95jasmith/EMI-sensor/Building sensor/Code/Matlab/Flippo Farm/15_63030Hz.jpg

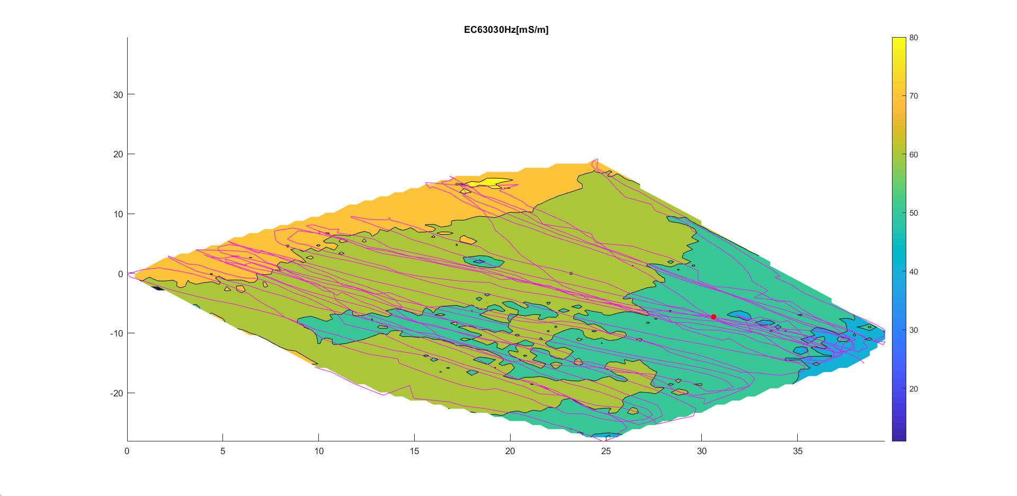
Building sensor/Code/Matlab/Flippo Farm/15_63030Hz.jpg
