95jasmith/EMI-sensor/Building sensor/Code/Matlab/Flippo Farm 2/TotalEC2.jpg

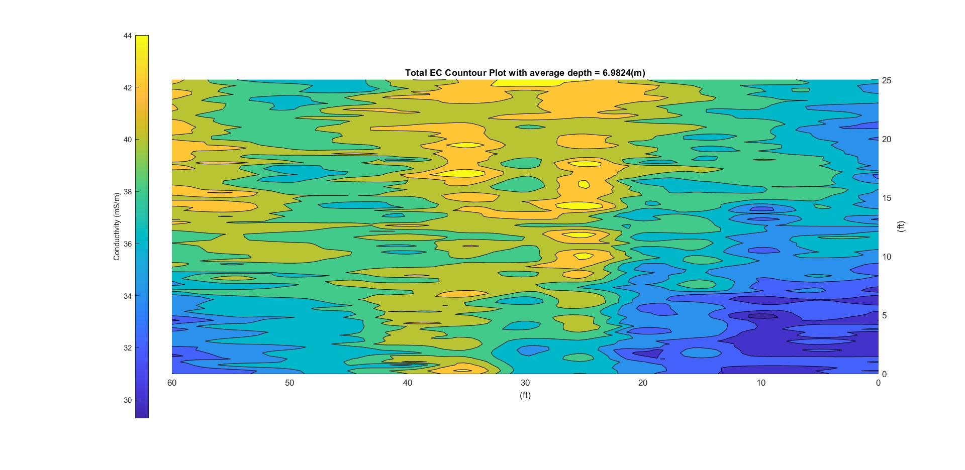
Building sensor/Code/Matlab/Flippo Farm 2/TotalEC2.jpg
