95jasmith/EMI-sensor/README.md

# EMI-sensor

This folder is for EMI conductivity meter being developed by Jonah Smith at Kansas State University for Dr. Stacey Kulesza in the Civil 
Engineering department.
All files are for the prototype and have only had limited testing.
