95jasmith/EMI-sensor/Building sensor/Code/FPGA/EMI_Sensor_FPGA/EMI_Sensor_FPGA_Implmnt/synlog/report/EMI_Sensor_FPGA_fpga_mapper_notes.txt

@N: MF248 |Running in 64-bit mode.
@N: MF666 |Clock conversion enabled. (Command "set_option -fix_gated_and_generated_clocks 1" in the project file.)
@N: MT206 |Auto Constrain mode is enabled
@N: BW103 |The default time unit for the Synopsys Constraint File (SDC or FDC) is 1ns.
@N: BW107 |Synopsys Constraint File capacitance units using default value of 1pF 
@N: FX1056 |Writing EDF file: C:\Users\97jsm\Documents\GitHub\EMI-sensor\Building sensor\Code\FPGA\EMI_Sensor_FPGA\EMI_Sensor_FPGA_Implmnt\EMI_Sensor_FPGA.edf
@N: MT320 |This timing report is an estimate of place and route data. For final timing results, use the FPGA vendor place and route report.
@N: MT322 |Clock constraints include only register-to-register paths associated with each individual clock.
