95jasmith/EMI-sensor/Building sensor/Code/FPGA/EMI_Sensor_FPGA/EMI_Sensor_FPGA_Implmnt/synlog/report/EMI_Sensor_FPGA_premap_notes.txt

@N: MF248 |Running in 64-bit mode.
@N: MF666 |Clock conversion enabled. (Command "set_option -fix_gated_and_generated_clocks 1" in the project file.)
@N: BN225 |Writing default property annotation file C:\Users\97jsm\Documents\GitHub\EMI-sensor\Building sensor\Code\FPGA\EMI_Sensor_FPGA\EMI_Sensor_FPGA_Implmnt\EMI_Sensor_FPGA.sap.
