95jasmith/EMI-sensor/Building sensor/Paper Summaries/McNeill 1980.docx

Title: | Electromagnetic Terrain Conductivity Measurement at Low Induction Numbers
Author(s): | JD McNeill
Date: | October, 1980
Publication: | Technical Report TN-6
Publisher: | Geonics: Mississauga, ON, Canada
Pages: | 1-15
Key Words:

Summary of the Paper

This is a core paper and is citied by most other papers. Introduces the idea of Apparent Electrical Conductivity (ECa). Also includes the assumptions for Low Induction Numbers (LIN) and the then derived linear approximation for finding ECa from the measured H-field. Also includes some case studies and methods for using there designed sensor to measure ECa
