95jasmith/EMI-sensor/Building sensor/Papers/GEM-2 uniform half-space response and skin depth (2).xls

Hz-S/m | I ppm | Q ppm
0.01 | 2e-05 | 0.03
0.1 | 0.0006 | 0.35
1 | 0.02 | 3.5
10 | 0.7 | 40
100 | 20 | 350
1000 | 500 | 3000
10000 | 9500 | 21000
100000 | 80000 | 70000
1000000 | 200000 | 40000
10000000 | 200000 | 5000
100000000 | 200000 | 250
from Won et al, 1996
GEM-2…
 |  |  |  |  |  |  |  |  |  |  | SKIN DEPTH = SQRT(2/(omega*sigma*mu))
 |  |  |  |  |  |  |  |  |  |  |  | frequency | conductivity | rel permeability
 |  |  |  |  |  |  |  |  |  |  |  | f(Hz) | sigma (mS/m) | non-dim
 |  | example: clay with conductivity of 12 mS/m |  |  |  |  |  |  |  | ENTER VALUES |  | 63030 | 13 | 1
 |  |  | sigma (mS/m) = |  | 13 |  |  |  |  | skin depth (m) = |  | 15.915X10^3 * SQRT(1/f*sigma*mur)
 |  |  | sigma (mS/m) |  | frequency (Hz) |  | I ppm | Q ppm
 |  |  |  |  |  |  |  |  |  | skin depth (m) = |  | 17.58
 |  |  | 13 |  | 450 | 5.85 | 0.4 | 23.2
 | computed values from |  | 13 |  | 870 | 11.31 | 1.0 | 44.5
 | interpolation of nomogram |  | 13 |  | 1710 | 22.23 | 3.3 | 82.1
 | above |  | 13 |  | 3330 | 43.29 | 7.8 | 154.7 | effective depth of penetration = SQRT(SKIN DEPTH) = |  |  |  |  | 4.2 | m
 |  |  | 13 |  | 6450 | 83.85 | 16.5 | 294.4
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
