95jasmith/EMI-sensor/GPS Stuff/gem2_GPS.JPG

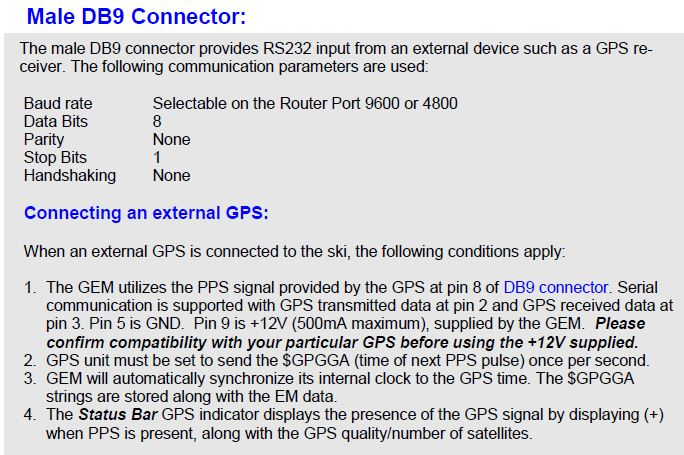
GPS Stuff/gem2_GPS.JPG
