95jasmith/EMI-sensor/Poster/Math 799 Poster1.jpg

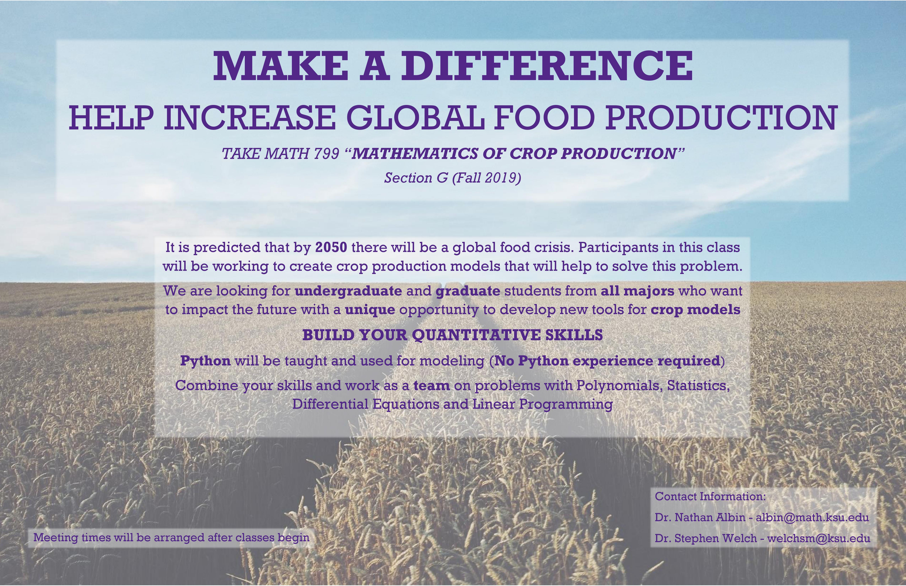
Poster/Math 799 Poster1.jpg
