95jasmith/EMI-sensor/Poster/wheat-691935_1920.jpg

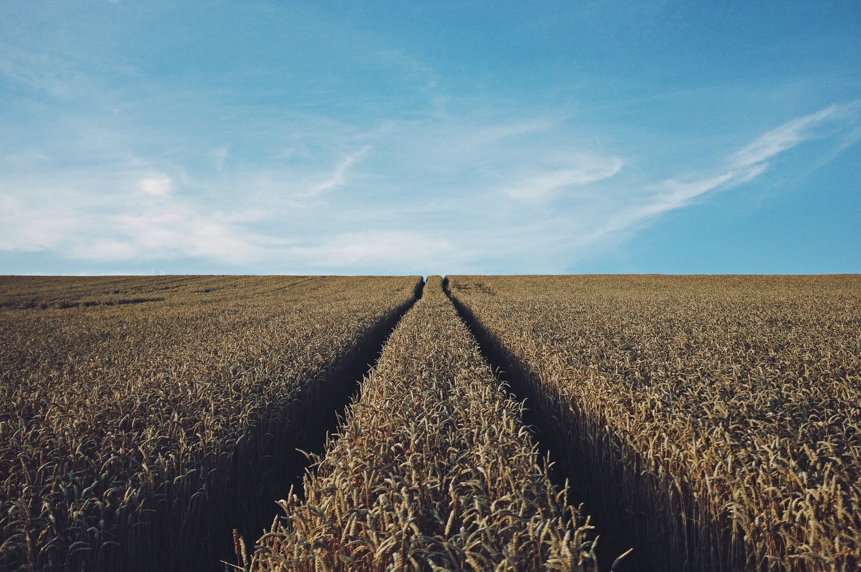
Poster/wheat-691935_1920.jpg
