95jasmith/EMI-sensor/Building sensor/Designs/KiCAD/2020-02-25_19-55-28/STEP/DDW44_8P26X4P31.step

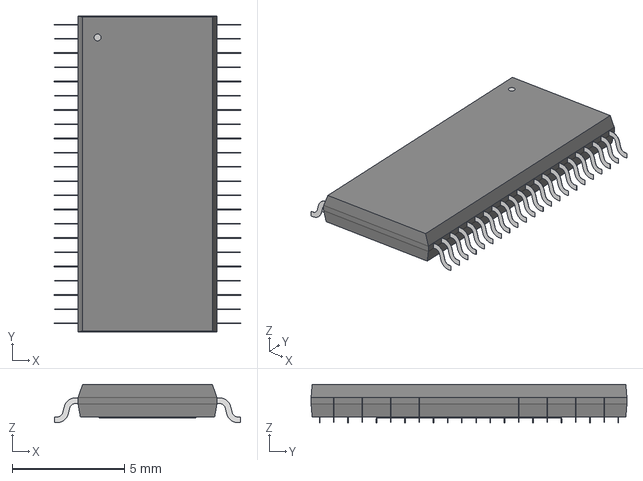
[picture p12: CAD file, 2020-02-27]
Building sensor/Designs/KiCAD/2020-02-25_19-55-28/STEP/DDW44_8P26X4P31.step
8.30 x 14.1 x 1.70 mm
