95jasmith/EMI-sensor/Building sensor/Designs/KiCAD/ul_BD65491FVE2/2020-02-20_15-11-28/STEP/SSOP-B16-L.step

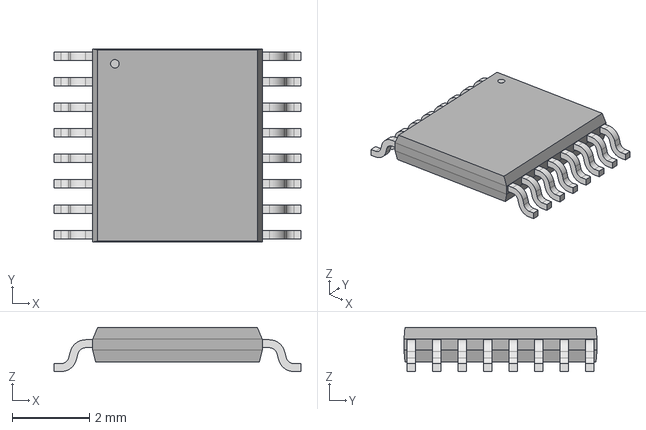
[picture p13: CAD file, 2020-02-27]
Building sensor/Designs/KiCAD/ul_BD65491FVE2/2020-02-20_15-11-28/STEP/SSOP-B16-L.step
6.40 x 5.00 x 1.15 mm
