95jasmith/EMI-sensor/(list of files, cad)

Other CAD files:
Building sensor/Designs/KiCAD/2020-02-25_19-55-50/STL/DDW44_8P26X4P31.stp
Building sensor/Designs/KiCAD/2020-02-25_19-55-28/STEP/DDW44_8P26X4P31-M.step
Building sensor/Designs/KiCAD/2020-02-25_19-55-50/STL/DDW44_8P26X4P31-M.stp
Building sensor/Designs/KiCAD/ul_BD65491FVE2/2020-02-20_15-11-28/STEP/SSOP-B16.step
Building sensor/Designs/KiCAD/ul_BD65491FVE2/2020-02-20_15-11-34/STL/SSOP-B16-M.stp
Building sensor/Designs/KiCAD/2020-02-25_19-55-28/STEP/DDW44_8P26X4P31-L.step
Building sensor/Designs/KiCAD/2020-02-25_19-55-50/STL/DDW44_8P26X4P31-L.stp
Building sensor/Designs/KiCAD/ul_BD65491FVE2/2020-02-20_15-11-28/STEP/SSOP-B16-M.step
Building sensor/Designs/KiCAD/ul_BD65491FVE2/2020-02-20_15-11-34/STL/SSOP-B16-L.stp
Building sensor/Designs/KiCAD/2020-02-25_19-55-50/STL/DDW44_8P26X4P31-L.stl
Building sensor/Designs/KiCAD/2020-02-25_19-55-50/STL/DDW44_8P26X4P31-M.stl
Building sensor/Designs/KiCAD/2020-02-25_19-55-50/STL/DDW44_8P26X4P31.stl
Building sensor/Designs/KiCAD/ul_BD65491FVE2/2020-02-20_15-11-34/STL/SSOP-B16-L.stl
Building sensor/Designs/KiCAD/ul_BD65491FVE2/2020-02-20_15-11-34/STL/SSOP-B16-M.stl
Building sensor/Designs/KiCAD/ul_BD65491FVE2/2020-02-20_15-11-34/STL/SSOP-B16.stl
