95jasmith/EMI-sensor/Building sensor/Code/FPGA/EMI_Sensor_FPGA/EMI_Sensor_FPGA_Implmnt/syntmp/EMI_Sensor_FPGA_srr.htm

#Build: Synplify Pro L-2016.09L+ice40, Build 077R, Dec  2 2016
#install: C:\lscc\iCEcube2.2017.08\synpbase
#OS: Windows 8 6.2
#Hostname: DESKTOP-E7PTEOJ

# Tue Oct 15 14:39:21 2019

#Implementation: EMI_Sensor_FPGA_Implmnt

Synopsys HDL Compiler, version comp2016q3p1, Build 141R, built Dec  5 2016
@N: :  | Running in 64-bit mode 
Copyright (C) 1994-2016 Synopsys, Inc. All rights reserved. This Synopsys software and all associated documentation are proprietary to Synopsys, Inc. and may only be used pursuant to the terms and conditions of a written license agreement with Synopsys, Inc. All other use, reproduction, modification, or distribution of the Synopsys software or the associated documentation is strictly prohibited.

Synopsys Verilog Compiler, version comp2016q3p1, Build 141R, built Dec  5 2016
@N: :  | Running in 64-bit mode 
Copyright (C) 1994-2016 Synopsys, Inc. All rights reserved. This Synopsys software and all associated documentation are proprietary to Synopsys, Inc. and may only be used pursuant to the terms and conditions of a written license agreement with Synopsys, Inc. All other use, reproduction, modification, or distribution of the Synopsys software or the associated documentation is strictly prohibited.

@I::"C:\lscc\iCEcube2.2017.08\synpbase\lib\generic\sb_ice40.v" (library work)
@I::"C:\lscc\iCEcube2.2017.08\synpbase\lib\vlog\hypermods.v" (library __hyper__lib__)
@I::"C:\lscc\iCEcube2.2017.08\synpbase\lib\vlog\umr_capim.v" (library snps_haps)
@I::"C:\lscc\iCEcube2.2017.08\synpbase\lib\vlog\scemi_objects.v" (library snps_haps)
@I::"C:\lscc\iCEcube2.2017.08\synpbase\lib\vlog\scemi_pipes.svh" (library snps_haps)
@I::"C:\Users\97jsm\Documents\GitHub\EMI-sensor\Building sensor\Code\FPGA\Toggle_Pin_Test.v" (library work)
Verilog syntax check successful!
File C:\Users\97jsm\Documents\GitHub\EMI-sensor\Building sensor\Code\FPGA\Toggle_Pin_Test.v changed - recompiling
Selecting top level module Toggle_Pin_Test
@N:CG364 : Toggle_Pin_Test.v(1) | Synthesizing module Toggle_Pin_Test in library work.

At c_ver Exit (Real Time elapsed 0h:00m:01s; CPU Time elapsed 0h:00m:00s; Memory used current: 70MB peak: 71MB)

Process took 0h:00m:01s realtime, 0h:00m:01s cputime

Process completed successfully.
# Tue Oct 15 14:39:23 2019

###########################################################]
Synopsys Netlist Linker, version comp2016q3p1, Build 141R, built Dec  5 2016
@N: :  | Running in 64-bit mode 
@N:NF107 : Toggle_Pin_Test.v(1) | Selected library: work cell: Toggle_Pin_Test view verilog as top level
@N:NF107 : Toggle_Pin_Test.v(1) | Selected library: work cell: Toggle_Pin_Test view verilog as top level

At syn_nfilter Exit (Real Time elapsed 0h:00m:00s; CPU Time elapsed 0h:00m:00s; Memory used current: 67MB peak: 68MB)

Process took 0h:00m:01s realtime, 0h:00m:01s cputime

Process completed successfully.
# Tue Oct 15 14:39:24 2019

###########################################################]
@END

At c_hdl Exit (Real Time elapsed 0h:00m:03s; CPU Time elapsed 0h:00m:01s; Memory used current: 3MB peak: 4MB)

Process took 0h:00m:03s realtime, 0h:00m:01s cputime

Process completed successfully.
# Tue Oct 15 14:39:24 2019

###########################################################]
Synopsys Netlist Linker, version comp2016q3p1, Build 141R, built Dec  5 2016
@N: :  | Running in 64-bit mode 
File C:\Users\97jsm\Documents\GitHub\EMI-sensor\Building sensor\Code\FPGA\EMI_Sensor_FPGA\EMI_Sensor_FPGA_Implmnt\synwork\EMI_Sensor_FPGA_comp.srs changed - recompiling
@N:NF107 : Toggle_Pin_Test.v(1) | Selected library: work cell: Toggle_Pin_Test view verilog as top level
@N:NF107 : Toggle_Pin_Test.v(1) | Selected library: work cell: Toggle_Pin_Test view verilog as top level

At syn_nfilter Exit (Real Time elapsed 0h:00m:00s; CPU Time elapsed 0h:00m:00s; Memory used current: 67MB peak: 68MB)

Process took 0h:00m:01s realtime, 0h:00m:01s cputime

Process completed successfully.
# Tue Oct 15 14:39:26 2019

###########################################################]
Pre-mapping Report

# Tue Oct 15 14:39:27 2019

Synopsys Lattice Technology Pre-mapping, Version maplat, Build 1612R, Built Dec  5 2016 10:31:39
Copyright (C) 1994-2016 Synopsys, Inc. All rights reserved. This Synopsys software and all associated documentation are proprietary to Synopsys, Inc. and may only be used pursuant to the terms and conditions of a written license agreement with Synopsys, Inc. All other use, reproduction, modification, or distribution of the Synopsys software or the associated documentation is strictly prohibited.
Product Version L-2016.09L+ice40

Mapper Startup Complete (Real Time elapsed 0h:00m:00s; CPU Time elapsed 0h:00m:00s; Memory used current: 99MB peak: 100MB)

@A:MF827 :  | No constraint file specified. 
@L: C:\Users\97jsm\Documents\GitHub\EMI-sensor\Building sensor\Code\FPGA\EMI_Sensor_FPGA\EMI_Sensor_FPGA_Implmnt\EMI_Sensor_FPGA_scck.rpt 
Printing clock  summary report in "C:\Users\97jsm\Documents\GitHub\EMI-sensor\Building sensor\Code\FPGA\EMI_Sensor_FPGA\EMI_Sensor_FPGA_Implmnt\EMI_Sensor_FPGA_scck.rpt" file 
@N:MF248 :  | Running in 64-bit mode. 
@N:MF666 :  | Clock conversion enabled. (Command "set_option -fix_gated_and_generated_clocks 1" in the project file.) 

Design Input Complete (Real Time elapsed 0h:00m:00s; CPU Time elapsed 0h:00m:00s; Memory used current: 100MB peak: 102MB)

Mapper Initialization Complete (Real Time elapsed 0h:00m:00s; CPU Time elapsed 0h:00m:00s; Memory used current: 100MB peak: 102MB)

Start loading timing files (Real Time elapsed 0h:00m:00s; CPU Time elapsed 0h:00m:00s; Memory used current: 101MB peak: 102MB)

Finished loading timing files (Real Time elapsed 0h:00m:00s; CPU Time elapsed 0h:00m:00s; Memory used current: 101MB peak: 103MB)

ICG Latch Removal Summary:
Number of ICG latches removed:	0
Number of ICG latches not removed:	0
syn_allowed_resources : blockrams=30  set on top level netlist Toggle_Pin_Test

Finished netlist restructuring (Real Time elapsed 0h:00m:02s; CPU Time elapsed 0h:00m:01s; Memory used current: 132MB peak: 134MB)

Clock Summary
*****************

Start     Requested     Requested     Clock     Clock     Clock
Clock     Frequency     Period        Type      Group     Load 
---------------------------------------------------------------
===============================================================

Finished Pre Mapping Phase.
@N:BN225 :  | Writing default property annotation file C:\Users\97jsm\Documents\GitHub\EMI-sensor\Building sensor\Code\FPGA\EMI_Sensor_FPGA\EMI_Sensor_FPGA_Implmnt\EMI_Sensor_FPGA.sap. 

Starting constraint checker (Real Time elapsed 0h:00m:02s; CPU Time elapsed 0h:00m:02s; Memory used current: 132MB peak: 134MB)

None
None

Finished constraint checker (Real Time elapsed 0h:00m:02s; CPU Time elapsed 0h:00m:02s; Memory used current: 132MB peak: 134MB)

Pre-mapping successful!

At Mapper Exit (Real Time elapsed 0h:00m:03s; CPU Time elapsed 0h:00m:02s; Memory used current: 47MB peak: 134MB)

Process took 0h:00m:03s realtime, 0h:00m:02s cputime
# Tue Oct 15 14:39:31 2019

###########################################################]
Map & Optimize Report

# Tue Oct 15 14:39:32 2019

Synopsys Lattice Technology Mapper, Version maplat, Build 1612R, Built Dec  5 2016 10:31:39
Copyright (C) 1994-2016 Synopsys, Inc. All rights reserved. This Synopsys software and all associated documentation are proprietary to Synopsys, Inc. and may only be used pursuant to the terms and conditions of a written license agreement with Synopsys, Inc. All other use, reproduction, modification, or distribution of the Synopsys software or the associated documentation is strictly prohibited.
Product Version L-2016.09L+ice40

Mapper Startup Complete (Real Time elapsed 0h:00m:00s; CPU Time elapsed 0h:00m:00s; Memory used current: 99MB peak: 100MB)

@N:MF248 :  | Running in 64-bit mode. 
@N:MF666 :  | Clock conversion enabled. (Command "set_option -fix_gated_and_generated_clocks 1" in the project file.) 

Design Input Complete (Real Time elapsed 0h:00m:00s; CPU Time elapsed 0h:00m:00s; Memory used current: 100MB peak: 101MB)

Mapper Initialization Complete (Real Time elapsed 0h:00m:00s; CPU Time elapsed 0h:00m:00s; Memory used current: 100MB peak: 101MB)

Start loading timing files (Real Time elapsed 0h:00m:00s; CPU Time elapsed 0h:00m:00s; Memory used current: 101MB peak: 102MB)

Finished loading timing files (Real Time elapsed 0h:00m:00s; CPU Time elapsed 0h:00m:00s; Memory used current: 101MB peak: 104MB)

Starting Optimization and Mapping (Real Time elapsed 0h:00m:01s; CPU Time elapsed 0h:00m:01s; Memory used current: 132MB peak: 134MB)

Available hyper_sources - for debug and ip models
	None Found

@N:MT206 :  | Auto Constrain mode is enabled 

Finished RTL optimizations (Real Time elapsed 0h:00m:01s; CPU Time elapsed 0h:00m:01s; Memory used current: 132MB peak: 134MB)

Starting factoring (Real Time elapsed 0h:00m:01s; CPU Time elapsed 0h:00m:01s; Memory used current: 132MB peak: 134MB)

Finished factoring (Real Time elapsed 0h:00m:01s; CPU Time elapsed 0h:00m:01s; Memory used current: 132MB peak: 134MB)

Finished gated-clock and generated-clock conversion (Real Time elapsed 0h:00m:01s; CPU Time elapsed 0h:00m:01s; Memory used current: 132MB peak: 134MB)

Finished generic timing optimizations - Pass 1 (Real Time elapsed 0h:00m:01s; CPU Time elapsed 0h:00m:01s; Memory used current: 132MB peak: 134MB)

Starting Early Timing Optimization (Real Time elapsed 0h:00m:01s; CPU Time elapsed 0h:00m:01s; Memory used current: 132MB peak: 134MB)

Finished Early Timing Optimization (Real Time elapsed 0h:00m:01s; CPU Time elapsed 0h:00m:01s; Memory used current: 132MB peak: 134MB)

Finished generic timing optimizations - Pass 2 (Real Time elapsed 0h:00m:01s; CPU Time elapsed 0h:00m:01s; Memory used current: 132MB peak: 134MB)

Finished preparing to map (Real Time elapsed 0h:00m:01s; CPU Time elapsed 0h:00m:01s; Memory used current: 132MB peak: 134MB)

Finished technology mapping (Real Time elapsed 0h:00m:01s; CPU Time elapsed 0h:00m:01s; Memory used current: 132MB peak: 134MB)

Pass		 CPU time		Worst Slack		Luts / Registers
------------------------------------------------------------

Finished technology timing optimizations and critical path resynthesis (Real Time elapsed 0h:00m:01s; CPU Time elapsed 0h:00m:01s; Memory used current: 132MB peak: 134MB)

Finished restoring hierarchy (Real Time elapsed 0h:00m:01s; CPU Time elapsed 0h:00m:01s; Memory used current: 132MB peak: 134MB)

@S |Clock Optimization Summary

#### START OF CLOCK OPTIMIZATION REPORT #####[

0 non-gated/non-generated clock tree(s) driving 0 clock pin(s) of sequential element(s)
0 gated/generated clock tree(s) driving 0 clock pin(s) of sequential element(s)
0 instances converted, 0 sequential instances remain driven by gated/generated clocks

##### END OF CLOCK OPTIMIZATION REPORT ######]

Start Writing Netlists (Real Time elapsed 0h:00m:02s; CPU Time elapsed 0h:00m:01s; Memory used current: 107MB peak: 134MB)

Writing Analyst data base C:\Users\97jsm\Documents\GitHub\EMI-sensor\Building sensor\Code\FPGA\EMI_Sensor_FPGA\EMI_Sensor_FPGA_Implmnt\synwork\EMI_Sensor_FPGA_m.srm

Finished Writing Netlist Databases (Real Time elapsed 0h:00m:02s; CPU Time elapsed 0h:00m:02s; Memory used current: 131MB peak: 134MB)

Writing EDIF Netlist and constraint files
@N:BW103 :  | The default time unit for the Synopsys Constraint File (SDC or FDC) is 1ns. 
@N:BW107 :  | Synopsys Constraint File capacitance units using default value of 1pF  
@N:FX1056 :  | Writing EDF file: C:\Users\97jsm\Documents\GitHub\EMI-sensor\Building sensor\Code\FPGA\EMI_Sensor_FPGA\EMI_Sensor_FPGA_Implmnt\EMI_Sensor_FPGA.edf 
L-2016.09L+ice40

Finished Writing EDIF Netlist and constraint files (Real Time elapsed 0h:00m:03s; CPU Time elapsed 0h:00m:03s; Memory used current: 132MB peak: 134MB)

Start final timing analysis (Real Time elapsed 0h:00m:04s; CPU Time elapsed 0h:00m:03s; Memory used current: 132MB peak: 134MB)

##### START OF TIMING REPORT #####[
# Timing Report written on Tue Oct 15 14:39:36 2019
#

Top view:               Toggle_Pin_Test
Requested Frequency:    1.0 MHz
Wire load mode:         top
Paths requested:        5
Constraint File(s):    
@N:MT320 :  | This timing report is an estimate of place and route data. For final timing results, use the FPGA vendor place and route report. 

@N:MT322 :  | Clock constraints include only register-to-register paths associated with each individual clock. 

Performance Summary
*******************

Worst slack in design: NA

Clock Relationships
*******************

Clocks            |    rise  to  rise   |    fall  to  fall   |    rise  to  fall   |    fall  to  rise 
--------------------------------------------------------------------------------------------------------
Starting  Ending  |  constraint  slack  |  constraint  slack  |  constraint  slack  |  constraint  slack
--------------------------------------------------------------------------------------------------------
========================================================================================================
 Note: 'No paths' indicates there are no paths in the design for that pair of clock edges.
       'Diff grp' indicates that paths exist but the starting clock and ending clock are in different clock groups.

Interface Information 
*********************

No IO constraint found

##### END OF TIMING REPORT #####]

Timing exceptions that could not be applied
None

Finished final timing analysis (Real Time elapsed 0h:00m:04s; CPU Time elapsed 0h:00m:03s; Memory used current: 133MB peak: 134MB)

Finished timing report (Real Time elapsed 0h:00m:04s; CPU Time elapsed 0h:00m:03s; Memory used current: 133MB peak: 134MB)

---------------------------------------
Resource Usage Report for Toggle_Pin_Test 

Mapping to part: ice40up5ksg48
Cell usage:
SB_LUT4         0 uses

I/O ports: 2
I/O primitives: 2
SB_IO          2 uses

I/O Register bits:                  0
Register bits not including I/Os:   0 (0%)
Total load per clock:

@S |Mapping Summary:
Total  LUTs: 0 (0%)

Mapper successful!

At Mapper Exit (Real Time elapsed 0h:00m:04s; CPU Time elapsed 0h:00m:04s; Memory used current: 27MB peak: 134MB)

Process took 0h:00m:05s realtime, 0h:00m:04s cputime
# Tue Oct 15 14:39:37 2019

###########################################################]
