95jasmith/EMI-sensor/Building sensor/Code/Matlab/Flippo Farm 2/EC5310Hz2.jpg

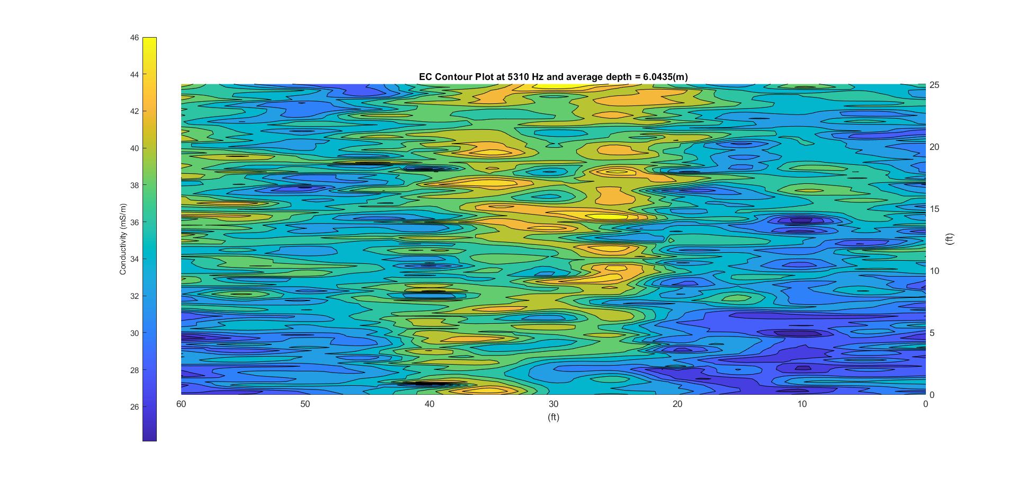
Building sensor/Code/Matlab/Flippo Farm 2/EC5310Hz2.jpg
