95jasmith/EMI-sensor/Building sensor/Code/Matlab/Flippo Farm 2/EC18330Hz.jpg

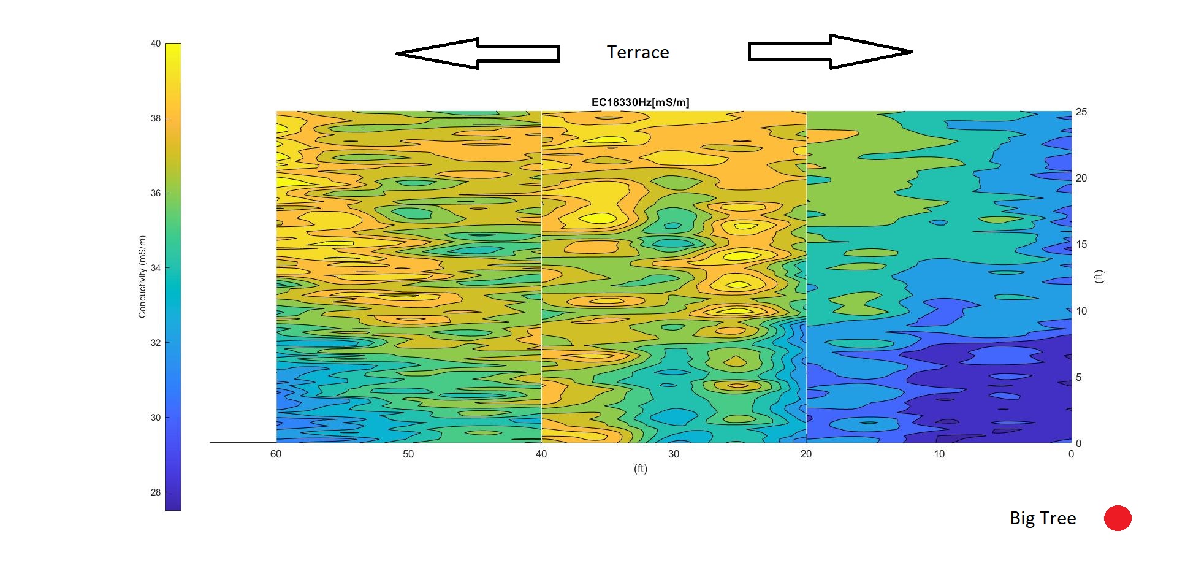
Building sensor/Code/Matlab/Flippo Farm 2/EC18330Hz.jpg
