95jasmith/EMI-sensor/Building sensor/Code/Matlab/Flippo Farm 2/EC63030Hz2.jpg

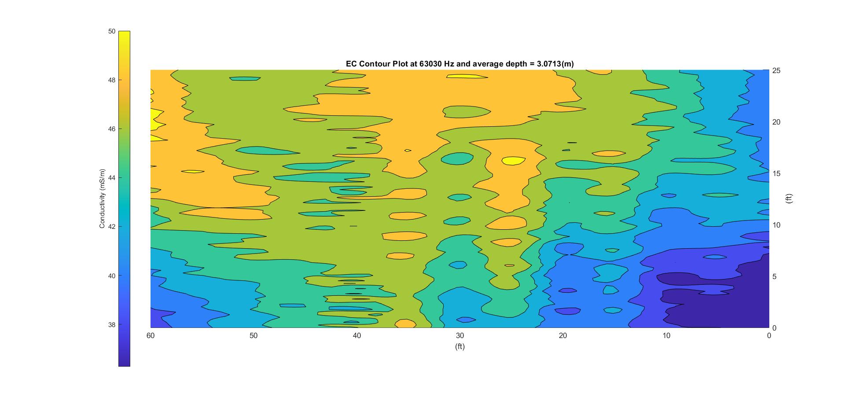
Building sensor/Code/Matlab/Flippo Farm 2/EC63030Hz2.jpg
