95jasmith/EMI-sensor/Building sensor/Code/Matlab/Flippo Farm/15_450Hz - Copy.jpg

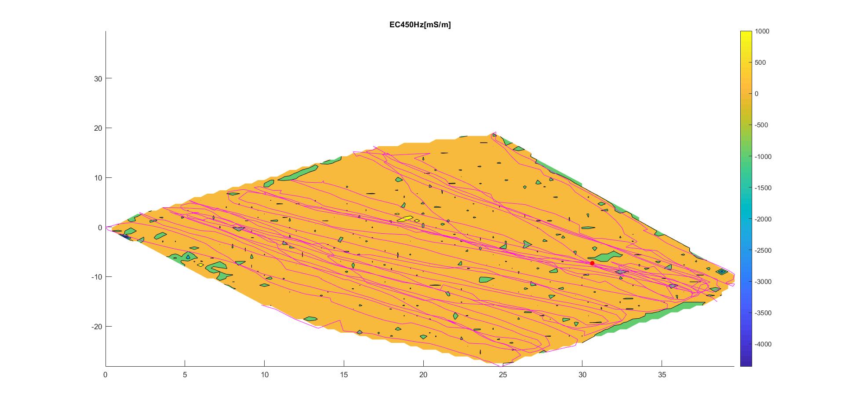
Building sensor/Code/Matlab/Flippo Farm/15_450Hz - Copy.jpg
