95jasmith/EMI-sensor/Building sensor/Code/Matlab/Flippo Farm/16_Total.jpg

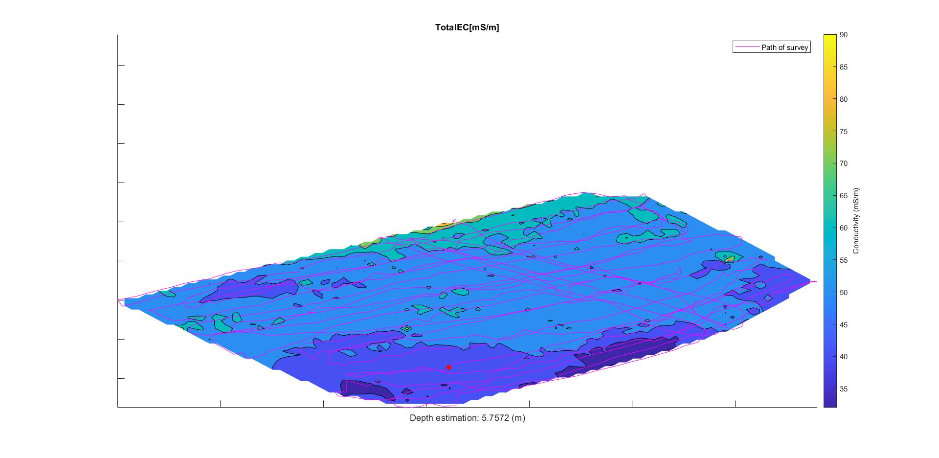
Building sensor/Code/Matlab/Flippo Farm/16_Total.jpg
