95jasmith/EMI-sensor/Building sensor/Code/Matlab/Flippo Farm/18_210Hz.jpg

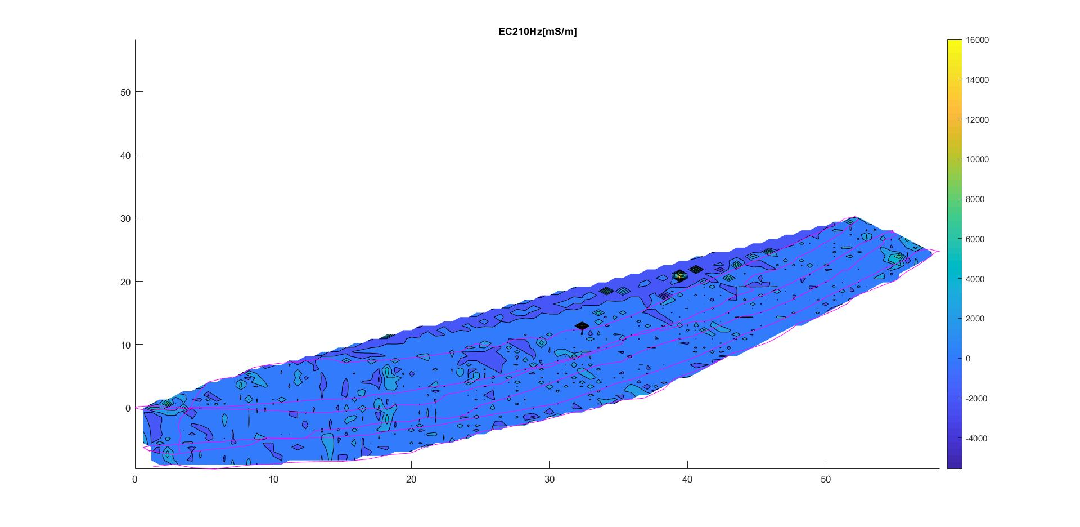
Building sensor/Code/Matlab/Flippo Farm/18_210Hz.jpg
