95jasmith/EMI-sensor/Building sensor/Code/Matlab/Flippo Farm/18_TotalEdit - Copy.jpg

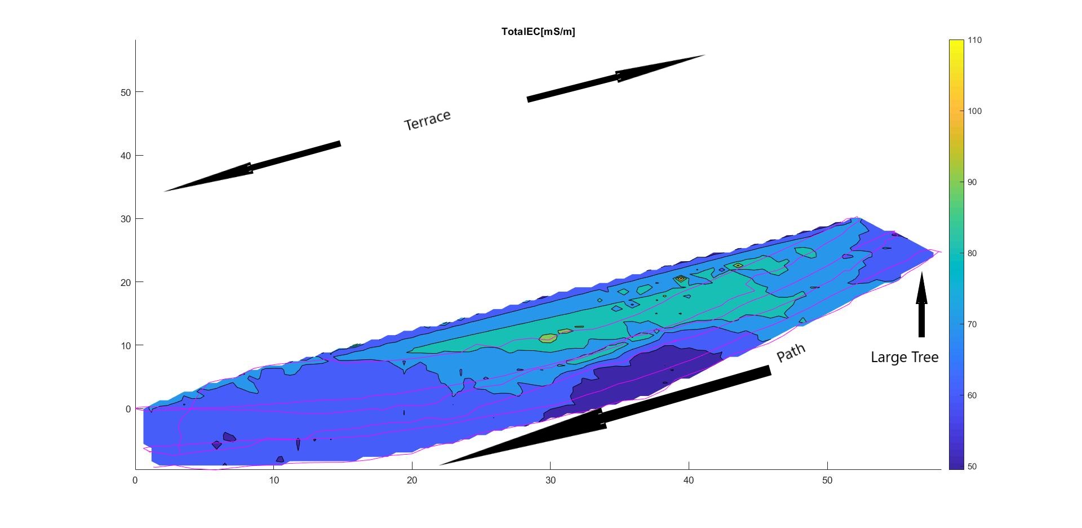
Building sensor/Code/Matlab/Flippo Farm/18_TotalEdit - Copy.jpg
