95jasmith/EMI-sensor/Building sensor/Code/Matlab/Flippo Farm/19_Total.jpg

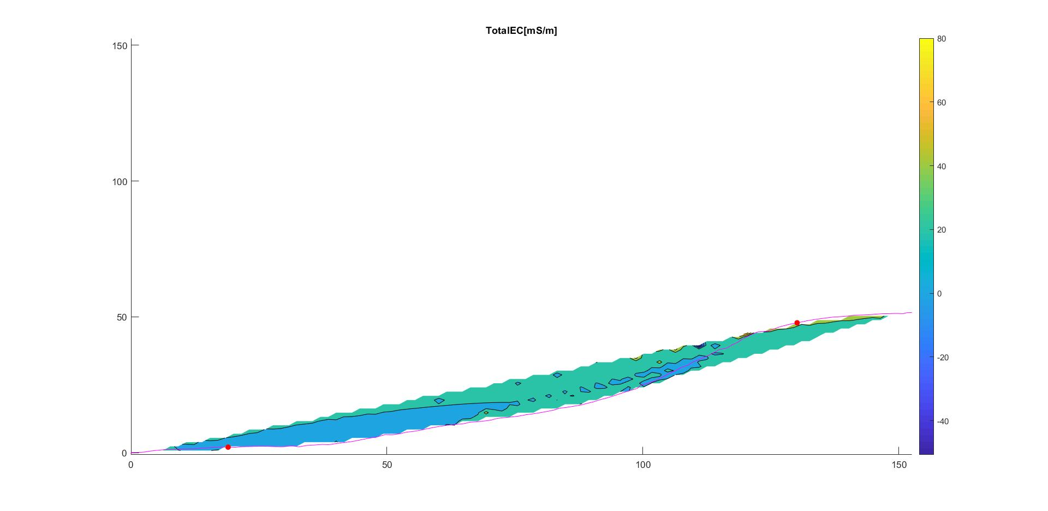
Building sensor/Code/Matlab/Flippo Farm/19_Total.jpg
