95jasmith/EMI-sensor/Building sensor/Code/Matlab/Set2_69510.jpg

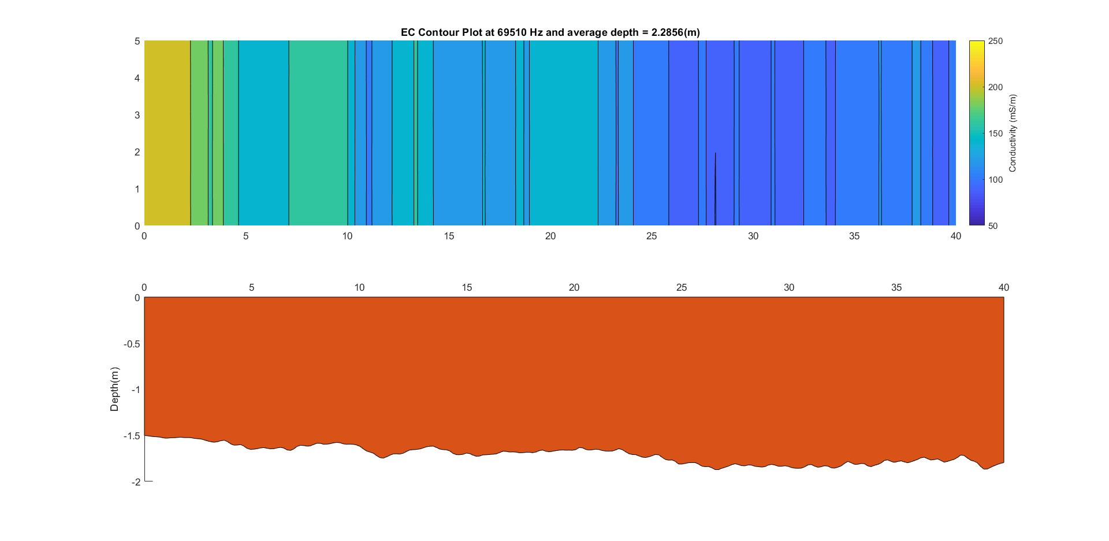
Building sensor/Code/Matlab/Set2_69510.jpg
