95jasmith/EMI-sensor/Building sensor/nc1.png

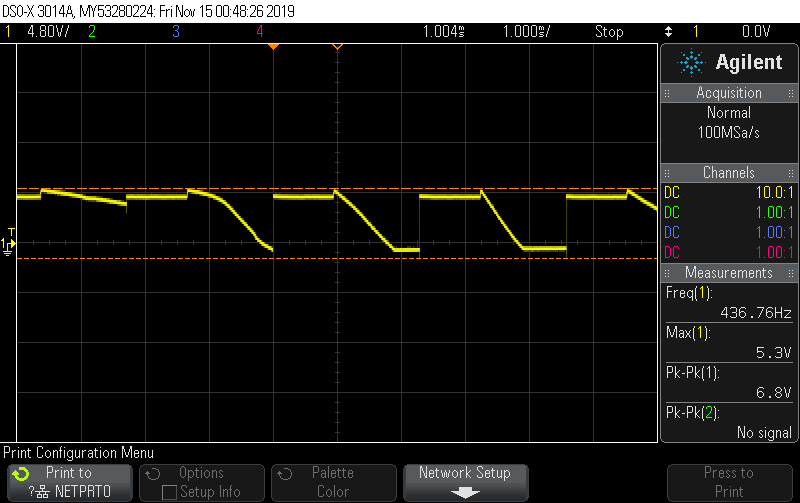
Building sensor/nc1.png
