95jasmith/EMI-sensor/Building sensor/wc1.png

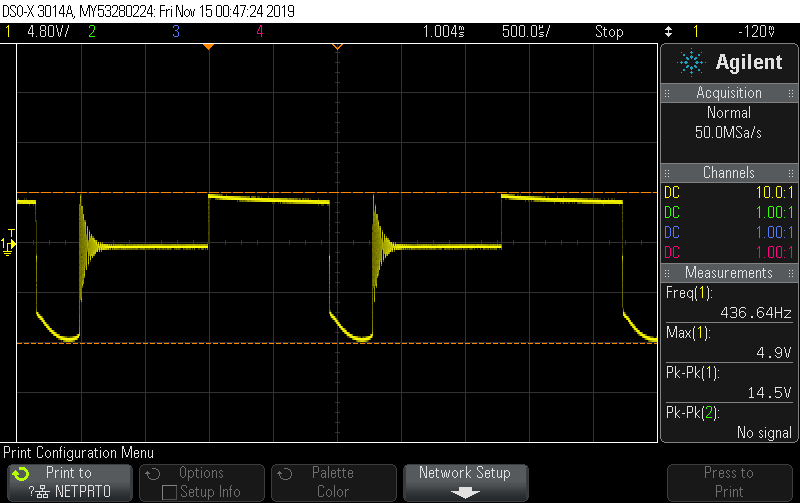
Building sensor/wc1.png
