95jasmith/EMI-sensor/GEM2_LIB_v1.4/GEM2_LIB/Test/UpgradeLog.htm

# Migration Report - TestGEM

## Overview

| Project | Path | Errors | Warnings | Messages
| TestGEM | TestGEM.vcproj | 0 | 4 | 3

## Solution and projects

### TestGEM

| Message
| TestGEM.vcproj: This application has been updated to include settings related to the User Account Control (UAC) feature of Windows Vista. By default, when run on Windows Vista with UAC enabled, this application is marked to run with the same privileges as the process that launched it. This marking also disables the application from running with virtualization. You can change UAC related settings from the Property Pages of the project.
| TestGEM.vcproj: VCWebServiceProxyGeneratorTool is no longer supported. The tool has been removed from your project settings.
| TestGEM.vcproj: Attribute 'Detect64BitPortabilityProblems' of 'VCCLCompilerTool' is not supported in this version and has been removed during conversion.
| TestGEM.vcproj: Attribute 'Detect64BitPortabilityProblems' of 'VCCLCompilerTool' is not supported in this version and has been removed during conversion.
| Show 3 additional messages
| TestGEM.vcproj: Converting project file 'C:\ALLFF\PROJECTS\GEMV1.DLL.1.4\GEM_DLL\Test\TestGEM.vcproj'.
| TestGEM.vcproj: Web deployment to the local IIS server is no longer supported. The Web Deployment build tool has been removed from your project settings.
| TestGEM.vcproj: Done converting to new project file 'C:\ALLFF\PROJECTS\GEMV1.DLL.1.4\GEM_DLL\Test\TestGEM.vcxproj'.
| Hide 3 additional messages
