95jasmith/EMI-sensor/Building sensor/Code/Matlab/First set/testdoc.csv

X | Y | name3 | name4 | name5 | name6 | name7
1 | 2 | 3 | 4 | 5 | 6 | 7
3 | 4 | 5 | 6 | 7 | 8 | 9
