95jasmith/EMI-sensor/Gem data/First Test/07-xr-18jy-0f7_gem.inv.csv

Line | Sample | X | Y | Mark | Status | Time[ms] | Time[hhmmss.sss] | PowerLn | ResLayer_1 | ResLayer_2 | ResLayer_3 | ThiLayer_1 | ThiLayer_2 | FitError(%)
0 | 0 | 0.00 | 0.00 | 0 | 0 | 48013653.100 | 132013.6531 | 8.6 | 17.333 | 7.047 | 31.582 | 2.151 | 1.822 | 29.57
0 | 1 | 0.10 | 0.00 | 0 | 0 | 48013753.100 | 132013.7531 | 7.2 | 22.255 | 5.488 | 110.232 | 1.675 | 1.419 | 24.24
0 | 2 | 0.20 | 0.00 | 0 | 0 | 48013853.100 | 132013.8531 | 4.0 | 47.635 | 3.790 | 384.747 | 0.885 | 0.616 | 13.61
0 | 3 | 0.30 | 0.00 | 0 | 0 | 48013953.100 | 132013.9531 | 6.0 | 162.697 | 1.414 | 1342.898 | 1.023 | 0.267 | 13.44
0 | 4 | 0.40 | 0.00 | 0 | 0 | 48014053.100 | 132014.0531 | 7.7 | 225.305 | 1.052 | 1945.964 | 1.045 | 0.200 | 12.64
0 | 5 | 0.50 | 0.00 | 0 | 0 | 48014153.100 | 132014.1531 | 7.0 | 227.023 | 1.123 | 2000.000 | 0.995 | 0.200 | 10.94
0 | 6 | 0.59 | 0.00 | 0 | 0 | 48014253.100 | 132014.2531 | 5.6 | 241.825 | 1.028 | 2000.000 | 1.093 | 0.200 | 10.41
0 | 7 | 0.69 | 0.00 | 0 | 0 | 48014353.100 | 132014.3531 | 6.8 | 241.952 | 1.025 | 2000.000 | 1.070 | 0.200 | 11.89
0 | 8 | 0.79 | 0.00 | 0 | 0 | 48014453.100 | 132014.4531 | 4.5 | 238.918 | 1.210 | 2000.000 | 0.827 | 0.200 | 16.19
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
