95jasmith/EMI-sensor/Gem data/First Test/08-xr-18jy-1c7_gem.inv.csv

Line | Sample | X | Y | Mark | Status | Time[ms] | Time[hhmmss.sss] | PowerLn | ResLayer_1 | ResLayer_2 | ThiLayer_1 | FitError(%)
0 | 0 | 0.00 | 0.00 | 0 | 0 | 48935899.800 | 133535.8998 | 5.6 | 18.221 | 20.138 | 2.443 | 6.55
0 | 1 | 0.11 | 0.00 | 0 | 0 | 48935999.800 | 133535.9998 | 5.0 | 19.155 | 21.170 | 2.838 | 8.64
0 | 2 | 0.21 | 0.00 | 0 | 0 | 48936099.800 | 133536.0998 | 7.4 | 18.221 | 20.138 | 2.838 | 4.69
0 | 3 | 0.32 | 0.00 | 0 | 0 | 48936199.800 | 133536.1998 | 4.6 | 18.973 | 19.155 | 2.324 | 7.04
0 | 4 | 0.42 | 0.00 | 0 | 0 | 48936299.800 | 133536.2998 | 5.7 | 18.294 | 19.155 | 2.324 | 6.21
0 | 5 | 0.53 | 0.00 | 0 | 0 | 48936399.800 | 133536.3998 | 6.4 | 18.221 | 20.138 | 2.210 | 7.63
0 | 6 | 0.63 | 0.00 | 0 | 0 | 48936499.800 | 133536.4998 | 4.6 | 18.923 | 19.155 | 2.103 | 7.86
0 | 7 | 0.74 | 0.00 | 0 | 0 | 48936599.800 | 133536.5998 | 3.0 | 18.029 | 18.221 | 2.210 | 4.88
0 | 8 | 0.84 | 0.00 | 0 | 0 | 48936699.800 | 133536.6998 | 2.9 | 18.014 | 27.221 | 3.719 | 8.62
0 | 9 | 0.95 | 0.00 | 0 | 0 | 48936799.800 | 133536.7998 | 8.7 | 19.155 | 32.863 | 4.465 | 12.66
0 | 10 | 1.05 | 0.00 | 0 | 0 | 48936899.800 | 133536.8998 | 5.3 | 21.170 | 34.903 | 6.316 | 17.42
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
