95jasmith/EMI-sensor/Gem data/First Test/09-xr-18jy-208_gem.EC.csv

Line | Sample | X | Y | Mark | Status | Time[ms] | Time[hhmmss.sss] | PowerLn | I_450Hz | Q_450Hz | I_1530Hz | Q_1530Hz | I_5310Hz | Q_5310Hz | I_18330Hz | Q_18330Hz | I_63030Hz | Q_63030Hz | EC450Hz[mS/m] | EC1530Hz[mS/m] | EC5310Hz[mS/m] | EC18330Hz[mS/m] | EC63030Hz[mS/m] | TotalEC[mS/m] | MSusc450Hz[1/1000] | MSusc1530Hz[1/1000] | MSusc5310Hz[1/1000] | MSusc18330Hz[1/1000] | MSusc63030Hz[1/1000]
0 | 0 | 0.00 | 0.00 | 0 | 0 | 49257627.300 | 134057.6273 | 5.1 | 3.00780e+002 | 1.89774e+002 | 3.18135e+002 | 3.40702e+002 | 3.55224e+002 | 1.29099e+003 | 7.68574e+002 | 4.50169e+003 | 3.55229e+003 | 1.40067e+004 | 1.26890e+002 | 6.64160e+001 | 7.35815e+001 | 8.04980e+001 | 8.67293e+001 | 7.97130e+001 | 7.01052e-001 | 7.41518e-001 | 8.28002e-001 | 1.79235e+000 | 8.31110e+000
0 | 1 | 0.09 | 0.00 | 0 | 0 | 49257727.300 | 134057.7273 | 6.1 | 3.08504e+002 | 1.34069e+002 | 3.78348e+002 | 4.09424e+002 | 3.22633e+002 | 1.35673e+003 | 7.69006e+002 | 4.50503e+003 | 3.58745e+003 | 1.40473e+004 | 9.09041e+001 | 8.07219e+001 | 7.71334e+001 | 8.05690e+001 | 8.71517e+001 | 8.12005e+001 | 7.19062e-001 | 8.81926e-001 | 7.52006e-001 | 1.79336e+000 | 8.39371e+000
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
