95jasmith/EMI-sensor/Gem data/First Test/09-xr-18jy-208_gem.inv.csv

Line | Sample | X | Y | Mark | Status | Time[ms] | Time[hhmmss.sss] | PowerLn | ResLayer_1 | ResLayer_2 | ThiLayer_1 | FitError(%)
0 | 0 | 0.00 | 0.00 | 0 | 0 | 49257627.300 | 134057.6273 | 5.1 | 8.229 | 5.366 | 1.887 | 139.47
0 | 1 | 0.09 | 0.00 | 0 | 0 | 49257727.300 | 134057.7273 | 6.1 | 6.571 | 2.422 | 2.662 | 201.94
0 | 2 | 0.17 | 0.00 | 0 | 0 | 49257827.300 | 134057.8273 | 6.0 | 10.780 | 1.637 | 3.873 | 101.13
0 | 3 | 0.26 | 0.00 | 0 | 0 | 49257927.300 | 134057.9273 | 5.7 | 16.162 | 1.029 | 5.635 | 35.04
0 | 4 | 0.35 | 0.00 | 0 | 0 | 49258027.300 | 134058.0273 | 5.4 | 19.350 | 0.541 | 8.077 | 12.67
0 | 5 | 0.44 | 0.00 | 0 | 0 | 49258127.300 | 134058.1273 | 5.0 | 19.049 | 0.200 | 11.537 | 7.77
0 | 6 | 0.52 | 0.00 | 0 | 0 | 49258227.300 | 134058.2273 | 5.0 | 19.049 | 0.200 | 11.537 | 7.62
0 | 7 | 0.61 | 0.00 | 0 | 0 | 49258327.300 | 134058.3273 | 5.5 | 18.937 | 0.200 | 11.789 | 6.19
0 | 8 | 0.70 | 0.00 | 0 | 0 | 49258427.300 | 134058.4273 | 5.6 | 18.937 | 0.200 | 11.789 | 6.13
0 | 9 | 0.79 | 0.00 | 0 | 0 | 49258527.300 | 134058.5273 | 5.0 | 19.174 | 0.200 | 11.797 | 7.42
0 | 10 | 0.87 | 0.00 | 0 | 0 | 49258627.300 | 134058.6273 | 4.9 | 19.409 | 0.200 | 11.849 | 7.84
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
