95jasmith/EMI-sensor/Gem data/First Test/450Map.jpg

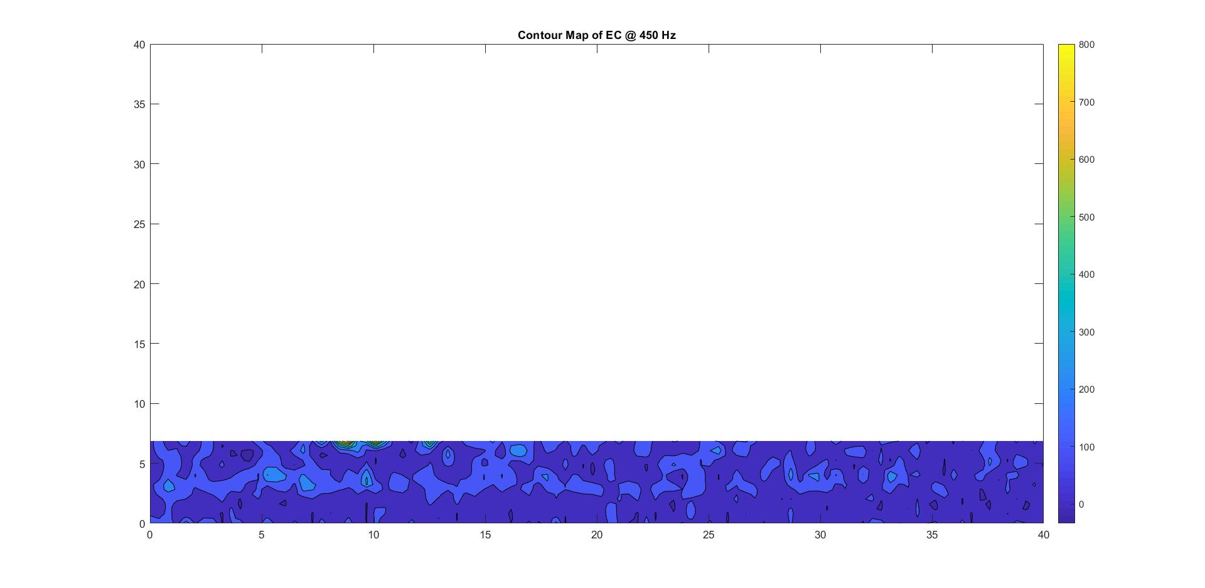
Gem data/First Test/450Map.jpg
