95jasmith/EMI-sensor/Gem data/First Test/5310Map.jpg

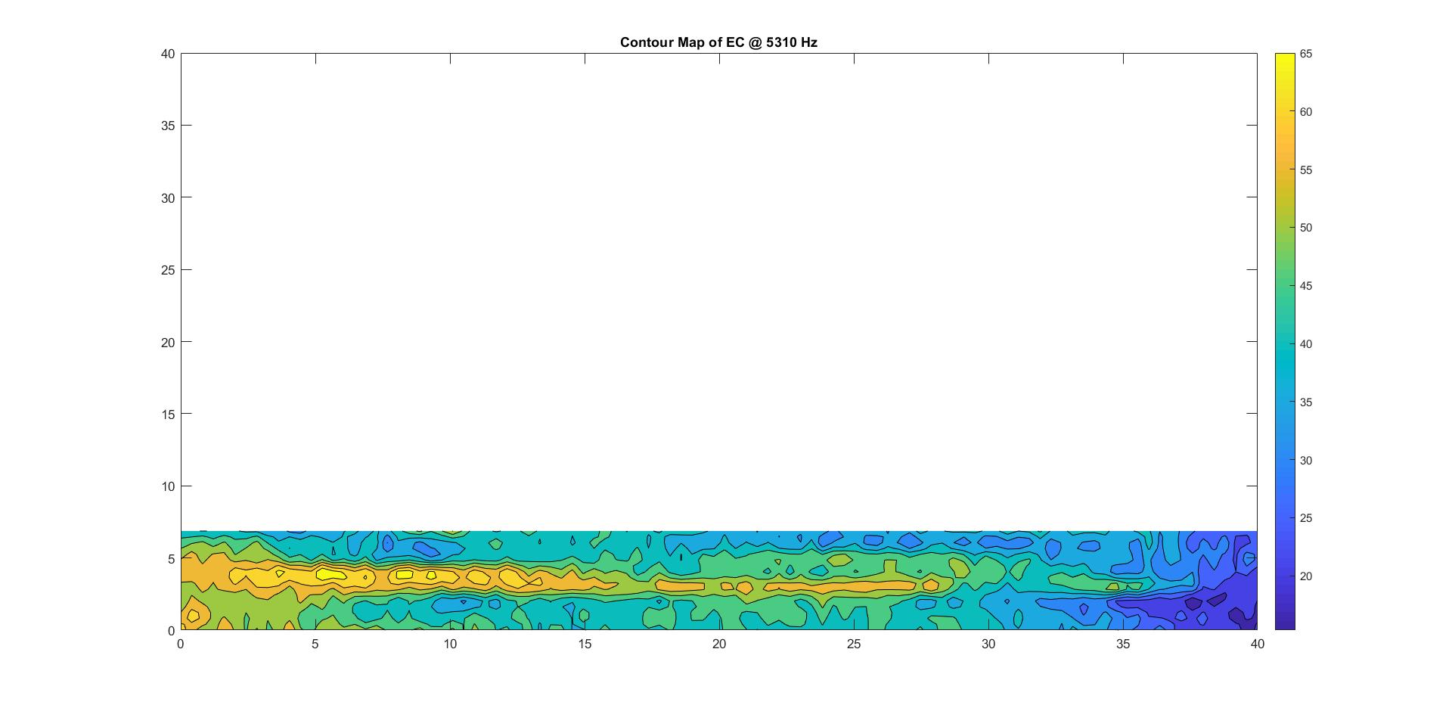
Gem data/First Test/5310Map.jpg
