95jasmith/EMI-sensor/Gem data/First Test/18330Map.jpg

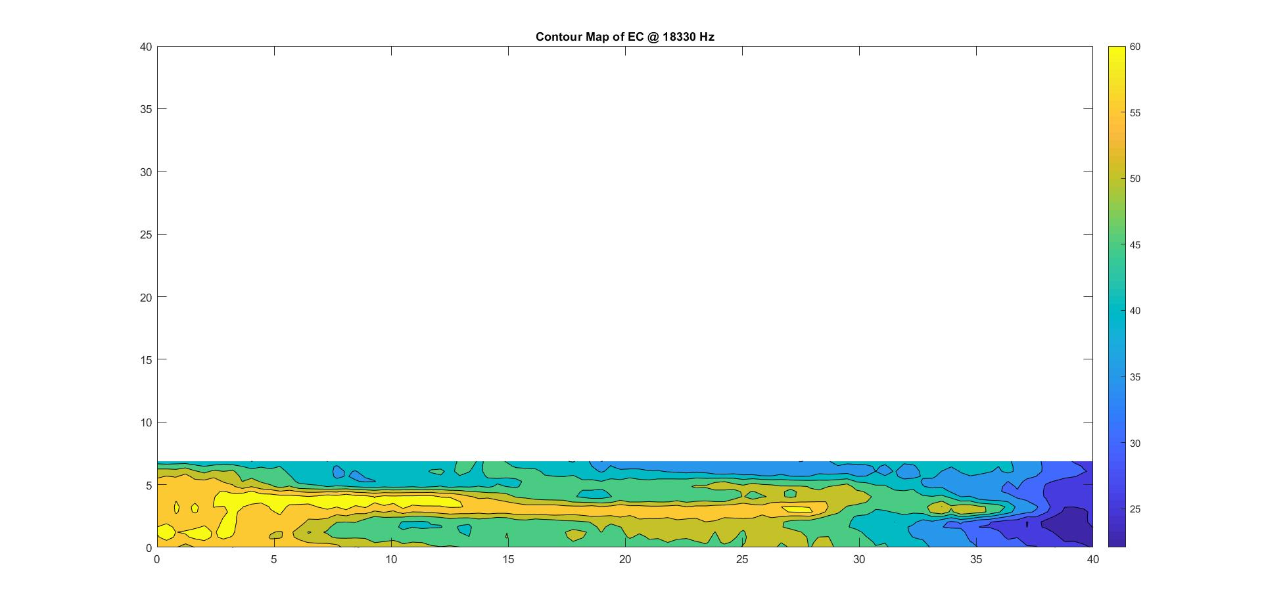
Gem data/First Test/18330Map.jpg
