95jasmith/EMI-sensor/Building sensor/Code/Gem_Interface/_COMP/Win32/Debug/gemdata.survey.GEM.csv

;recorded by GEM.dll
Line | Sample | Mark | Status | GPSStat | Time[ms] | PowerLn1 | I1_450Hz | Q1_450Hz | I1_1530Hz | Q1_1530Hz | I1_5310Hz | Q1_5310Hz | I1_18330Hz | Q1_18330Hz | I1_63030Hz | Q1_63030Hz | Q1_SumC
1 | 0 | 0 | 0 | 0 | 549280051 | 62.7 | 33602.742 | 22160.182 | 52862.820 | 23288.359 | 72493.328 | 19784.629 | 86395.484 | 13061.875 | 99644.656 | 6330.350 | 84625.398
1 | 1 | 0 | 0 | 0 | 549281051 | 62.1 | 33649.383 | 21894.602 | 53100.387 | 23166.316 | 71964.172 | 19773.732 | 86397.305 | 13032.497 | 99198.141 | 6583.478 | 84450.625
1 | 2 | 0 | 0 | 0 | 549282051 | 63.1 | 33717.453 | 22033.756 | 53011.070 | 23274.248 | 72277.969 | 19738.484 | 86199.875 | 12887.759 | 98698.875 | 6206.895 | 84141.141
1 | 3 | 0 | 0 | 0 | 549283051 | 62.5 | 33582.773 | 21938.541 | 52978.652 | 23391.463 | 72106.570 | 19830.064 | 86182.680 | 12880.938 | 98834.156 | 6327.500 | 84368.508
1 | 4 | 0 | 0 | 0 | 549284051 | 62.2 | 33256.539 | 21968.447 | 52818.926 | 23413.605 | 72286.266 | 19573.613 | 85856.188 | 13079.114 | 98525.703 | 7074.731 | 85109.516
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
