95jasmith/EMI-sensor/Building sensor/Code/Gem_Interface/_COMP/Win32/Debug/gemdata.survey.GPS.csv

;recorded by GEM.dll
GEMms | GPSms | GGA | hhmmss | ddmm.m | lathem | ddmm.m | lonsect | flg | sats | PDOP | alt | M | Un | GH | M | Age | id | cs
54928435 | 54928000 | $GPGGA | 151528.0 | 3545.74110 | N | 07839.37080 | W | 1 | 08 | 1.0 | 85.7 | M |  | -34.8 | M | 0.0 | 0 | *
54929442 | 54929000 | $GPGGA | 151529.0 | 3545.74120 | N | 07839.37100 | W | 1 | 08 | 1.0 | 85.7 | M |  | -34.8 | M | 0.0 | 0 | *
54930448 | 54930000 | $GPGGA | 151530.0 | 3545.74110 | N | 07839.37110 | W | 1 | 08 | 1.0 | 85.7 | M |  | -34.8 | M | 0.0 | 0 | *
54931418 | 54931000 | $GPGGA | 151531.0 | 3545.74100 | N | 07839.37110 | W | 1 | 08 | 1.0 | 85.7 | M |  | -34.8 | M | 0.0 | 0 | *
54932450 | 54932000 | $GPGGA | 151532.0 | 3545.74120 | N | 07839.37110 | W | 1 | 08 | 1.0 | 85.7 | M |  | -34.8 | M | 0.0 | 0 | *
54933449 | 54933000 | $GPGGA | 151533.0 | 3545.74130 | N | 07839.37110 | W | 1 | 08 | 1.0 | 85.7 | M |  | -34.8 | M | 0.0 | 0 | *
54938435 | 54938000 | $GPGGA | 151538.0 | 3545.74170 | N | 07839.37140 | W | 1 | 08 | 1.0 | 85.5 | M |  | -34.8 | M | 0.0 | 0 | *
54939449 | 54939000 | $GPGGA | 151539.0 | 3545.74180 | N | 07839.37140 | W | 1 | 08 | 1.0 | 85.4 | M |  | -34.8 | M | 0.0 | 0 | *
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
