95jasmith/EMI-sensor/Building sensor/Code/Bandpass_design-PSpiceFiles/SCHEMATIC1/Sim2/Sim2.cir

** Profile: "SCHEMATIC1-Sim2"  [ C:\Users\97jsm\Documents\GitHub\EMI-sensor\Building sensor\Code\Bandpass_design-PSpiceFiles\SCHEMATIC1\Sim2.sim ] 

** Creating circuit file "Sim2.cir" 
** WARNING: THIS AUTOMATICALLY GENERATED FILE MAY BE OVERWRITTEN BY SUBSEQUENT SIMULATIONS

*Libraries: 
* Profile Libraries :
* Local Libraries :
* From [PSPICE NETLIST] section of C:\SPB_Data\cdssetup\OrCAD_PSpice\17.2.0\PSpice.ini file:
.lib "nomd.lib" 

*Analysis directives: 
.AC DEC 10 1 1000K
.OPTIONS ADVCONV
.PROBE64 V(alias(*)) I(alias(*)) W(alias(*)) D(alias(*)) NOISE(alias(*)) 
.INC "..\SCHEMATIC1.net" 


.END
