95jasmith/EMI-sensor/Building sensor/Code/Bandpass_design-PSpiceFiles/SCHEMATIC1/Sim1/Sim1.cir

** Profile: "SCHEMATIC1-Sim1"  [ Q:\research\EMI Sensor\Building sensor\Code\Bandpass_design-PSpiceFiles\SCHEMATIC1\Sim1.sim ] 

** Creating circuit file "Sim1.cir" 
** WARNING: THIS AUTOMATICALLY GENERATED FILE MAY BE OVERWRITTEN BY SUBSEQUENT SIMULATIONS

*Libraries: 
* Profile Libraries :
* Local Libraries :
* From [PSPICE NETLIST] section of C:\Users\jsmith95\cdssetup\OrCAD_PSpice/16.6.0/PSpice.ini file:
.lib "nom.lib" 

*Analysis directives: 
.AC DEC 10 1 1000k
.OPTIONS ADVCONV
.PROBE64 V(alias(*)) I(alias(*)) W(alias(*)) D(alias(*)) NOISE(alias(*)) 
.INC "..\SCHEMATIC1.net" 


.END
