95jasmith/EMI-sensor/(list of files, drawings)

Other design files:
Building sensor/Code/BANDPASS_DESIGN.DSN
Building sensor/Code/Bandpass_design.opj
