95jasmith/EMI-sensor/Building sensor/Designs/EMI_sensor_control_Rev2.0/EMI_sensor_control_Rev2.0.kicad_pcb

## KiCad design Building sensor/Designs/EMI_sensor_control_Rev2.0/EMI_sensor_control_Rev2.0.kicad_pcb (2020-05-07)

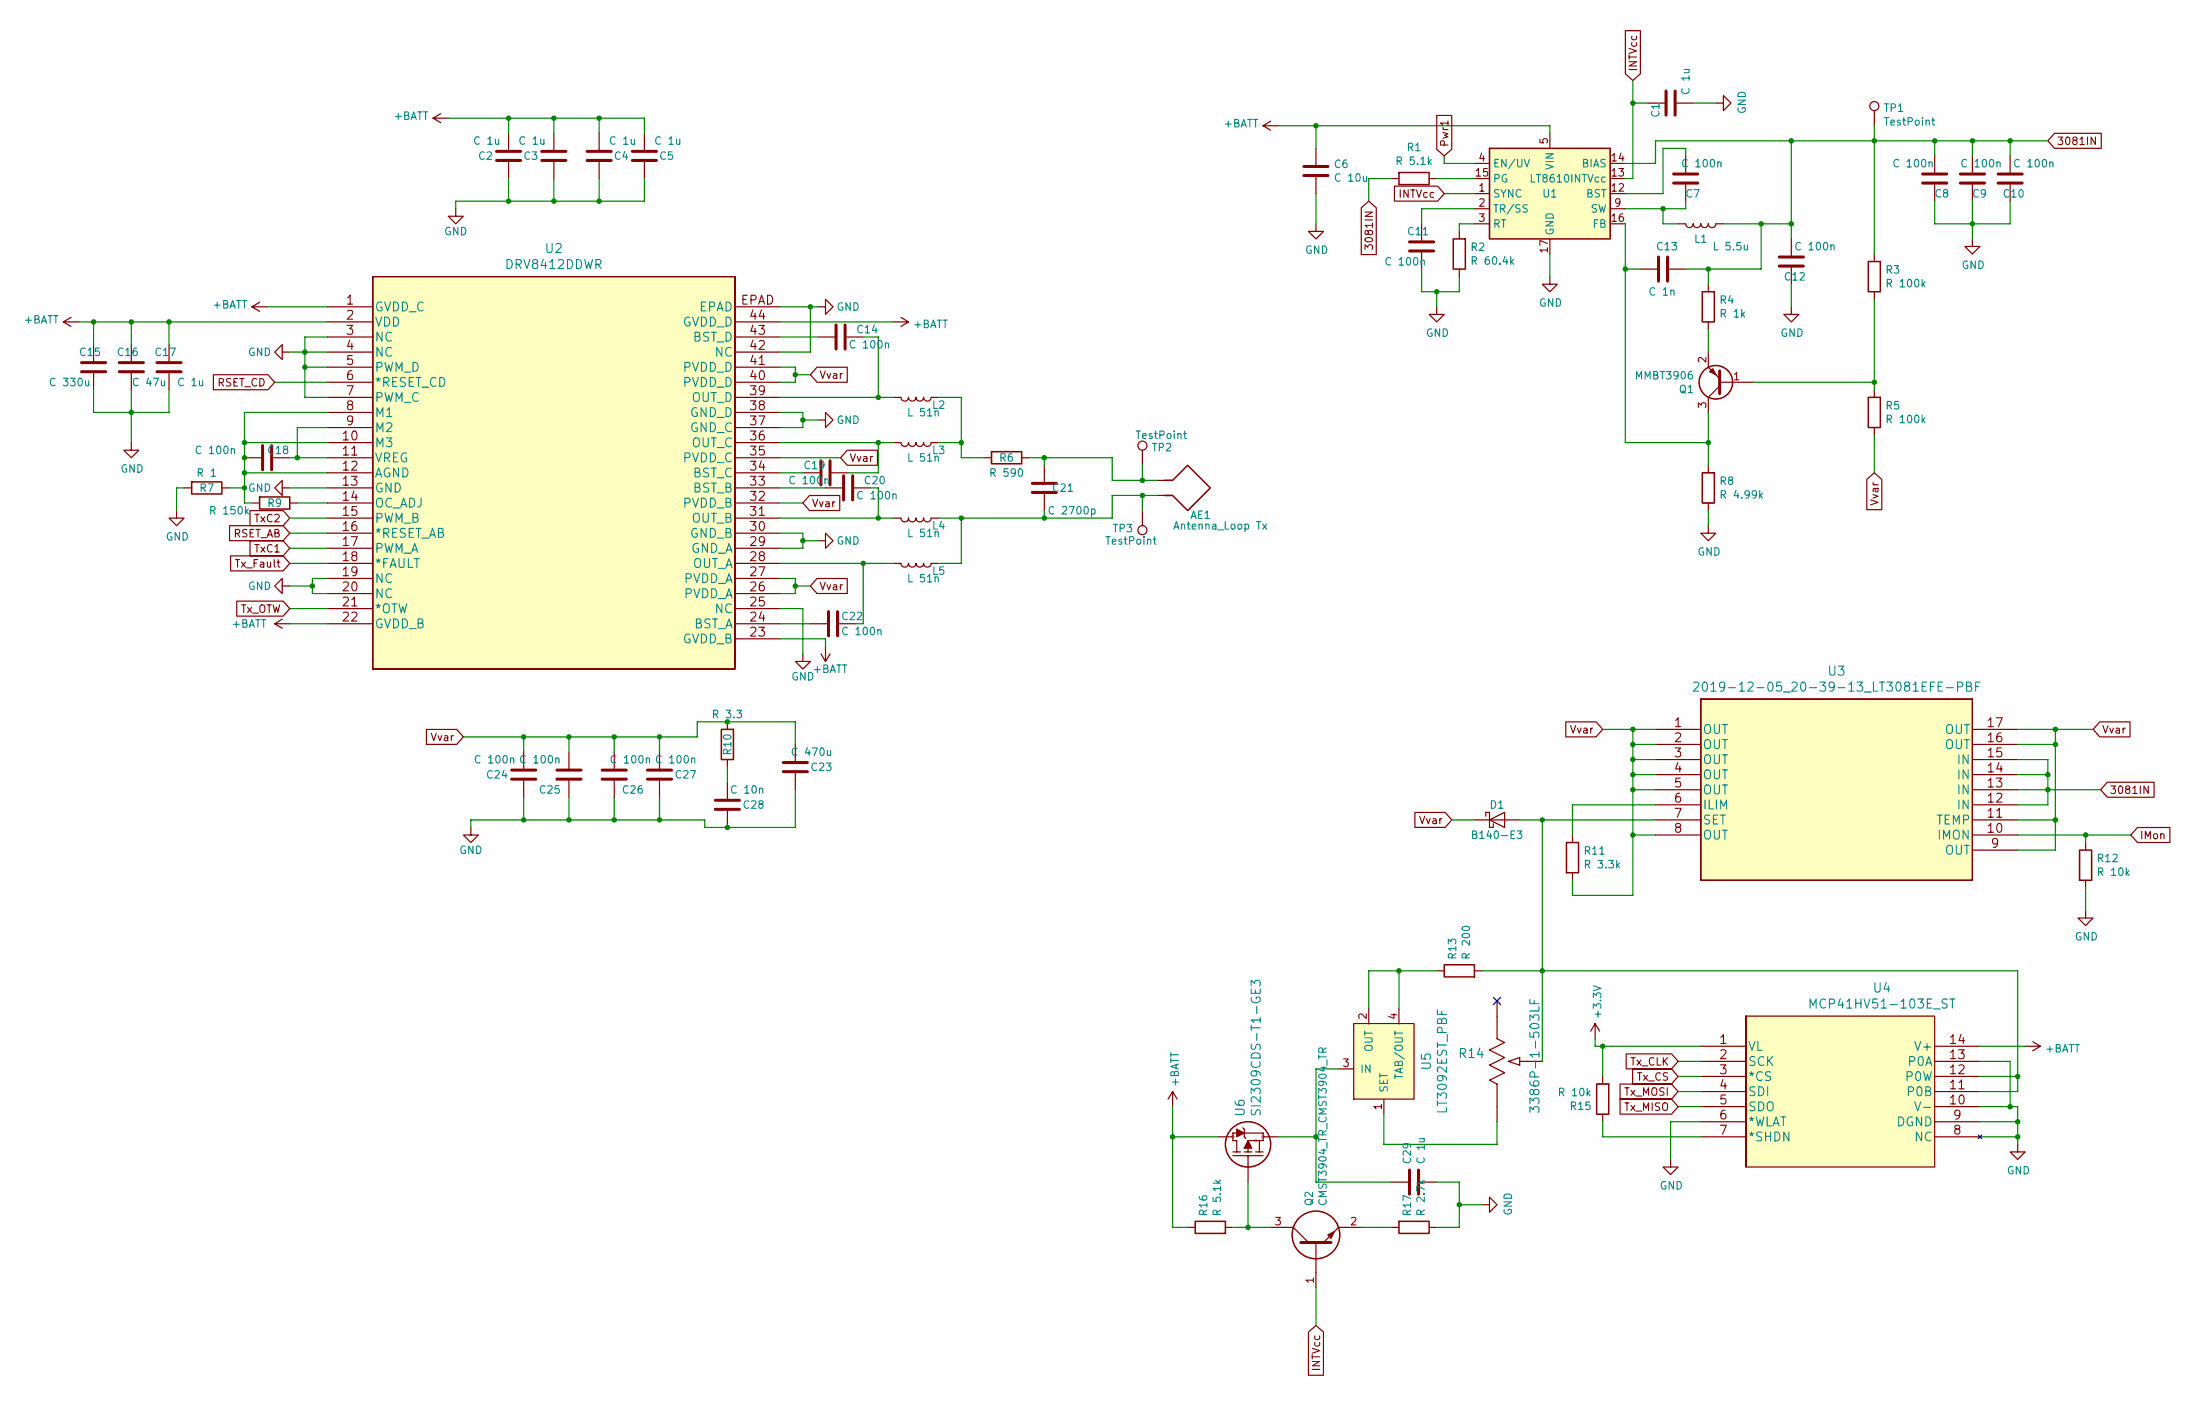
[picture p35: schematic file5D278C8E.sch, Pancreas EMI Conductivity Meter]

Parts:
AE1: Antenna_Loop Tx; SMA_Molex_73251-2200_Horizontal
C1, C2, C3, C4, C5, C17, C29: C 1u; C_0805_2012Metric_Pad1.15x1.40mm_HandSolder
C6: C 10u; C_1210_3225Metric_Pad1.42x2.65mm_HandSolder
C7, C8, C9, C10, C11, C12, C14, C18, C19, C20, C22, C24, C25, C26, C27: C 100n; C_0603_1608Metric_Pad1.05x0.95mm_HandSolder
C13: C 1n; C_0603_1608Metric_Pad1.05x0.95mm_HandSolder
C15: C 330u; CP_Elec_10x10
C16: C 47u; C_1206_3216Metric_Pad1.42x1.75mm_HandSolder
C21: C 2700p; C_0603_1608Metric_Pad1.05x0.95mm_HandSolder
C23: C 470u; CP_Elec_10x10
C28: C 10n; C_0805_2012Metric_Pad1.15x1.40mm_HandSolder
D1: B140-E3; D_SMA
L1: L 5.5u; L_Wuerth_HCI-1050
L2, L3, L4, L5: L 51n; L_0805_2012Metric_Pad1.15x1.40mm_HandSolder
Q1: MMBT3906; SOT-23
Q2: CMST3904_TR_CMST3904_TR; SOT-323_SC-70_Handsoldering; Manufacturer_Part_Number CMST3904 TR; Mouser Part Number 610-CMST3904
R1, R16: R 5.1k; R_0805_2012Metric_Pad1.15x1.40mm_HandSolder
R2: R 60.4k; R_0805_2012Metric_Pad1.15x1.40mm_HandSolder
R3, R5: R 100k; R_0805_2012Metric_Pad1.15x1.40mm_HandSolder
R4: R 1k; R_0805_2012Metric_Pad1.15x1.40mm_HandSolder
R6: R 590; R_1206_3216Metric_Pad1.42x1.75mm_HandSolder
R7: R 1; R_0805_2012Metric_Pad1.15x1.40mm_HandSolder
R8: R 4.99k; R_0805_2012Metric_Pad1.15x1.40mm_HandSolder
R9: R 150k; R_0805_2012Metric_Pad1.15x1.40mm_HandSolder
R10: R 3.3; R_0805_2012Metric_Pad1.15x1.40mm_HandSolder
R11: R 3.3k; R_0805_2012Metric_Pad1.15x1.40mm_HandSolder
R12, R15: R 10k; R_0805_2012Metric_Pad1.15x1.40mm_HandSolder
R13: R 200; R_0805_2012Metric_Pad1.15x1.40mm_HandSolder
R14: 3386P-1-503LF; Potentiometer_Bourns_3386P_Vertical
R17: R 2.7k; R_0805_2012Metric_Pad1.15x1.40mm_HandSolder
TP1, TP2, TP3: TestPoint; TestPoint_Pad_D3.0mm
U1: LT8610; MSOP-16-1EP_3x4mm_P0.5mm_EP1.65x2.85mm_ThermalVias
U2: DRV8412DDWR; SOIC-44
U3: 2019-12-05_20-39-13_LT3081EFE-PBF; TSSOP-16-1EP_4.4x5mm_P0.65mm
U4: MCP41HV51-103E_ST; TSSOP-14_4.4x5mm_P0.65mm
U5: LT3092EST_PBF; TO-261-4; MPN LT3092EST#PBF; Digi-Key_PN LT3092EST#PBF-ND
U6: SI2309CDS-T1-GE3; SOT-23

Connections:
3081IN: C8.2, C9.2, C10.2, C12.2, C13.1, L1.1, R1.2, R3.2, R4.2, TP1.1, U1.14 (BIAS), U3.12 (IN), U3.13 (IN), U3.14 (IN), U3.15 (IN)
+3V3: R15.2, U4.1 (VL); also elsewhere on the board
+BATT: C2.2, C3.2, C4.2, C5.2, C6.1, C15.1, C16.1, C17.1, R16.1, U1.5 (VIN), U1.6 (VIN), U2.1 (GVDD_C), U2.2 (VDD), U2.22 (GVDD_B), U2.23 (GVDD_B), U2.44 (GVDD_D), U4.14 (V+), U6.3 (D); also elsewhere on the board
GND: C1.2, C2.1, C3.1, C4.1, C5.1, C6.2, C8.1, C9.1, C10.1, C11.2, C12.1, C15.2, C16.2, C17.2, C23.1, C24.1, C25.1, C26.1, C27.1, C28.1, C29.2, R2.1, R7.2, R8.1, R12.2, R17.1, U1.7 (GND), U1.8 (GND), U1.17 (GND), U2.3 (NC), U2.4 (NC), U2.5 (PWM_D), U2.7 (PWM_C), U2.13 (GND), U2.19 (NC), U2.20 (NC), U2.25 (NC), U2.29 (GND_A), U2.30 (GND_B), U2.37 (GND_C), U2.38 (GND_D), U2.42 (NC), U2.EPAD, U4.6 (*WLAT), U4.8 (NC), U4.9 (DGND), U4.10 (V-), U4.13 (P0A); also elsewhere on the board
IMon: R12.1, U3.10 (IMON); also elsewhere on the board
INTVcc: C1.1, Q2.1, U1.1 (SYNC), U1.13 (INTVcc)
unnamed: AE1.1, C21.2, R6.1, TP2.1
unnamed: AE1.2, C21.1, L4.1, L5.1, TP3.1
unnamed: C7.1, L1.2, U1.9 (SW), U1.10 (SW), U1.11 (SW)
unnamed: C7.2, U1.12 (BST)
unnamed: C11.1, U1.2 (TR/SS)
unnamed: C13.2, Q1.3 (C), R8.2, U1.16 (FB)
unnamed: C14.1, L2.2, U2.39 (OUT_D)
unnamed: C14.2, U2.43 (BST_D)
unnamed: C18.1, R7.1, R9.2, U2.8 (M1), U2.10 (M3), U2.12 (AGND)
unnamed: C18.2, U2.9 (M2), U2.11 (VREG)
unnamed: C19.1, L3.2, U2.36 (OUT_C)
unnamed: C19.2, U2.34 (BST_C)
unnamed: C20.1, L4.2, U2.31 (OUT_B)
unnamed: C20.2, U2.33 (BST_B)
unnamed: C22.1, L5.2, U2.28 (OUT_A)
unnamed: C22.2, U2.24 (BST_A)
unnamed: C28.2, R10.1
unnamed: C29.1, U5.3 (IN), U6.2 (S)
unnamed: D1.2 (A), R13.2, R14.2, U3.7 (SET), U4.11 (P0B), U4.12 (P0W)
unnamed: L2.1, L3.1, R6.2
unnamed: Q1.1 (B), R3.1, R5.2
unnamed: Q1.2 (E), R4.1
unnamed: Q2.2, R17.2
unnamed: Q2.3, R16.2, U6.1 (G)
unnamed: R1.1, U1.15 (PG)
unnamed: R2.2, U1.3 (RT)
unnamed: R9.1, U2.14 (OC_ADJ)
unnamed: R11.1, U3.6 (ILIM)
unnamed: R13.1, U5.2 (OUT), U5.4 (TAB/OUT)
unnamed: R14.3, U5.1 (SET)
unnamed: R15.1, U4.7 (*SHDN)
Pwr1: U1.4 (EN/UV); also elsewhere on the board
RSET_AB: U2.16 (*RESET_AB); also elsewhere on the board
RSET_CD: U2.6 (*RESET_CD); also elsewhere on the board
TxC1: U2.17 (PWM_A); also elsewhere on the board
TxC2: U2.15 (PWM_B); also elsewhere on the board
Tx_CLK: U4.2 (SCK); also elsewhere on the board
Tx_CS: U4.3 (*CS); also elsewhere on the board
Tx_Fault: U2.18 (*FAULT); also elsewhere on the board
Tx_MISO: U4.5 (SDO); also elsewhere on the board
Tx_MOSI: U4.4 (SDI); also elsewhere on the board
Tx_OTW: U2.21 (*OTW); also elsewhere on the board
Vvar: C23.2, C24.2, C25.2, C26.2, C27.2, D1.1 (K), R5.1, R10.2, R11.2, U2.26 (PVDD_A), U2.27 (PVDD_A), U2.32 (PVDD_B), U2.35 (PVDD_C), U2.40 (PVDD_D), U2.41 (PVDD_D), U3.1 (OUT), U3.2 (OUT), U3.3 (OUT), U3.4 (OUT), U3.5 (OUT), U3.8 (OUT), U3.9 (OUT), U3.11 (TEMP), U3.16 (OUT), U3.17 (OUT)

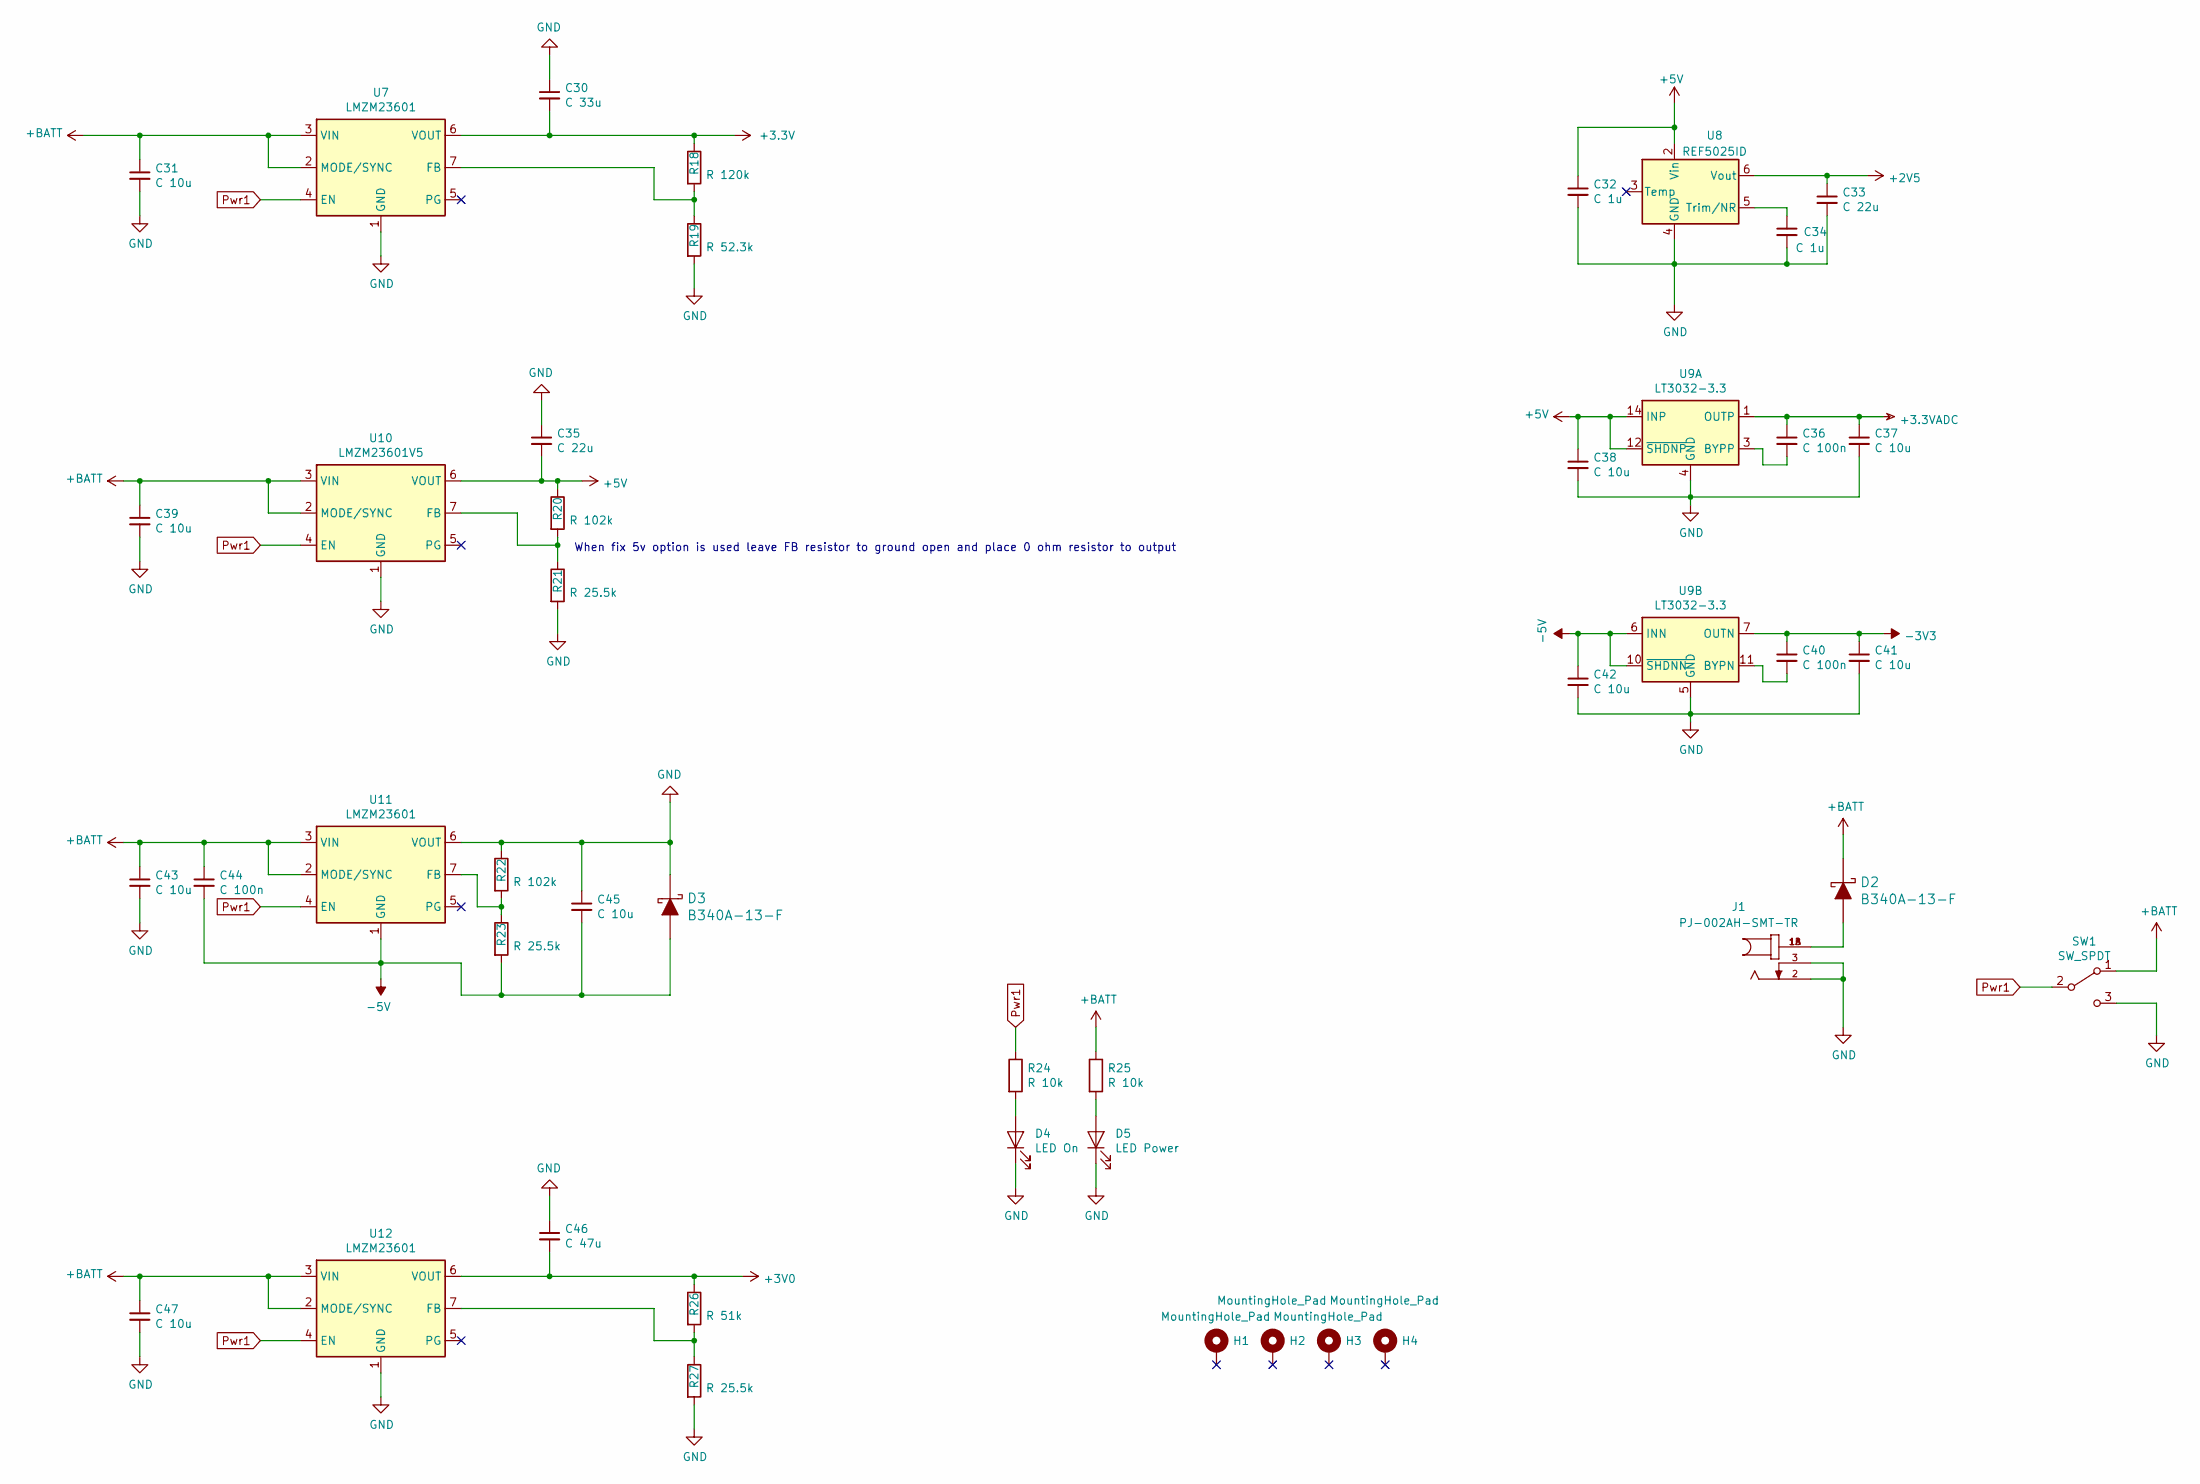
[picture p36: schematic file5D27CADE.sch, Pancreas EMI Conductivity Meter]

Parts:
C30: C 33u; C_1206_3216Metric_Pad1.42x1.75mm_HandSolder
C31, C37, C38, C39, C41, C42, C43, C45, C47: C 10u; C_1210_3225Metric_Pad1.42x2.65mm_HandSolder
C32: C 1u; C_1206_3216Metric_Pad1.42x1.75mm_HandSolder
C33, C35: C 22u; C_1206_3216Metric_Pad1.42x1.75mm_HandSolder
C34: C 1u; C_0805_2012Metric_Pad1.15x1.40mm_HandSolder
C36, C40, C44: C 100n; C_0603_1608Metric_Pad1.05x0.95mm_HandSolder
C46: C 47u; C_1206_3216Metric_Pad1.42x1.75mm_HandSolder
D2, D3: B340A-13-F; DO-214AC; MPN B340A-13-F; Digi-Key_PN B340A-FDICT-ND
D4: LED On; LED_1206_3216Metric_Pad1.42x1.75mm_HandSolder
D5: LED Power; LED_1206_3216Metric_Pad1.42x1.75mm_HandSolder
H1, H2, H3, H4: MountingHole_Pad; MountingHole_2.7mm_M2.5_Pad_Via
J1: PJ-002AH-SMT-TR; CUI_PJ-002AH-SMT-TR
R18: R 120k; R_0805_2012Metric_Pad1.15x1.40mm_HandSolder
R19: R 52.3k; R_0805_2012Metric_Pad1.15x1.40mm_HandSolder
R20, R22: R 102k; R_0805_2012Metric_Pad1.15x1.40mm_HandSolder
R21, R23, R27: R 25.5k; R_0805_2012Metric_Pad1.15x1.40mm_HandSolder
R24, R25: R 10k; R_0805_2012Metric_Pad1.15x1.40mm_HandSolder
R26: R 51k; R_0805_2012Metric_Pad1.15x1.40mm_HandSolder
SW1: SW_SPDT; EG1215AA
U7, U11, U12: LMZM23601; Texas_SIL0010A_MicroSiP-10-1EP_3.8x3mm_P0.6mm_EP0.7x2.9mm_T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
U8: REF5025ID; SOIC-8_3.9x4.9mm_P1.27mm
U9: LT3032-3.3; Linear_DE14MA
U10: LMZM23601V5; Texas_SIL0010A_MicroSiP-10-1EP_3.8x3mm_P0.6mm_EP0.7x2.9mm_T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

Connections:
+2V5: C33.1, U8.6 (Vout); also elsewhere on the board
+3.3VADC: C36.1, C37.1, U9.1 (OUTP); also elsewhere on the board
+3V0: C46.2, R26.1, U12.6 (VOUT); also elsewhere on the board
+3V3: C30.2, R18.1, U7.6 (VOUT); also elsewhere on the board
+5V: C32.1, C35.2, C38.1, R20.1, U8.2 (Vin), U9.12 (~SHDNP), U9.14 (INP), U10.6 (VOUT); also elsewhere on the board
+BATT: C31.1, C39.1, C43.1, C44.1, C47.1, D2.K, R25.1, SW1.1 (A), U7.2 (MODE/SYNC), U7.3 (VIN), U10.2 (MODE/SYNC), U10.3 (VIN), U11.2 (MODE/SYNC), U11.3 (VIN), U12.2 (MODE/SYNC), U12.3 (VIN); also elsewhere on the board
-3V3: C40.1, C41.1, U9.7 (OUTN); also elsewhere on the board
-5V: C42.1, C44.2, C45.2, D3.A, R23.2, U9.6 (INN), U9.9 (INN), U9.10 (~SHDNN), U11.1 (GND), U11.11 (GND); also elsewhere on the board
GND: C30.1, C31.2, C32.2, C33.2, C34.2, C35.1, C37.2, C38.2, C39.2, C41.2, C42.2, C43.2, C45.1, C46.1, C47.2, D3.K, D4.1 (K), D5.1 (K), J1.2, J1.3, R19.2, R21.2, R22.1, R27.2, SW1.3 (C), U7.1 (GND), U7.11 (GND), U8.4 (GND), U9.4 (GND), U9.5 (GND), U10.1 (GND), U10.11 (GND), U11.6 (VOUT), U12.1 (GND), U12.11 (GND); also elsewhere on the board
unnamed: C34.1, U8.5 (Trim/NR)
unnamed: C36.2, U9.3 (BYPP)
unnamed: C40.2, U9.11 (BYPN)
unnamed: D2.A, J1.1A (1), J1.1B (1)
unnamed 108: D4.2 (A), R24.2; also elsewhere on the board
unnamed 109: D5.2 (A), R25.2; also elsewhere on the board
unnamed: R18.2, R19.1, U7.7 (FB)
unnamed: R20.2, R21.1, U10.7 (FB)
unnamed: R22.2, R23.1, U11.7 (FB)
unnamed: R26.2, R27.1, U12.7 (FB)
Pwr1: R24.1, SW1.2 (B), U7.4 (EN), U10.4 (EN), U11.4 (EN), U12.4 (EN); also elsewhere on the board

Notes on the sheet:
When fix 5v option is used leave FB resistor to ground open and place 0 ohm resistor to output

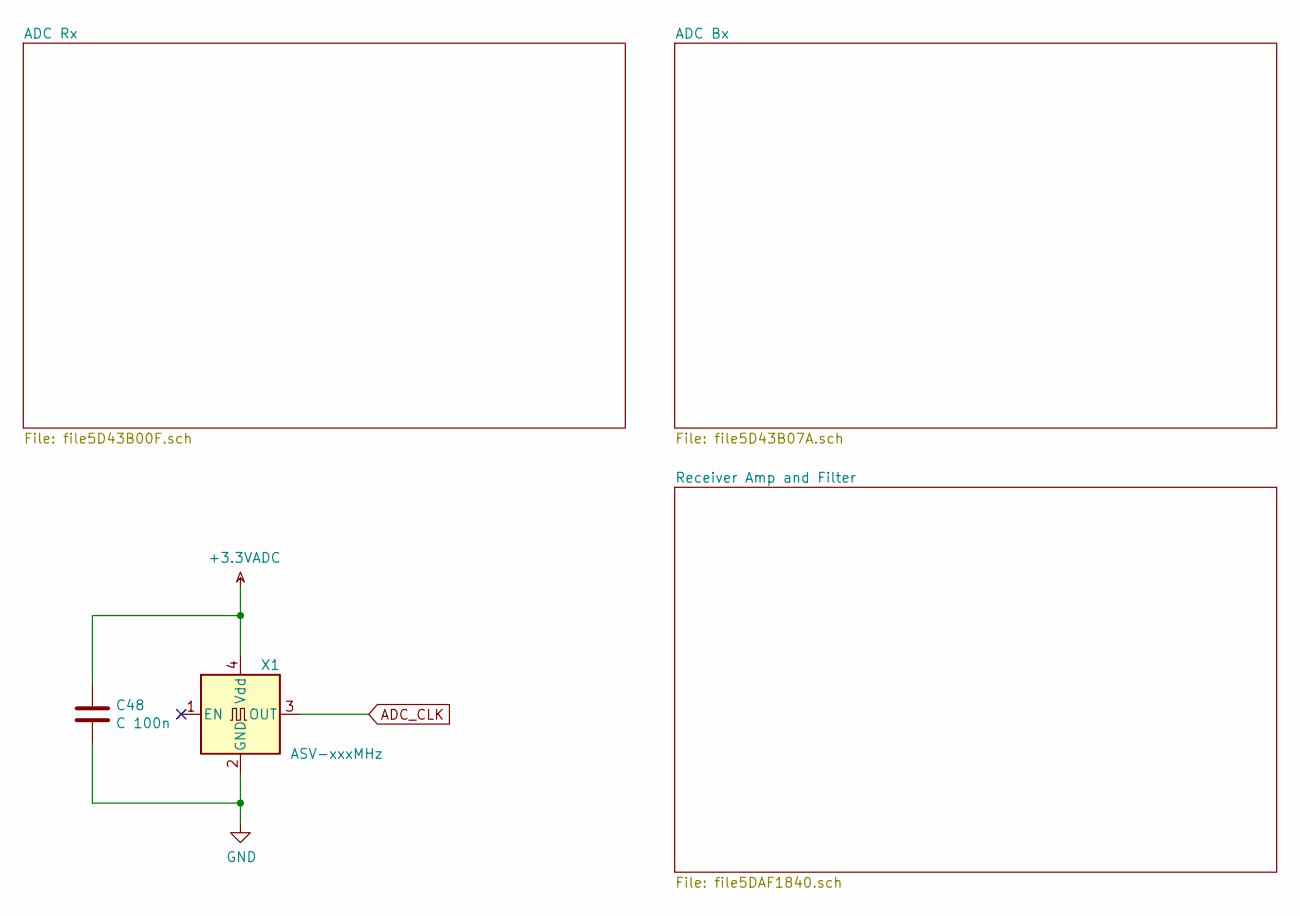
[picture p37: schematic file5D3E2E6E.sch, Pancreas EMI Conductivity Meter]

Parts:
C48: C 100n; C_0603_1608Metric_Pad1.05x0.95mm_HandSolder
X1: ASV-xxxMHz; Oscillator_SMD_Abracon_ASV-4Pin_7.0x5.1mm

Connections:
+3.3VADC: C48.1, X1.4 (Vdd); also elsewhere on the board
ADC_CLK: X1.3 (OUT); also elsewhere on the board
GND: C48.2, X1.2 (GND); also elsewhere on the board

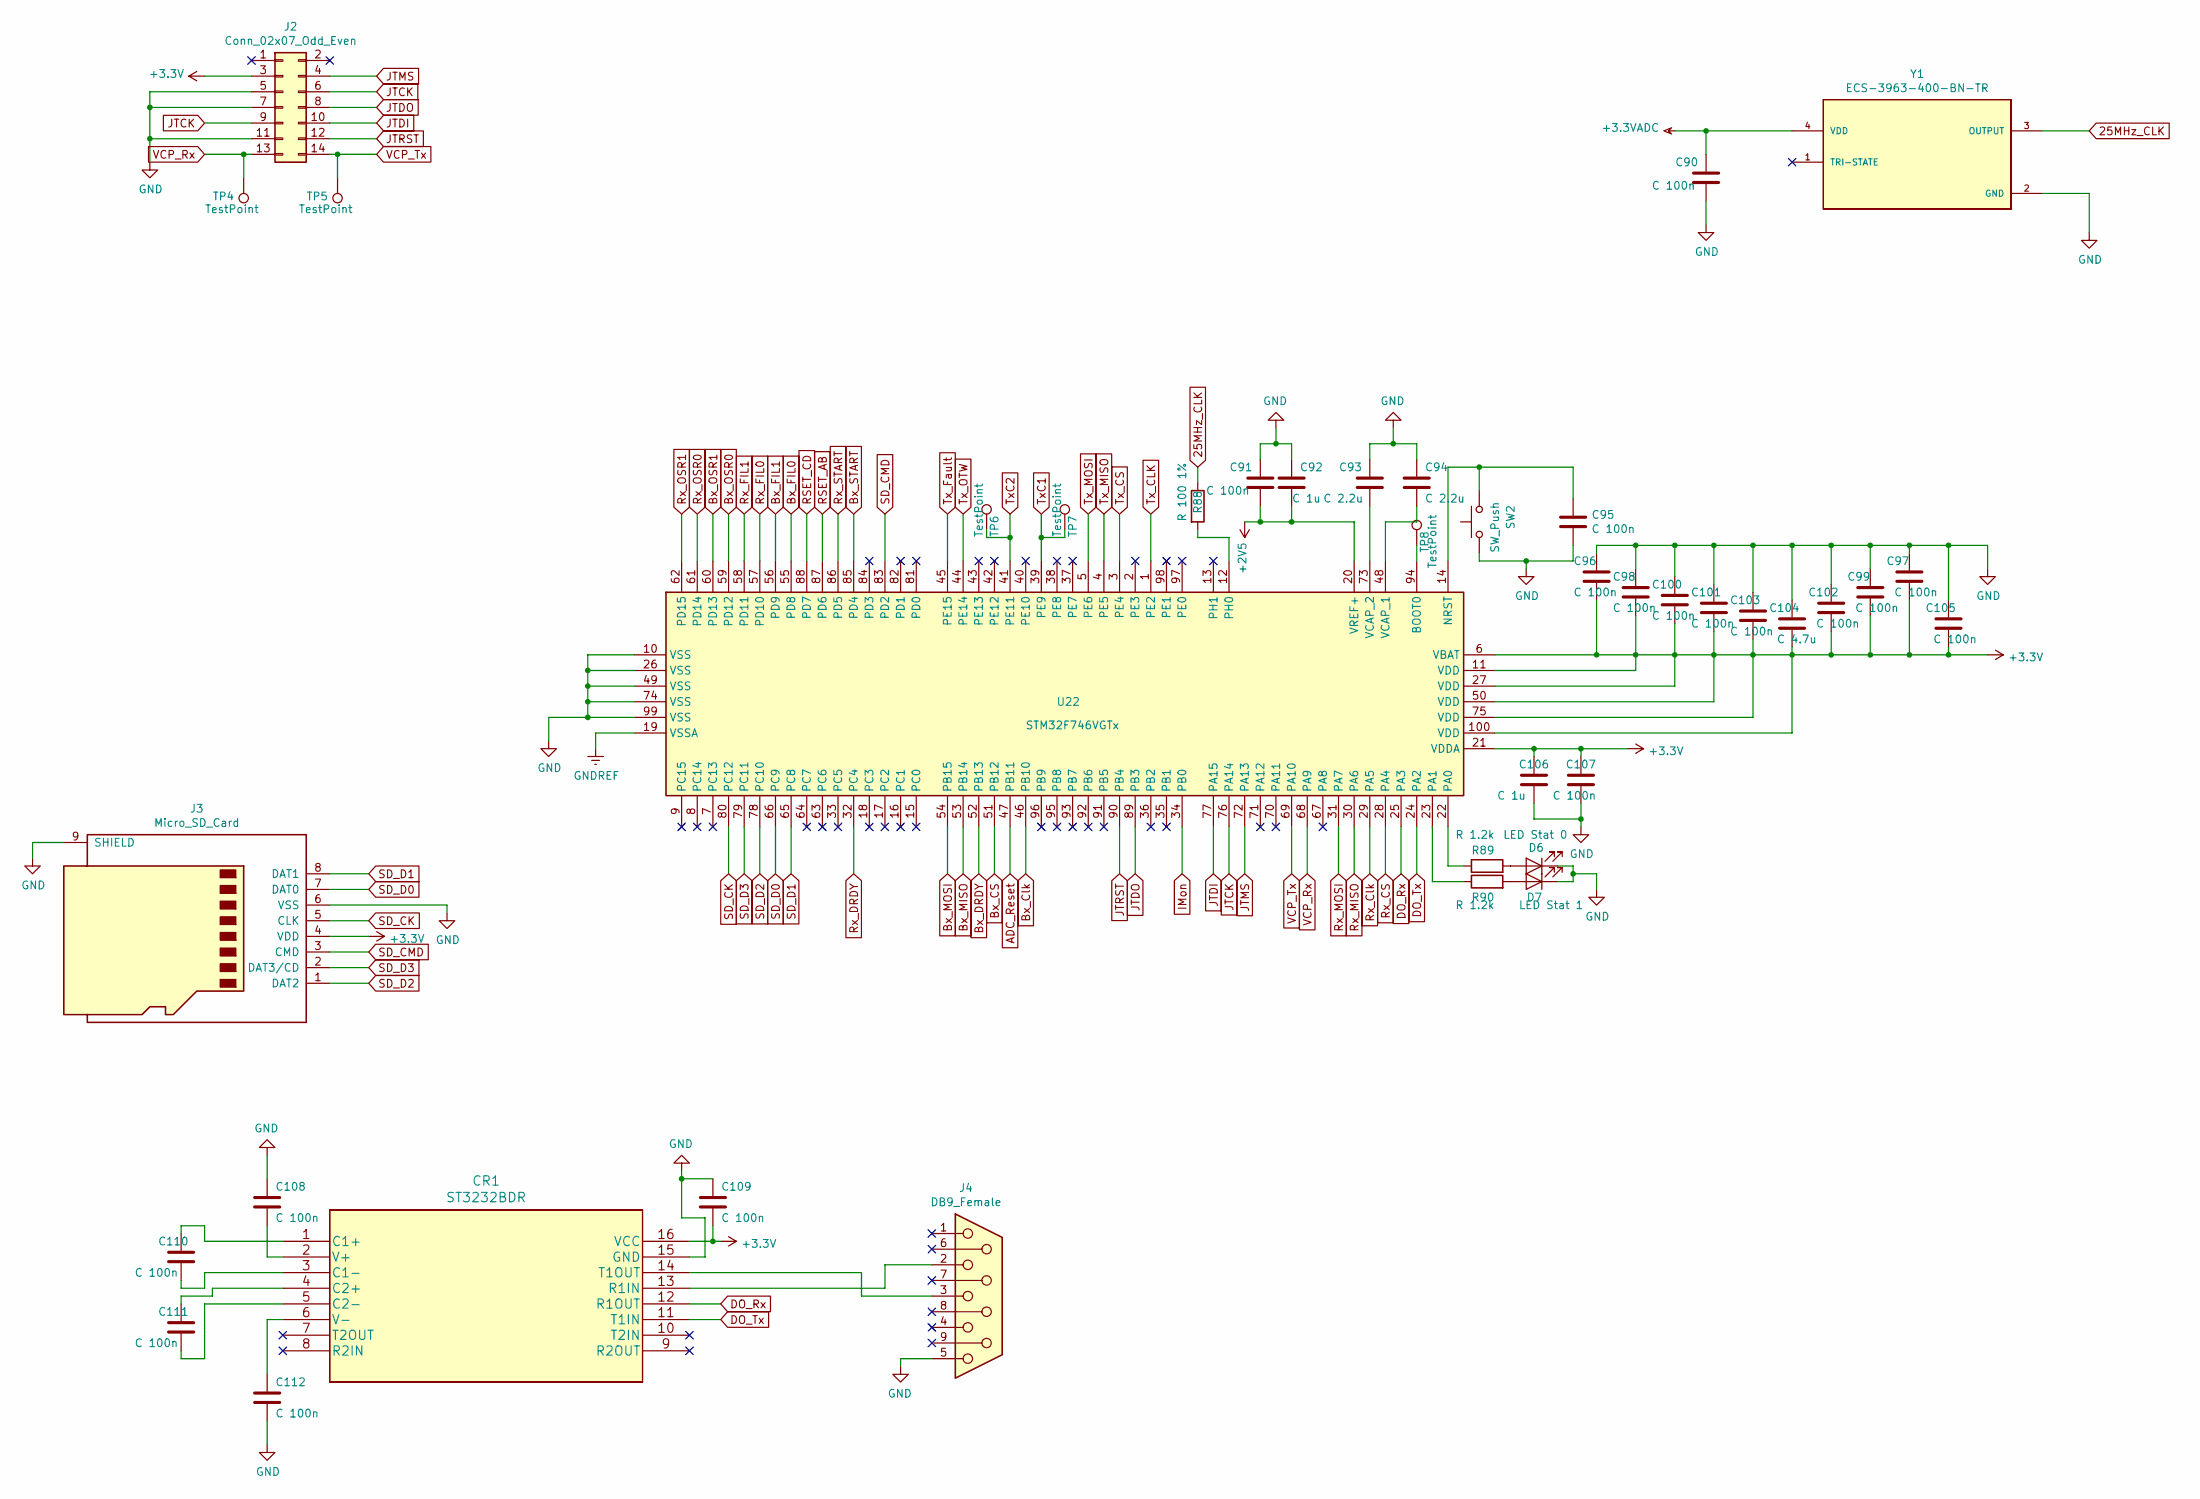
[picture p38: schematic file5D2792E2.sch, Pancreas EMI Conductivity Meter]

Parts:
C90, C91, C95, C96, C97, C98, C99, C100, C101, C102, C103, C105, C107, C108, C109, C110, C111, C112: C 100n; C_0603_1608Metric_Pad1.05x0.95mm_HandSolder
C92, C106: C 1u; C_0805_2012Metric_Pad1.15x1.40mm_HandSolder
C93, C94: C 2.2u; C_0603_1608Metric_Pad1.05x0.95mm_HandSolder
C104: C 4.7u; C_0805_2012Metric_Pad1.15x1.40mm_HandSolder
CR1: ST3232BDR; SOIC127P600X175-16N
D6: LED Stat 0; LED_1206_3216Metric_Pad1.42x1.75mm_HandSolder
D7: LED Stat 1; LED_1206_3216Metric_Pad1.42x1.75mm_HandSolder
J2: Conn_02x07_Odd_Even; PinHeader_2x07_P1.27mm_Vertical_SMD
J3: Micro_SD_Card; 47571-0001
J4: DB9_Female; DSUB-9_Receptical_A-DF_09_A_KG-T2S
R88: R 100 1%; R_1206_3216Metric_Pad1.42x1.75mm_HandSolder
R89, R90: R 1.2k; R_0805_2012Metric_Pad1.15x1.40mm_HandSolder
SW2: SW_Push; SW_1437566-4
TP4, TP5, TP6, TP7, TP8: TestPoint; TestPoint_Pad_D3.0mm
U22: STM32F746VGTx; LQFP-100_14x14mm_P0.5mm
Y1: ECS-3963-400-BN-TR; OSC_ECS-3963-400-BN-TR

Connections:
25MHz_CLK: R88.1, Y1.3 (OUTPUT)
+2V5: C91.2, C92.2, U22.20 (VREF+); also elsewhere on the board
+3.3VADC: C90.1, Y1.4 (VDD); also elsewhere on the board
+3V3: C96.1, C97.1, C98.1, C99.1, C100.1, C101.1, C102.1, C103.1, C104.1, C105.1, C106.2, C107.2, C109.1, CR1.16 (VCC), J2.3, J3.4 (VDD), U22.6 (VBAT), U22.11 (VDD), U22.21 (VDDA), U22.27 (VDD), U22.50 (VDD), U22.75 (VDD), U22.100 (VDD); also elsewhere on the board
ADC_Reset: U22.47 (PB11); also elsewhere on the board
Bx_CS: U22.51 (PB12); also elsewhere on the board
Bx_Clk: U22.46 (PB10); also elsewhere on the board
Bx_DRDY: U22.52 (PB13); also elsewhere on the board
Bx_FIL0: U22.55 (PD8); also elsewhere on the board
Bx_FIL1: U22.56 (PD9); also elsewhere on the board
Bx_MISO: U22.53 (PB14); also elsewhere on the board
Bx_MOSI: U22.54 (PB15); also elsewhere on the board
Bx_OSR0: U22.59 (PD12); also elsewhere on the board
Bx_OSR1: U22.60 (PD13); also elsewhere on the board
Bx_START: U22.85 (PD4); also elsewhere on the board
DO_Rx: CR1.12 (R1OUT), U22.25 (PA3)
DO_Tx: CR1.11 (T1IN), U22.24 (PA2)
GND: C90.2, C91.1, C92.1, C93.1, C94.1, C95.2, C96.2, C97.2, C98.2, C99.2, C100.2, C101.2, C102.2, C103.2, C104.2, C105.2, C106.1, C107.1, C108.2, C109.2, C112.1, CR1.15 (GND), D6.1 (K), D7.1 (K), J2.5, J2.7, J2.11, J3.6 (VSS), J3.9 (SHIELD), J4.5, SW2.1, U22.10 (VSS), U22.26 (VSS), U22.49 (VSS), U22.74 (VSS), U22.99 (VSS), Y1.2 (GND); also elsewhere on the board
GNDREF: U22.19 (VSSA)
IMon: U22.34 (PB0); also elsewhere on the board
JTCK: J2.6, J2.9, U22.76 (PA14)
JTDI: J2.10, U22.77 (PA15)
JTDO: J2.8, U22.89 (PB3)
JTMS: J2.4, U22.72 (PA13)
JTRST: J2.12, U22.90 (PB4)
unnamed: C93.2, U22.73 (VCAP_2)
unnamed: C94.2, U22.48 (VCAP_1)
unnamed: C95.1, SW2.2, U22.14 (NRST)
unnamed: C108.1, CR1.2 (V+)
unnamed: C110.1, CR1.3 (C1-)
unnamed: C110.2, CR1.1 (C1+)
unnamed: C111.1, CR1.5 (C2-)
unnamed: C111.2, CR1.4 (C2+)
unnamed: C112.2, CR1.6 (V-)
unnamed: CR1.13 (R1IN), J4.2
unnamed: CR1.14 (T1OUT), J4.3
unnamed 110: D6.2 (A), R89.2; also elsewhere on the board
unnamed 111: D7.2 (A), R90.2; also elsewhere on the board
unnamed: R88.2, U22.12 (PH0)
unnamed: R89.1, U22.22 (PA0)
unnamed: R90.1, U22.23 (PA1)
unnamed 180: TP8.1, U22.94 (BOOT0); also elsewhere on the board
RSET_AB: U22.87 (PD6); also elsewhere on the board
RSET_CD: U22.88 (PD7); also elsewhere on the board
Rx_CS: U22.28 (PA4); also elsewhere on the board
Rx_Clk: U22.29 (PA5); also elsewhere on the board
Rx_DRDY: U22.32 (PC4); also elsewhere on the board
Rx_FIL0: U22.57 (PD10); also elsewhere on the board
Rx_FIL1: U22.58 (PD11); also elsewhere on the board
Rx_MISO: U22.30 (PA6); also elsewhere on the board
Rx_MOSI: U22.31 (PA7); also elsewhere on the board
Rx_OSR0: U22.61 (PD14); also elsewhere on the board
Rx_OSR1: U22.62 (PD15); also elsewhere on the board
Rx_START: U22.86 (PD5); also elsewhere on the board
SD_CK: J3.5 (CLK), U22.80 (PC12)
SD_CMD: J3.3 (CMD), U22.83 (PD2)
SD_D0: J3.7 (DAT0), U22.66 (PC9)
SD_D1: J3.8 (DAT1), U22.65 (PC8)
SD_D2: J3.1 (DAT2), U22.78 (PC10)
SD_D3: J3.2 (DAT3/CD), U22.79 (PC11)
TxC1: TP7.1, U22.39 (PE9); also elsewhere on the board
TxC2: TP6.1, U22.41 (PE11); also elsewhere on the board
Tx_CLK: U22.1 (PE2); also elsewhere on the board
Tx_CS: U22.3 (PE4); also elsewhere on the board
Tx_Fault: U22.45 (PE15); also elsewhere on the board
Tx_MISO: U22.4 (PE5); also elsewhere on the board
Tx_MOSI: U22.5 (PE6); also elsewhere on the board
Tx_OTW: U22.44 (PE14); also elsewhere on the board
VCP_Rx: J2.13, TP4.1, U22.68 (PA9); also elsewhere on the board
VCP_Tx: J2.14, TP5.1, U22.69 (PA10); also elsewhere on the board
