95jasmith/EMI-sensor/Building sensor/Designs/EMI_sensor_control_Rev2.0/EMI_sensor_control_Rev2.0.kicad_pcb

## KiCad design Building sensor/Designs/EMI_sensor_control_Rev2.0/EMI_sensor_control_Rev2.0.kicad_pcb (continued)

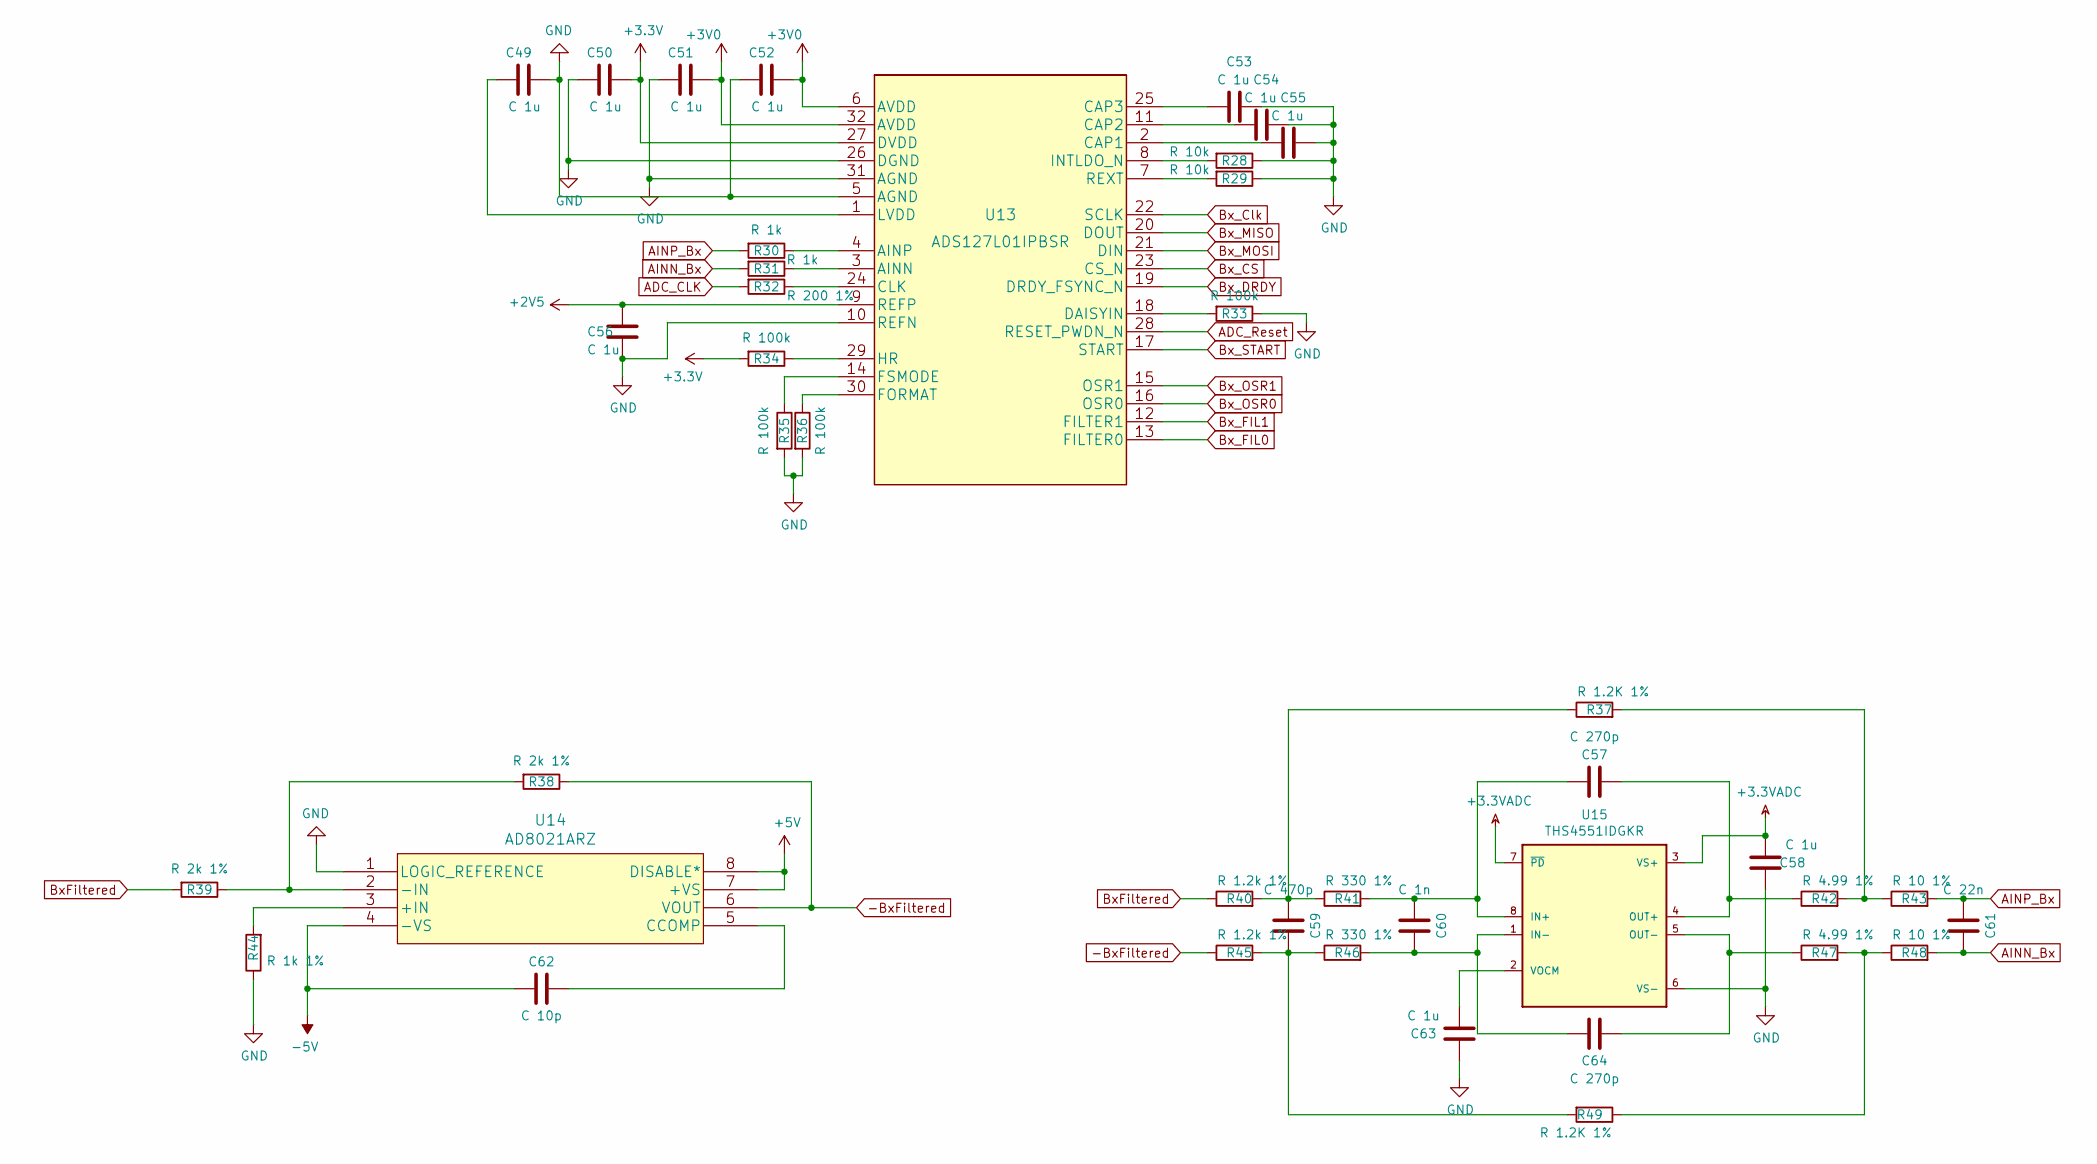
[picture p39: schematic file5D43B07A.sch, Pancreas EMI Conductivity Meter]

Parts:
C49, C50, C51, C52, C53, C54, C55, C56, C58, C63: C 1u; C_0805_2012Metric_Pad1.15x1.40mm_HandSolder
C57: C 270p; C_0603_1608Metric_Pad1.05x0.95mm_HandSolder
C59: C 470p; C_0603_1608Metric_Pad1.05x0.95mm_HandSolder
C60: C 1n; C_0603_1608Metric_Pad1.05x0.95mm_HandSolder
C61: C 22n; C_0805_2012Metric_Pad1.15x1.40mm_HandSolder
C62: C 10p; C_0603_1608Metric_Pad1.05x0.95mm_HandSolder
C64: C 270p; C_0805_2012Metric_Pad1.15x1.40mm_HandSolder
R28, R29: R 10k; R_0805_2012Metric_Pad1.15x1.40mm_HandSolder
R30, R31: R 1k; R_0805_2012Metric_Pad1.15x1.40mm_HandSolder
R32: R 200 1%; R_0805_2012Metric_Pad1.15x1.40mm_HandSolder
R33, R34, R35, R36: R 100k; R_0805_2012Metric_Pad1.15x1.40mm_HandSolder
R37, R49: R 1.2K 1%; R_0805_2012Metric_Pad1.15x1.40mm_HandSolder
R38, R39: R 2k 1%; R_0805_2012Metric_Pad1.15x1.40mm_HandSolder
R40, R45: R 1.2k 1%; R_0805_2012Metric_Pad1.15x1.40mm_HandSolder
R41, R46: R 330 1%; R_0805_2012Metric_Pad1.15x1.40mm_HandSolder
R42, R47: R 4.99 1%; R_0805_2012Metric_Pad1.15x1.40mm_HandSolder
R43, R48: R 10 1%; R_0805_2012Metric_Pad1.15x1.40mm_HandSolder
R44: R 1k 1%; R_0805_2012Metric_Pad1.15x1.40mm_HandSolder
U13: ADS127L01IPBSR; QFP50P700X700X120-32N
U14: AD8021ARZ; SOIC-8_3.9x4.9mm_P1.27mm
U15: THS4551IDGKR; VSSOP-8_3.0x3.0mm_P0.65mm

Connections:
+2V5: C56.1, U13.9 (REFP); also elsewhere on the board
+3.3VADC: C58.2, U15.3 (VS+), U15.7 (~PD~); also elsewhere on the board
+3V0: C51.2, C52.2, U13.6 (AVDD), U13.32 (AVDD); also elsewhere on the board
+3V3: C50.2, R34.2, U13.27 (DVDD); also elsewhere on the board
+5V: U14.7 (+VS), U14.8 (DISABLE*); also elsewhere on the board
-5V: C62.2, U14.4 (-VS); also elsewhere on the board
-BxFiltered: R38.1, R45.1, U14.6 (VOUT)
ADC_CLK: R32.2; also elsewhere on the board
ADC_Reset: U13.28 (RESET_PWDN_N); also elsewhere on the board
AINN_Bx: C61.1, R31.2, R48.2
AINP_Bx: C61.2, R30.2, R43.2
BxFiltered: R39.2, R40.1; also elsewhere on the board
Bx_CS: U13.23 (CS_N); also elsewhere on the board
Bx_Clk: U13.22 (SCLK); also elsewhere on the board
Bx_DRDY: U13.19 (DRDY_FSYNC_N); also elsewhere on the board
Bx_FIL0: U13.13 (FILTER0); also elsewhere on the board
Bx_FIL1: U13.12 (FILTER1); also elsewhere on the board
Bx_MISO: U13.20 (DOUT); also elsewhere on the board
Bx_MOSI: U13.21 (DIN); also elsewhere on the board
Bx_OSR0: U13.16 (OSR0); also elsewhere on the board
Bx_OSR1: U13.15 (OSR1); also elsewhere on the board
Bx_START: U13.17 (START); also elsewhere on the board
GND: C49.2, C50.1, C51.1, C52.1, C53.1, C54.1, C55.1, C56.2, C58.1, C63.1, R28.1, R29.1, R33.1, R35.2, R36.2, R44.1, U13.5 (AGND), U13.10 (REFN), U13.26 (DGND), U13.31 (AGND), U14.1 (LOGIC_REFERENCE), U15.6 (VS-); also elsewhere on the board
unnamed: C49.1, U13.1 (LVDD)
unnamed: C53.2, U13.25 (CAP3)
unnamed: C54.2, U13.11 (CAP2)
unnamed: C55.2, U13.2 (CAP1)
unnamed: C57.1, R42.1, U15.4 (OUT+)
unnamed: C57.2, C60.2, R41.2, U15.8 (IN+)
unnamed: C59.1, R45.2, R46.1, R49.2
unnamed: C59.2, R37.1, R40.2, R41.1
unnamed: C60.1, C64.1, R46.2, U15.1 (IN-)
unnamed: C62.1, U14.5 (CCOMP)
unnamed: C63.2, U15.2 (VOCM)
unnamed: C64.2, R47.1, U15.5 (OUT-)
unnamed: R28.2, U13.8 (INTLDO_N)
unnamed: R29.2, U13.7 (REXT)
unnamed: R30.1, U13.4 (AINP)
unnamed: R31.1, U13.3 (AINN)
unnamed: R32.1, U13.24 (CLK)
unnamed: R33.2, U13.18 (DAISYIN)
unnamed: R34.1, U13.29 (HR)
unnamed: R35.1, U13.14 (FSMODE)
unnamed: R36.1, U13.30 (FORMAT)
unnamed: R37.2, R42.2, R43.1
unnamed: R38.2, R39.1, U14.2 (-IN)
unnamed: R44.2, U14.3 (+IN)
unnamed: R47.2, R48.1, R49.1

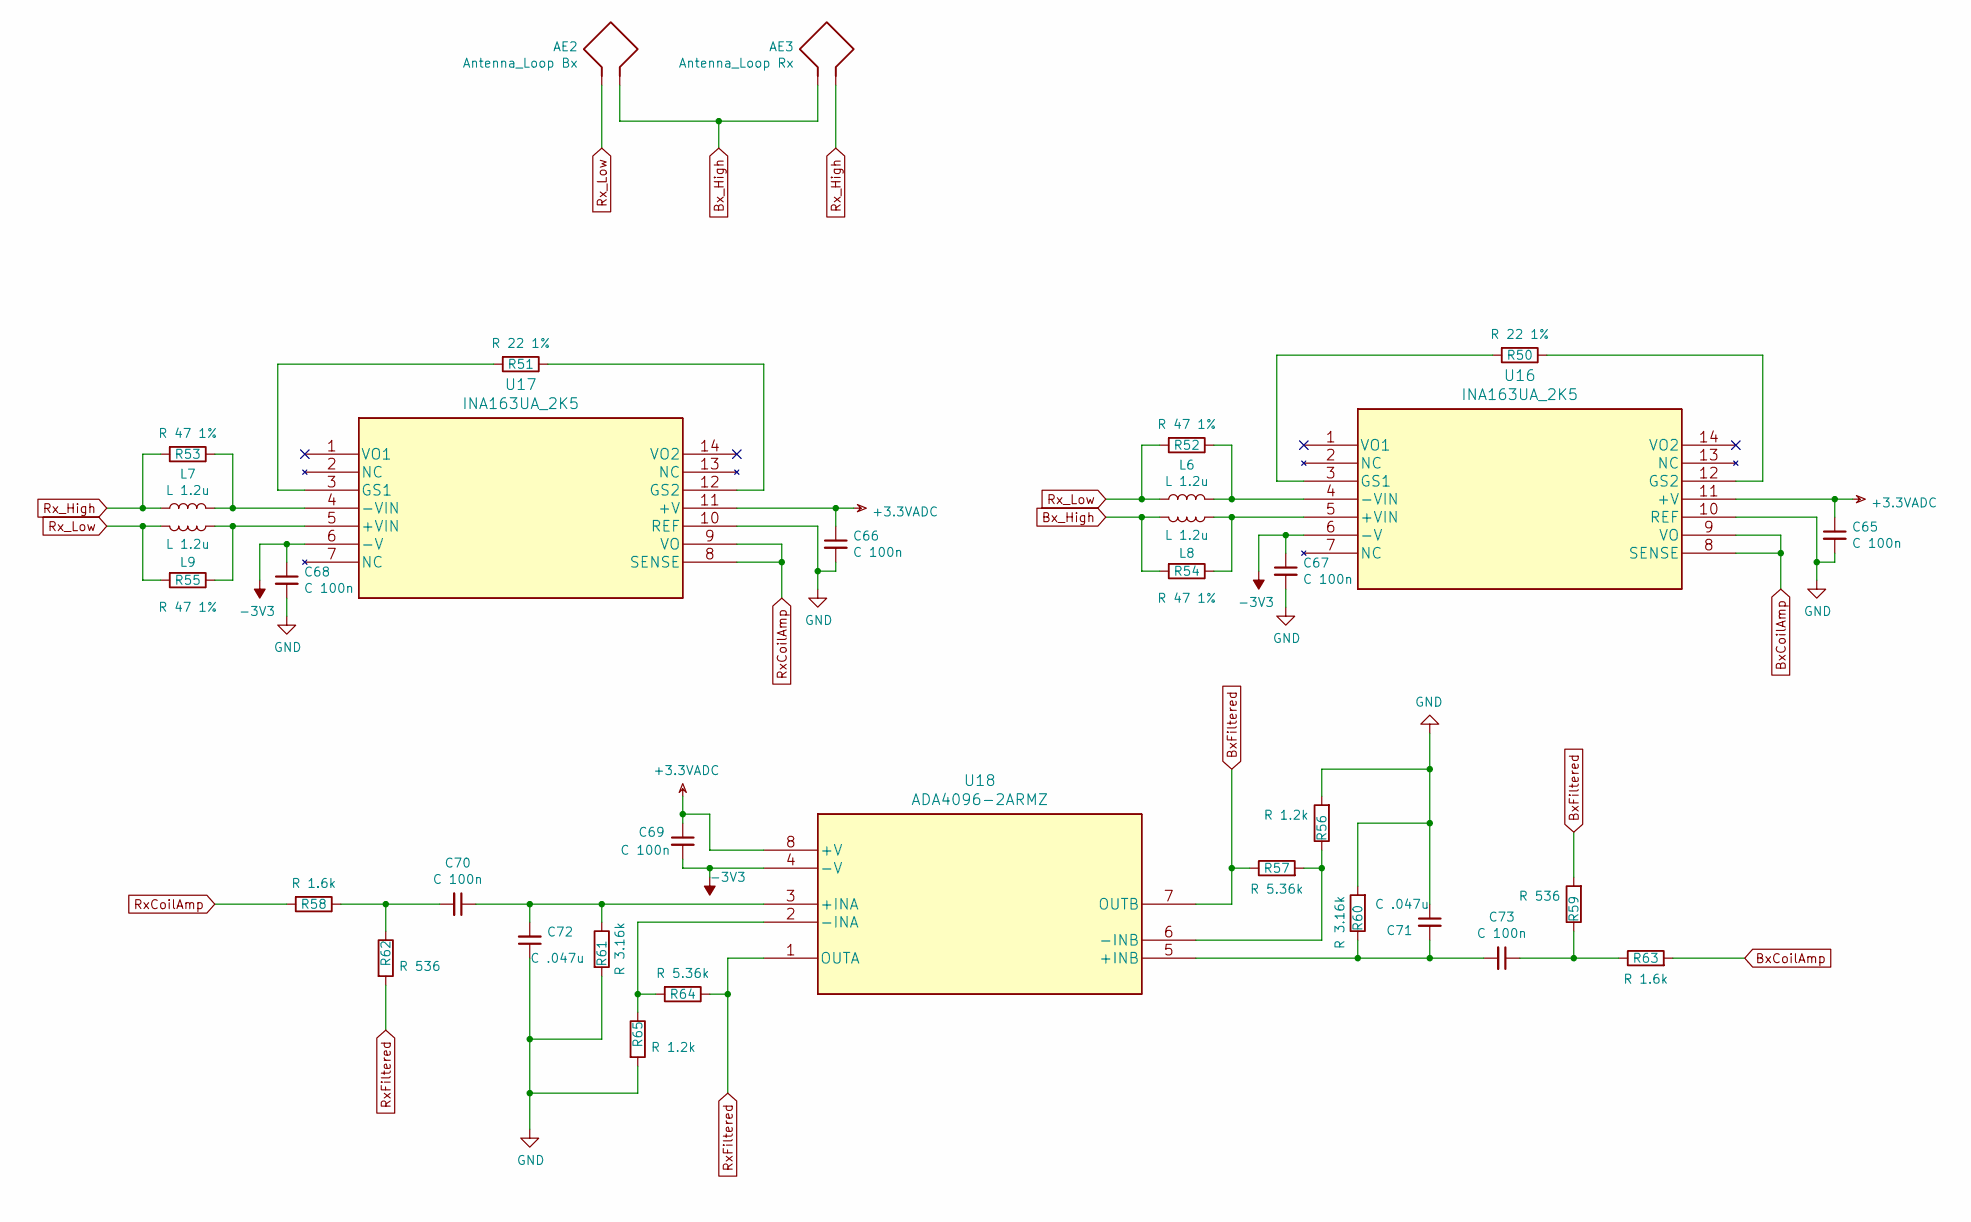
[picture p40: schematic file5DAF1840.sch, Pancreas EMI Conductivity Meter]

Parts:
AE2: Antenna_Loop Bx; SMA_Molex_73251-2200_Horizontal
AE3: Antenna_Loop Rx; SMA_Molex_73251-2200_Horizontal
C65, C66, C67, C68: C 100n; CP_EIA-3216-18_Kemet-A_Pad1.58x1.35mm_HandSolder
C69: C 100n; C_0603_1608Metric_Pad1.05x0.95mm_HandSolder
C70, C73: C 100n; C_1812_4532Metric_Pad1.30x3.40mm_HandSolder
C71, C72: C .047u; C_0805_2012Metric_Pad1.15x1.40mm_HandSolder
L6, L7, L8, L9: L 1.2u; L_0805_2012Metric_Pad1.15x1.40mm_HandSolder
R50, R51: R 22 1%; R_1206_3216Metric_Pad1.42x1.75mm_HandSolder
R52, R53, R54, R55: R 47 1%; R_1206_3216Metric_Pad1.42x1.75mm_HandSolder
R56, R65: R 1.2k; R_0805_2012Metric_Pad1.15x1.40mm_HandSolder
R57, R64: R 5.36k; R_0805_2012Metric_Pad1.15x1.40mm_HandSolder
R58, R63: R 1.6k; R_0805_2012Metric_Pad1.15x1.40mm_HandSolder
R59, R62: R 536; R_0805_2012Metric_Pad1.15x1.40mm_HandSolder
R60, R61: R 3.16k; R_0805_2012Metric_Pad1.15x1.40mm_HandSolder
U16, U17: INA163UA_2K5; SOIC-14_3.9x8.7mm_P1.27mm
U18: ADA4096-2ARMZ; MSOP-8_3x3mm_P0.65mm

Connections:
+3.3VADC: C65.1, C66.1, C69.1, U16.11 (+V), U17.11 (+V), U18.8 (+V); also elsewhere on the board
-3V3: C67.1, C68.1, C69.2, U16.6 (-V), U17.6 (-V), U18.4 (-V); also elsewhere on the board
BxCoilAmp: R63.2, U16.8 (SENSE), U16.9 (VO)
BxFiltered: R57.1, R59.2, U18.7 (OUTB); also elsewhere on the board
Bx_High: AE2.1, AE3.2, L8.2, R54.2
GND: C65.2, C66.2, C67.2, C68.2, C71.1, C72.1, R56.2, R60.2, R61.2, R65.2, U16.10 (REF), U17.10 (REF); also elsewhere on the board
unnamed: C70.1, C72.2, R61.1, U18.3 (+INA)
unnamed: C70.2, R58.1, R62.1
unnamed: C71.2, C73.2, R60.1, U18.5 (+INB)
unnamed: C73.1, R59.1, R63.1
unnamed: L6.2, R52.1, U16.4 (-VIN)
unnamed: L7.2, R53.1, U17.4 (-VIN)
unnamed: L8.1, R54.1, U16.5 (+VIN)
unnamed: L9.1, R55.1, U17.5 (+VIN)
unnamed: R50.1, U16.12 (GS2)
unnamed: R50.2, U16.3 (GS1)
unnamed: R51.1, U17.12 (GS2)
unnamed: R51.2, U17.3 (GS1)
unnamed: R56.1, R57.2, U18.6 (-INB)
unnamed: R64.2, R65.1, U18.2 (-INA)
RxCoilAmp: R58.2, U17.8 (SENSE), U17.9 (VO)
RxFiltered: R62.2, R64.1, U18.1 (OUTA); also elsewhere on the board
Rx_High: AE3.1, L7.1, R53.2
Rx_Low: AE2.2, L6.1, L9.2, R52.2, R55.2

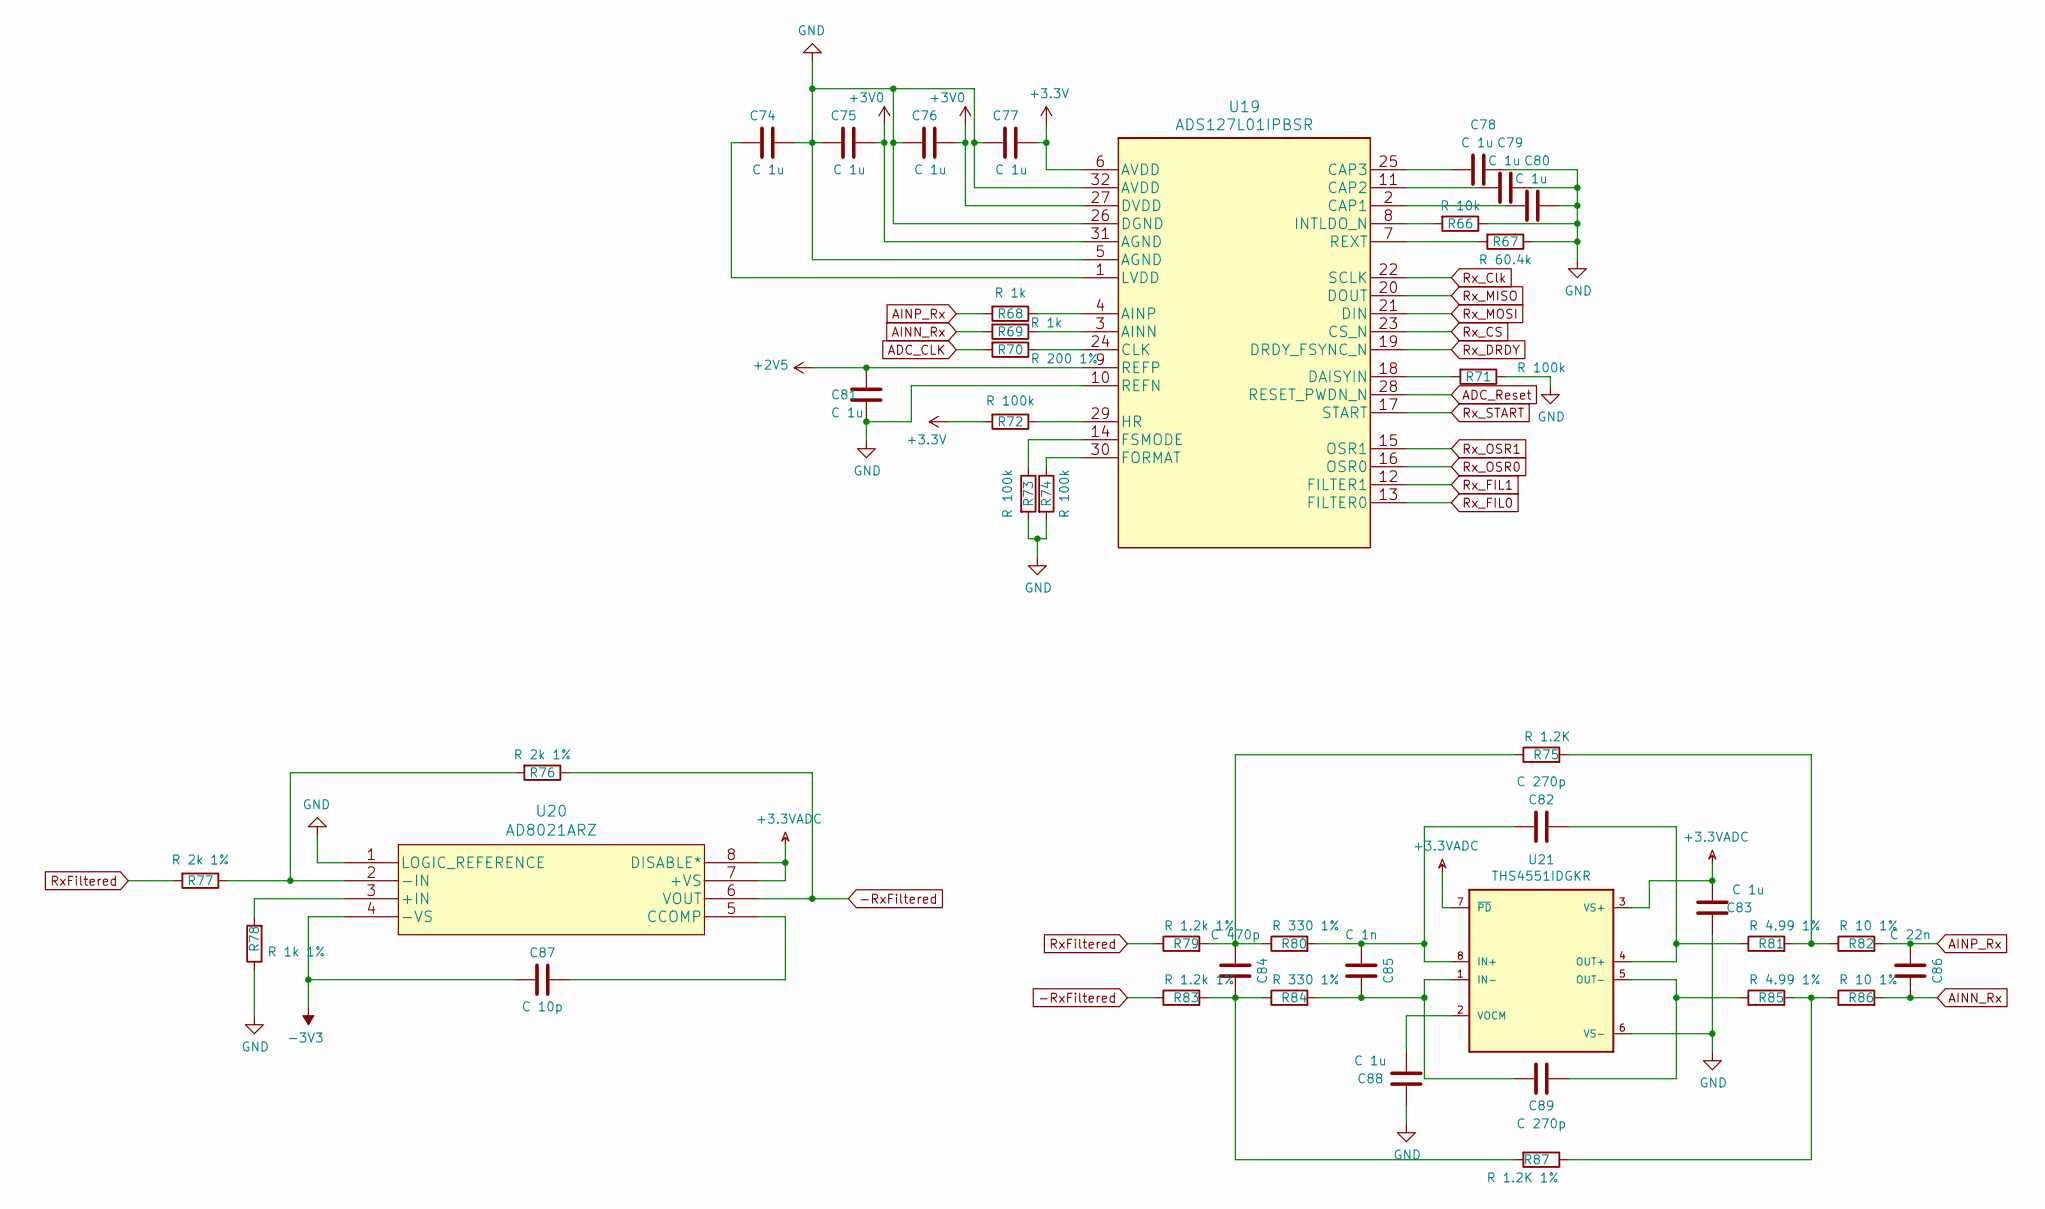
[picture p41: schematic file5D43B00F.sch, Pancreas EMI Conductivity Meter]

Parts:
C74, C75, C76, C77, C78, C79, C80, C81, C83, C88: C 1u; C_0805_2012Metric_Pad1.15x1.40mm_HandSolder
C82, C89: C 270p; C_0805_2012Metric_Pad1.15x1.40mm_HandSolder
C84: C 470p; C_0603_1608Metric_Pad1.05x0.95mm_HandSolder
C85: C 1n; C_0603_1608Metric_Pad1.05x0.95mm_HandSolder
C86: C 22n; C_0805_2012Metric_Pad1.15x1.40mm_HandSolder
C87: C 10p; C_0603_1608Metric_Pad1.05x0.95mm_HandSolder
R66: R 10k; R_0805_2012Metric_Pad1.15x1.40mm_HandSolder
R67: R 60.4k; R_0805_2012Metric_Pad1.15x1.40mm_HandSolder
R68, R69: R 1k; R_0805_2012Metric_Pad1.15x1.40mm_HandSolder
R70: R 200 1%; R_0805_2012Metric_Pad1.15x1.40mm_HandSolder
R71, R72, R73, R74: R 100k; R_0805_2012Metric_Pad1.15x1.40mm_HandSolder
R75: R 1.2K; R_0805_2012Metric_Pad1.15x1.40mm_HandSolder
R76, R77: R 2k 1%; R_0805_2012Metric_Pad1.15x1.40mm_HandSolder
R78: R 1k 1%; R_0805_2012Metric_Pad1.15x1.40mm_HandSolder
R79, R83: R 1.2k 1%; R_0805_2012Metric_Pad1.15x1.40mm_HandSolder
R80, R84: R 330 1%; R_0805_2012Metric_Pad1.15x1.40mm_HandSolder
R81, R85: R 4.99 1%; R_0805_2012Metric_Pad1.15x1.40mm_HandSolder
R82, R86: R 10 1%; R_0805_2012Metric_Pad1.15x1.40mm_HandSolder
R87: R 1.2K 1%; R_0805_2012Metric_Pad1.15x1.40mm_HandSolder
U19: ADS127L01IPBSR; QFP50P700X700X120-32N
U20: AD8021ARZ; SOIC-8_3.9x4.9mm_P1.27mm
U21: THS4551IDGKR; VSSOP-8_3.0x3.0mm_P0.65mm

Connections:
+2V5: C81.1, U19.9 (REFP); also elsewhere on the board
+3.3VADC: C83.2, U20.7 (+VS), U20.8 (DISABLE*), U21.3 (VS+), U21.7 (~PD~); also elsewhere on the board
+3V0: C75.2, C76.2, U19.27 (DVDD), U19.31 (AGND); also elsewhere on the board
+3V3: C77.2, R72.2, U19.6 (AVDD); also elsewhere on the board
-3V3: C87.2, U20.4 (-VS); also elsewhere on the board
-RxFiltered: R76.1, R83.1, U20.6 (VOUT)
ADC_CLK: R70.2; also elsewhere on the board
ADC_Reset: U19.28 (RESET_PWDN_N); also elsewhere on the board
AINN_Rx: C86.1, R69.2, R86.2
AINP_Rx: C86.2, R68.2, R82.2
GND: C74.2, C75.1, C76.1, C77.1, C78.1, C79.1, C80.1, C81.2, C83.1, C88.1, R66.1, R67.1, R71.1, R73.2, R74.2, R78.1, U19.5 (AGND), U19.10 (REFN), U19.26 (DGND), U19.32 (AVDD), U20.1 (LOGIC_REFERENCE), U21.6 (VS-); also elsewhere on the board
unnamed: C74.1, U19.1 (LVDD)
unnamed: C78.2, U19.25 (CAP3)
unnamed: C79.2, U19.11 (CAP2)
unnamed: C80.2, U19.2 (CAP1)
unnamed: C82.1, R81.1, U21.4 (OUT+)
unnamed: C82.2, C85.2, R80.2, U21.8 (IN+)
unnamed: C84.1, R83.2, R84.1, R87.2
unnamed: C84.2, R75.1, R79.2, R80.1
unnamed: C85.1, C89.1, R84.2, U21.1 (IN-)
unnamed: C87.1, U20.5 (CCOMP)
unnamed: C88.2, U21.2 (VOCM)
unnamed: C89.2, R85.1, U21.5 (OUT-)
unnamed: R66.2, U19.8 (INTLDO_N)
unnamed: R67.2, U19.7 (REXT)
unnamed: R68.1, U19.4 (AINP)
unnamed: R69.1, U19.3 (AINN)
unnamed: R70.1, U19.24 (CLK)
unnamed: R71.2, U19.18 (DAISYIN)
unnamed: R72.1, U19.29 (HR)
unnamed: R73.1, U19.14 (FSMODE)
unnamed: R74.1, U19.30 (FORMAT)
unnamed: R75.2, R81.2, R82.1
unnamed: R76.2, R77.1, U20.2 (-IN)
unnamed: R78.2, U20.3 (+IN)
unnamed: R85.2, R86.1, R87.1
RxFiltered: R77.2, R79.1; also elsewhere on the board
Rx_CS: U19.23 (CS_N); also elsewhere on the board
Rx_Clk: U19.22 (SCLK); also elsewhere on the board
Rx_DRDY: U19.19 (DRDY_FSYNC_N); also elsewhere on the board
Rx_FIL0: U19.13 (FILTER0); also elsewhere on the board
Rx_FIL1: U19.12 (FILTER1); also elsewhere on the board
Rx_MISO: U19.20 (DOUT); also elsewhere on the board
Rx_MOSI: U19.21 (DIN); also elsewhere on the board
Rx_OSR0: U19.16 (OSR0); also elsewhere on the board
Rx_OSR1: U19.15 (OSR1); also elsewhere on the board
Rx_START: U19.17 (START); also elsewhere on the board

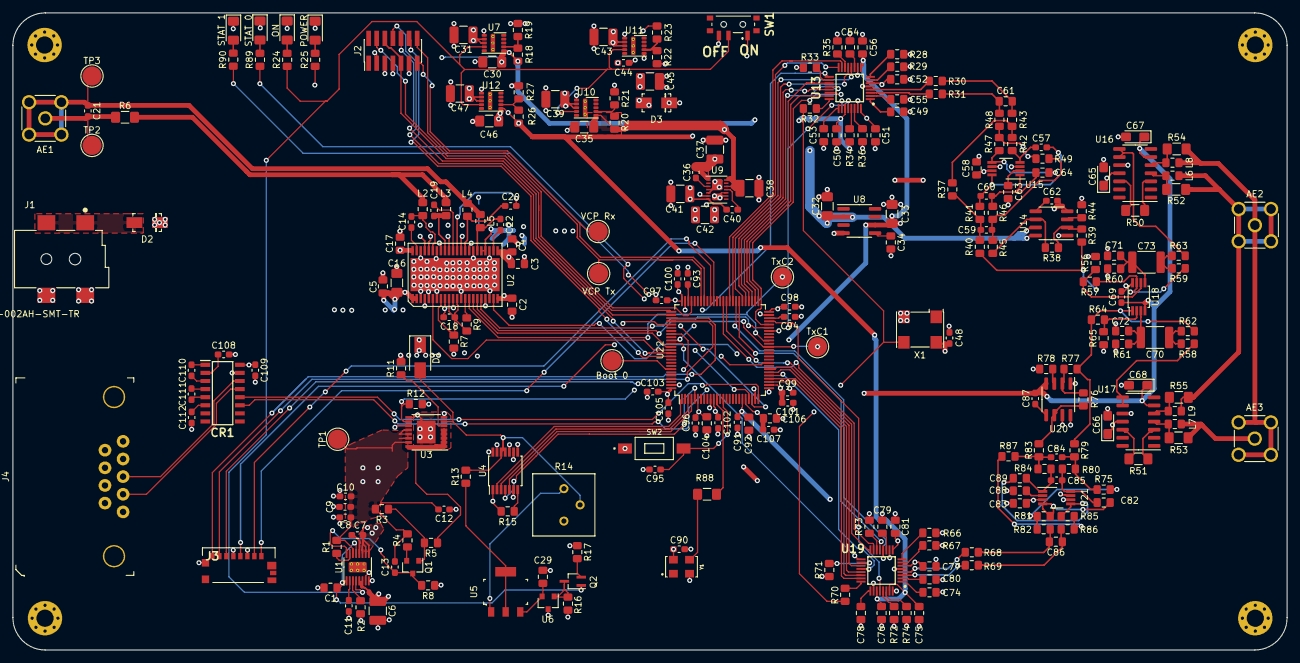
[picture p42: board EMI_sensor_control_Rev2.0.kicad_pcb from above]

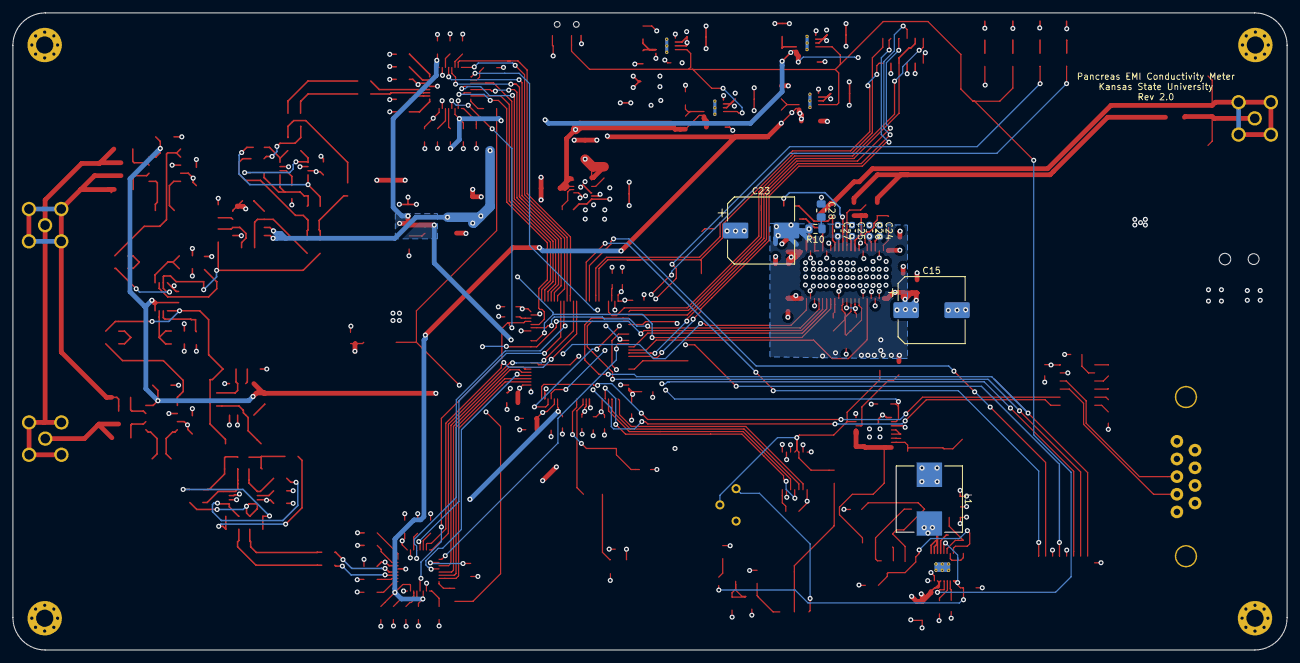
[picture p43: board EMI_sensor_control_Rev2.0.kicad_pcb from below]

Board: 4 copper layers, 200.0 x 100.0 mm, 266 parts (9 on the bottom side), 197 nets.

Other parts of the board:
Boot 0: TestPoint; TestPoint_Pad_D3.0mm
ON: LED On; LED_1206_3216Metric_Pad1.42x1.75mm_HandSolder
POWER: LED Power; LED_1206_3216Metric_Pad1.42x1.75mm_HandSolder
STAT 0: LED Stat 0; LED_1206_3216Metric_Pad1.42x1.75mm_HandSolder
STAT 1: LED Stat 1; LED_1206_3216Metric_Pad1.42x1.75mm_HandSolder
TxC1, TxC2: TestPoint; TestPoint_Pad_D3.0mm
VCP Rx: TestPoint; TestPoint_Pad_D3.0mm
VCP Tx: TestPoint; TestPoint_Pad_D3.0mm

Their connections:
GND: ON.1, POWER.1, STAT 0.1, STAT 1.1; also elsewhere on the board
unnamed 108: ON.2; also elsewhere on the board
unnamed 109: POWER.2; also elsewhere on the board
unnamed 110: STAT 0.2; also elsewhere on the board
unnamed 111: STAT 1.2; also elsewhere on the board
unnamed 180: Boot 0.1; also elsewhere on the board
TxC1: TxC1.1; also elsewhere on the board
TxC2: TxC2.1; also elsewhere on the board
VCP_Rx: VCP Rx.1; also elsewhere on the board
VCP_Tx: VCP Tx.1; also elsewhere on the board
