95jasmith/EMI-sensor/Building sensor/Designs/EMI_sensor_control_Rev1.0/EMI_sensor_control_Rev1.0.kicad_pcb

## KiCad design Building sensor/Designs/EMI_sensor_control_Rev1.0/EMI_sensor_control_Rev1.0.kicad_pcb (2019-08-27, an earlier design)

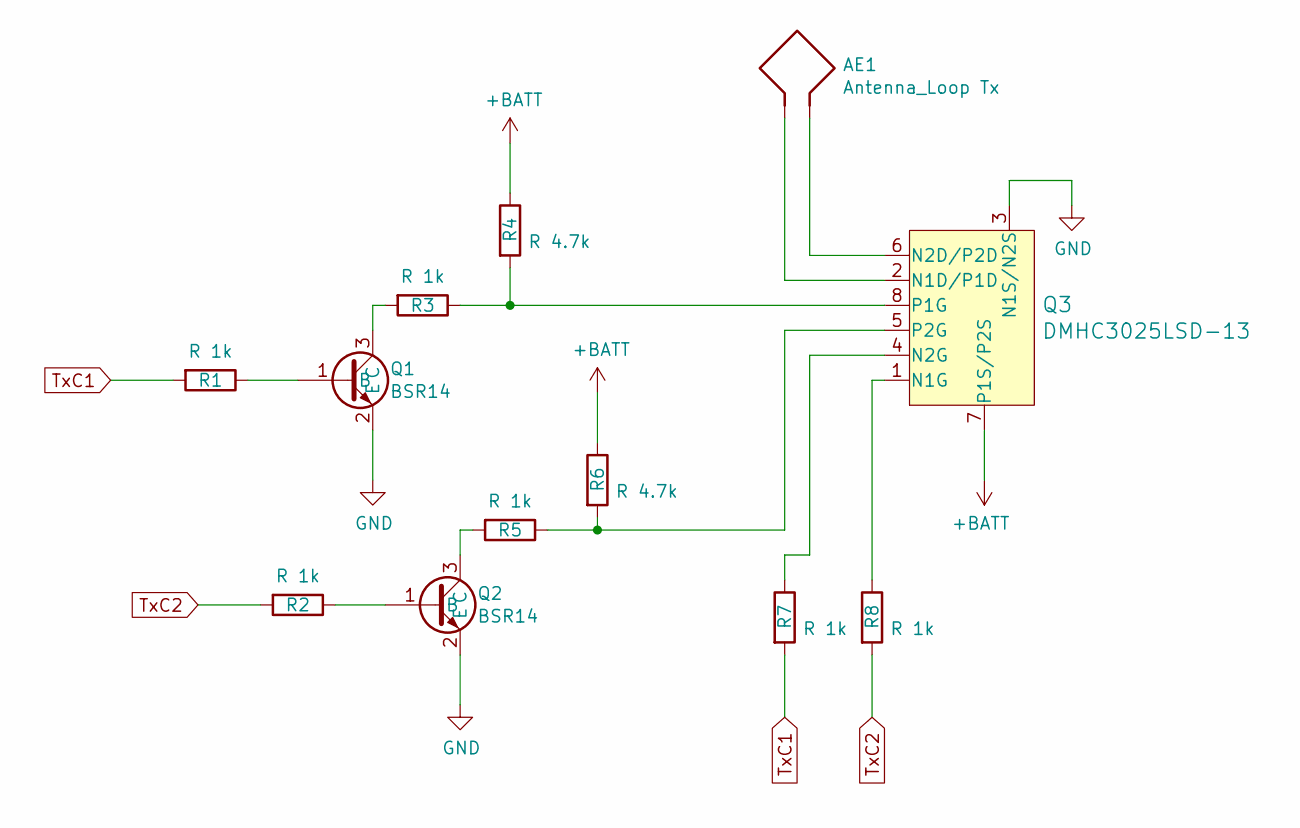
[picture p44: schematic file5D278C8E.sch, Pancreas EMI Conductivity Meter]

Parts:
AE1: Antenna_Loop Tx; SMA_Molex_73251-2200_Horizontal
Q1, Q2: BSR14; SOT-23_Handsoldering
Q3: DMHC3025LSD-13; SOIC-8_W3.9mm; MPN DMHC3025LSD-13; Digi-Key_PN DMHC3025LSD-13DICT-ND
R1, R2, R3, R5, R7, R8: R 1k; R_0805_2012Metric_Pad1.15x1.40mm_HandSolder
R4, R6: R 4.7k; R_0805_2012Metric_Pad1.15x1.40mm_HandSolder

Connections:
ADR0r: Q1.2 (E), Q2.2 (E), Q3.3 (N1S/N2S); also elsewhere on the board
unnamed: AE1.1, Q3.2 (N1D/P1D)
unnamed: AE1.2, Q3.6 (N2D/P2D)
unnamed: Q1.1 (B), R1.1
unnamed: Q1.3 (C), R3.2
unnamed: Q2.1 (B), R2.1
unnamed: Q2.3 (C), R5.2
unnamed: Q3.1 (N1G), R8.1
unnamed: Q3.4 (N2G), R7.1
unnamed: Q3.5 (P2G), R5.1, R6.2
unnamed: Q3.8 (P1G~), R3.1, R4.2
TxC1: R1.2, R7.2; also elsewhere on the board
TxC2: R2.2, R8.2; also elsewhere on the board

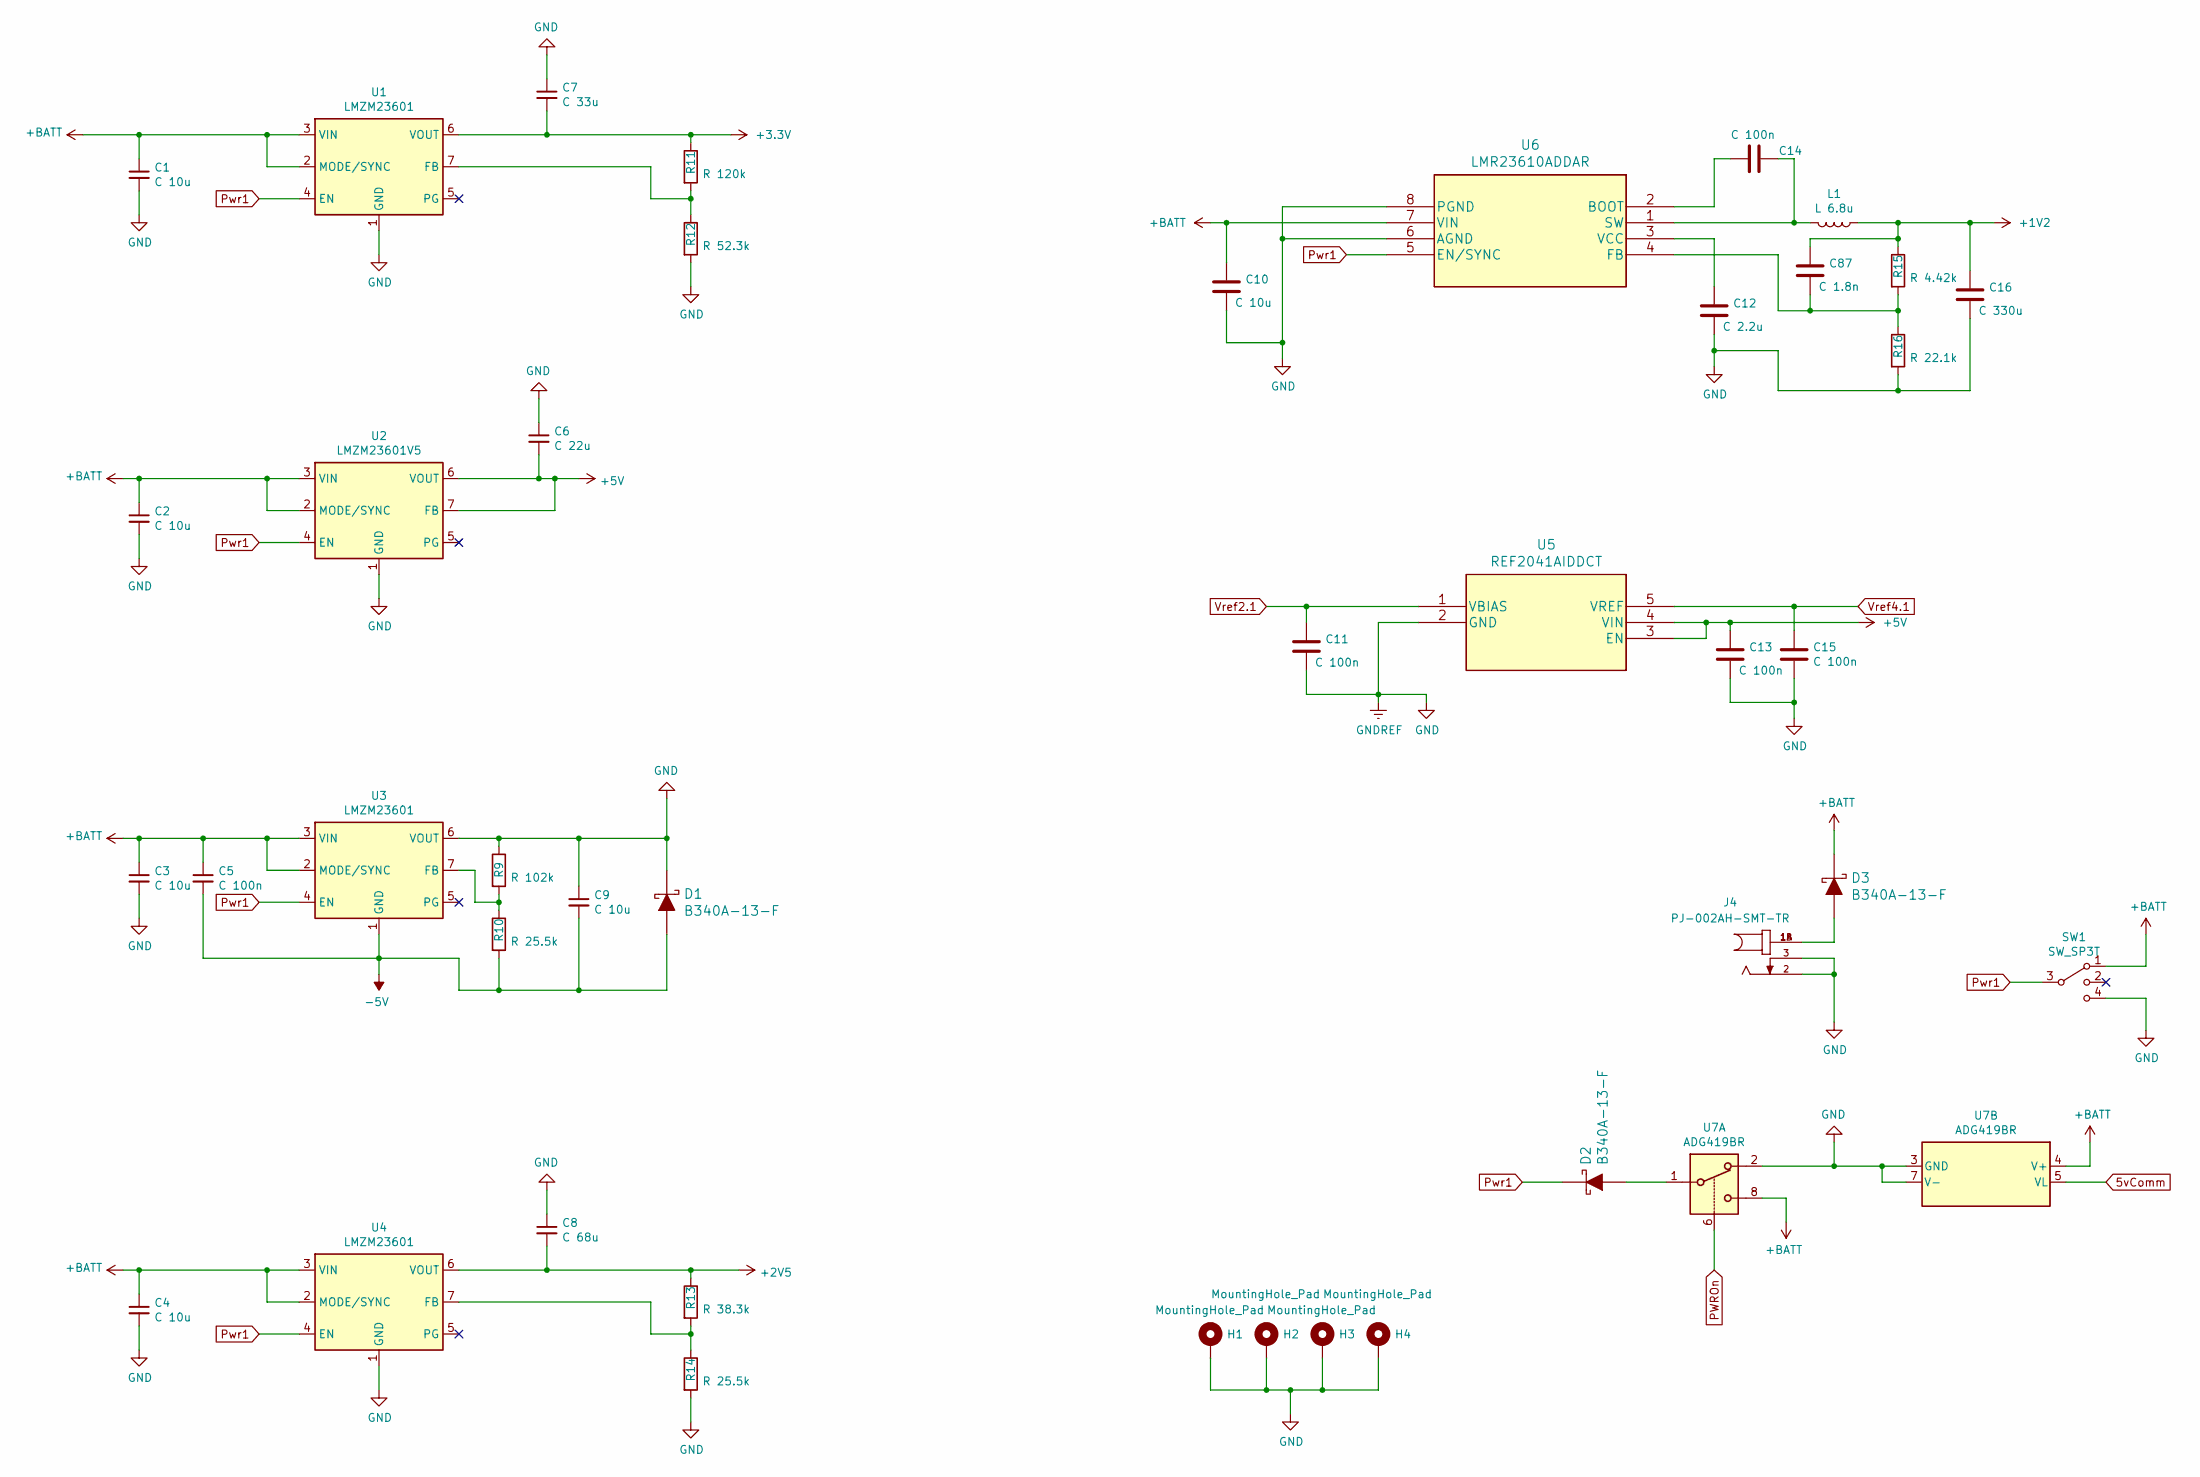
[picture p45: schematic file5D27CADE.sch, Pancreas EMI Conductivity Meter]

Parts:
C1, C2, C3, C4, C9, C10: C 10u; C_1210_3225Metric_Pad1.42x2.65mm_HandSolder
C5: C 100n; C_0805_2012Metric_Pad1.15x1.40mm_HandSolder
C6: C 22u; C_1206_3216Metric_Pad1.42x1.75mm_HandSolder
C7: C 33u; C_1206_3216Metric_Pad1.42x1.75mm_HandSolder
C8: C 68u; C_1206_3216Metric_Pad1.42x1.75mm_HandSolder
C11, C13, C14, C15: C 100n; C_0603_1608Metric_Pad1.05x0.95mm_HandSolder
C12: C 2.2u; C_0603_1608Metric_Pad1.05x0.95mm_HandSolder
C16: C 330u; CP_Elec_5x5.3
C87: C 1.8n; C_0805_2012Metric_Pad1.15x1.40mm_HandSolder
D1, D2, D3: B340A-13-F; DO-214AC; MPN B340A-13-F; Digi-Key_PN B340A-FDICT-ND
H1, H2, H3, H4: MountingHole_Pad; MountingHole_2.7mm_M2.5_Pad_Via
J4: PJ-002AH-SMT-TR; CUI_PJ-002AH-SMT-TR
L1: L 6.8u; SRN6045-6R8Y
R9: R 102k; R_0805_2012Metric_Pad1.15x1.40mm_HandSolder
R10, R14: R 25.5k; R_0805_2012Metric_Pad1.15x1.40mm_HandSolder
R11: R 120k; R_0805_2012Metric_Pad1.15x1.40mm_HandSolder
R12: R 52.3k; R_0805_2012Metric_Pad1.15x1.40mm_HandSolder
R13: R 38.3k; R_0805_2012Metric_Pad1.15x1.40mm_HandSolder
R15: R 4.42k; R_1206_3216Metric_Pad1.42x1.75mm_HandSolder
R16: R 22.1k; R_1206_3216Metric_Pad1.42x1.75mm_HandSolder
SW1: SW_SP3T; SW_SP3T_PCM13
U1, U3, U4: LMZM23601; Texas_SIL0010A_MicroSiP-10-1EP_3.8x3mm_P0.6mm_EP0.7x2.9mm_T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
U2: LMZM23601V5; Texas_SIL0010A_MicroSiP-10-1EP_3.8x3mm_P0.6mm_EP0.7x2.9mm_T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
U5: REF2041AIDDCT
U6: LMR23610ADDAR
U7: ADG419BR; SOIC-8_3.9x4.9mm_P1.27mm

Connections:
5vComm: U7.5 (VL); also elsewhere on the board
+1V2: C16.1, C87.1, L1.1, R15.1; also elsewhere on the board
+2V5: C8.2, R13.1, U4.6 (VOUT); also elsewhere on the board
+5V: C6.2, C13.1, U2.6 (VOUT), U2.7 (FB), U5.3 (EN), U5.4 (VIN); also elsewhere on the board
-5V: C5.2, C9.2, D1.A, R10.2, U3.1 (GND), U3.11 (GND); also elsewhere on the board
ADR0r: C1.2, C2.2, C3.2, C4.2, C6.1, C7.1, C8.1, C9.1, C10.2, C11.2, C12.2, C13.2, C15.2, C16.2, D1.K, H1.1, H2.1, H3.1, H4.1, J4.2, J4.3, R9.1, R12.2, R14.2, R16.2, SW1.4, U1.1 (GND), U1.11 (GND), U2.1 (GND), U2.11 (GND), U3.6 (VOUT), U4.1 (GND), U4.11 (GND), U5.2 (GND), U6.6 (AGND), U6.8 (PGND), U7.2, U7.3 (GND), U7.7 (V-); also elsewhere on the board
unnamed: C12.1, U6.3 (VCC)
unnamed: C14.1, L1.2, U6.1 (SW)
unnamed: C14.2, U6.2 (BOOT)
unnamed: C87.2, R15.2, R16.1, U6.4 (FB)
unnamed: D2.A, U7.1
unnamed: R9.2, R10.1, U3.7 (FB)
unnamed: R11.2, R12.1, U1.7 (FB)
unnamed: R13.2, R14.1, U4.7 (FB)
PWROn: U7.6; also elsewhere on the board
Pwr1: D2.K, SW1.3, U1.4 (EN), U2.4 (EN), U3.4 (EN), U4.4 (EN), U6.5 (EN/SYNC)
VDD1: C7.2, R11.1, U1.6 (VOUT); also elsewhere on the board
Vref2.1: C11.1, U5.1 (VBIAS); also elsewhere on the board
Vref4.1: C15.1, U5.5 (VREF); also elsewhere on the board
