95jasmith/EMI-sensor/Building sensor/Designs/EMI_sensor_control_Rev1.0/EMI_sensor_control_Rev1.0.kicad_pcb

## KiCad design Building sensor/Designs/EMI_sensor_control_Rev1.0/EMI_sensor_control_Rev1.0.kicad_pcb (continued)

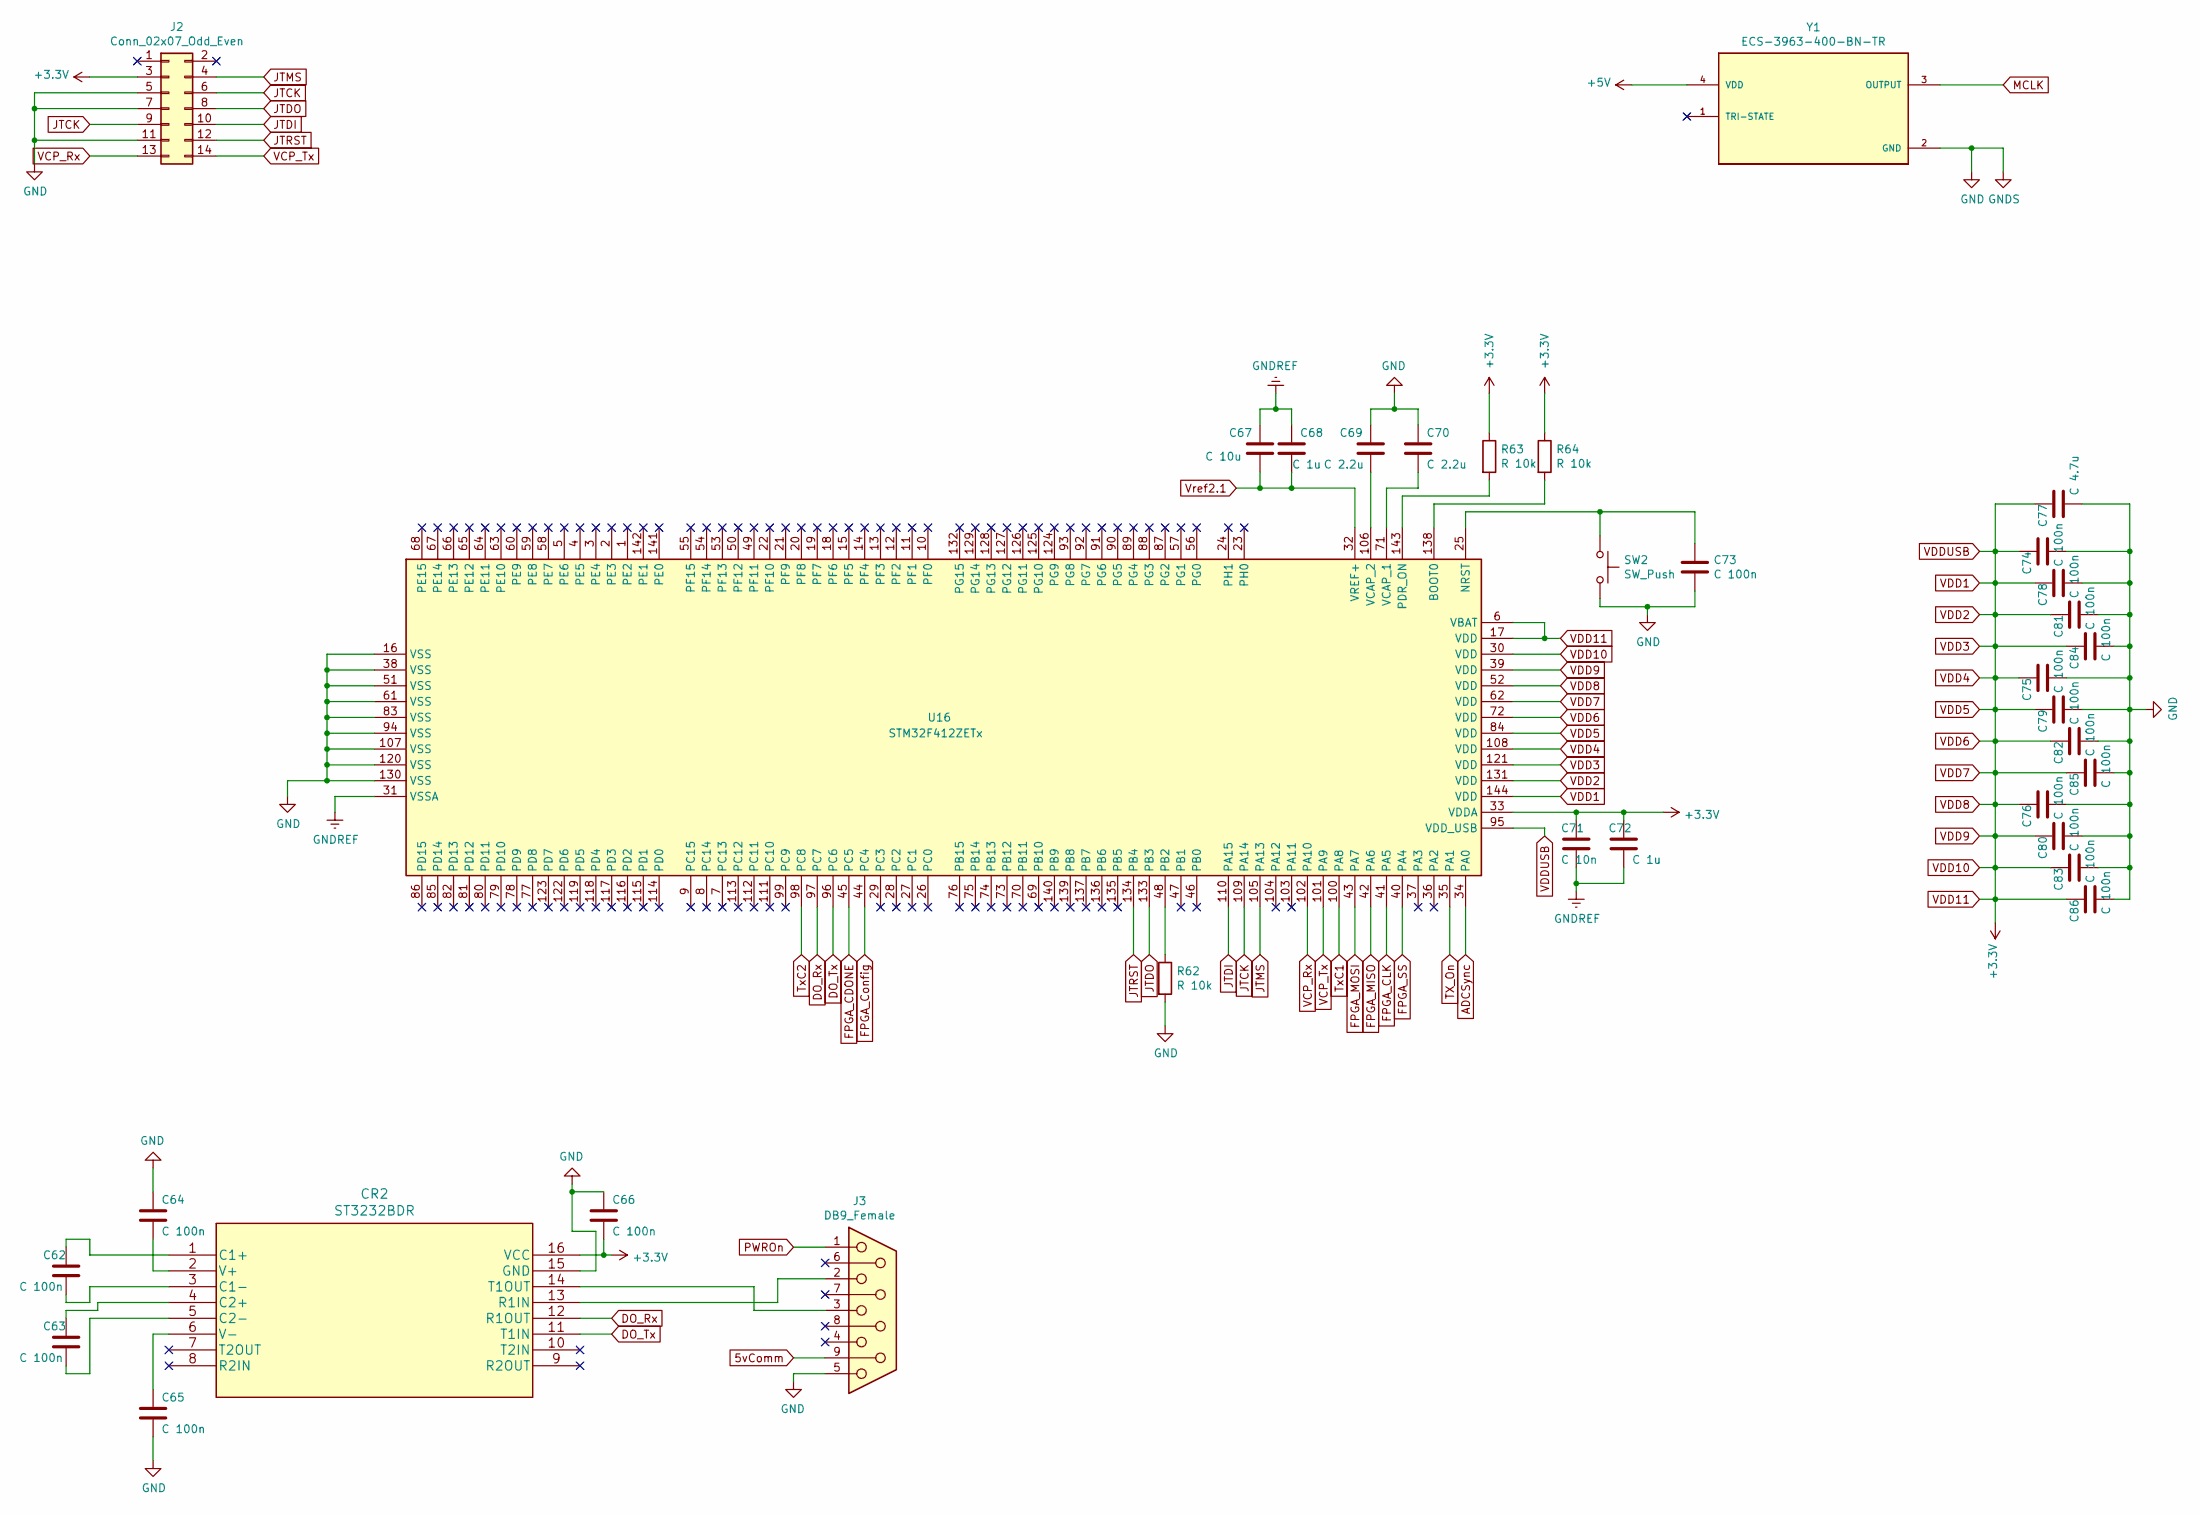
[picture p46: schematic file5D2792E2.sch, Pancreas EMI Conductivity Meter]

Parts:
C62, C63, C64, C65, C66, C73, C74, C75, C76, C78, C79, C80, C81, C82, C83, C84, C85, C86: C 100n; C_0603_1608Metric_Pad1.05x0.95mm_HandSolder
C67: C 10u; C_1210_3225Metric_Pad1.42x2.65mm_HandSolder
C68, C72: C 1u; C_0805_2012Metric_Pad1.15x1.40mm_HandSolder
C69, C70: C 2.2u; C_0603_1608Metric_Pad1.05x0.95mm_HandSolder
C71: C 10n; C_0805_2012Metric_Pad1.15x1.40mm_HandSolder
C77: C 4.7u; C_0805_2012Metric_Pad1.15x1.40mm_HandSolder
CR2: ST3232BDR
J2: Conn_02x07_Odd_Even; PinHeader_2x07_P1.27mm_Vertical_SMD
J3: DB9_Female; DSUB-9_Receptical_A-DF_09_A_KG-T2S
R62, R63, R64: R 10k; R_1206_3216Metric_Pad1.42x1.75mm_HandSolder
SW2: SW_Push; SW_1437566-4
U16: STM32F412ZETx; LQFP-144_20x20mm_P0.5mm
Y1: ECS-3963-400-BN-TR; OSC_ECS-3963-400-BN-TR

Connections:
5vComm: J3.9; also elsewhere on the board
+5V: Y1.4 (VDD); also elsewhere on the board
ADCSync: U16.34 (PA0); also elsewhere on the board
ADR0r: C64.2, C65.1, C66.2, C67.1, C68.1, C69.1, C70.1, C71.1, C72.1, C73.2, C74.1, C75.1, C76.1, C77.1, C78.1, C79.1, C80.1, C81.1, C82.1, C83.1, C84.1, C85.1, C86.1, CR2.15 (GND), J2.5, J2.7, J2.11, J3.5, R62.2, SW2.2, U16.16 (VSS), U16.31 (VSSA), U16.38 (VSS), U16.51 (VSS), U16.61 (VSS), U16.83 (VSS), U16.94 (VSS), U16.107 (VSS), U16.120 (VSS), U16.130 (VSS), Y1.2 (GND); also elsewhere on the board
DO_Rx: CR2.12 (R1OUT), U16.97 (PC7)
DO_Tx: CR2.11 (T1IN), U16.96 (PC6)
FPGA_CDONE: U16.45 (PC5); also elsewhere on the board
FPGA_CLK: U16.41 (PA5); also elsewhere on the board
FPGA_Config: U16.44 (PC4); also elsewhere on the board
FPGA_MISO: U16.42 (PA6); also elsewhere on the board
FPGA_MOSI: U16.43 (PA7); also elsewhere on the board
FPGA_SS: U16.40 (PA4); also elsewhere on the board
JTCK: J2.6, J2.9, U16.109 (PA14)
JTDI: J2.10, U16.110 (PA15)
JTDO: J2.8, U16.133 (PB3)
JTMS: J2.4, U16.105 (PA13)
JTRST: J2.12, U16.134 (PB4)
MCLK: Y1.3 (OUTPUT); also elsewhere on the board
unnamed: C62.1, CR2.3 (C1-)
unnamed: C62.2, CR2.1 (C1+)
unnamed: C63.1, CR2.5 (C2-)
unnamed: C63.2, CR2.4 (C2+)
unnamed: C64.1, CR2.2 (V+)
unnamed: C65.2, CR2.6 (V-)
unnamed: C69.2, U16.106 (VCAP_2)
unnamed: C70.2, U16.71 (VCAP_1)
unnamed: C73.1, SW2.1, U16.25 (NRST)
unnamed: CR2.13 (R1IN), J3.2
unnamed: CR2.14 (T1OUT), J3.3
unnamed: R62.1, U16.48 (PB2)
unnamed: R63.2, U16.143 (PDR_ON)
unnamed: R64.2, U16.138 (BOOT0)
PWROn: J3.1; also elsewhere on the board
TX_On: U16.35 (PA1); also elsewhere on the board
TxC1: U16.100 (PA8); also elsewhere on the board
TxC2: U16.98 (PC8); also elsewhere on the board
VCP_Rx: J2.13, U16.102 (PA10)
VCP_Tx: J2.14, U16.101 (PA9)
VDD1: C66.1, C71.2, C72.2, C74.2, C75.2, C76.2, C77.2, C78.2, C79.2, C80.2, C81.2, C82.2, C83.2, C84.2, C85.2, C86.2, CR2.16 (VCC), J2.3, R63.1, R64.1, U16.6 (VBAT), U16.17 (VDD), U16.30 (VDD), U16.33 (VDDA), U16.39 (VDD), U16.52 (VDD), U16.62 (VDD), U16.72 (VDD), U16.84 (VDD), U16.95 (VDD_USB), U16.108 (VDD), U16.121 (VDD), U16.131 (VDD), U16.144 (VDD); also elsewhere on the board
Vref2.1: C67.2, C68.2, U16.32 (VREF+); also elsewhere on the board

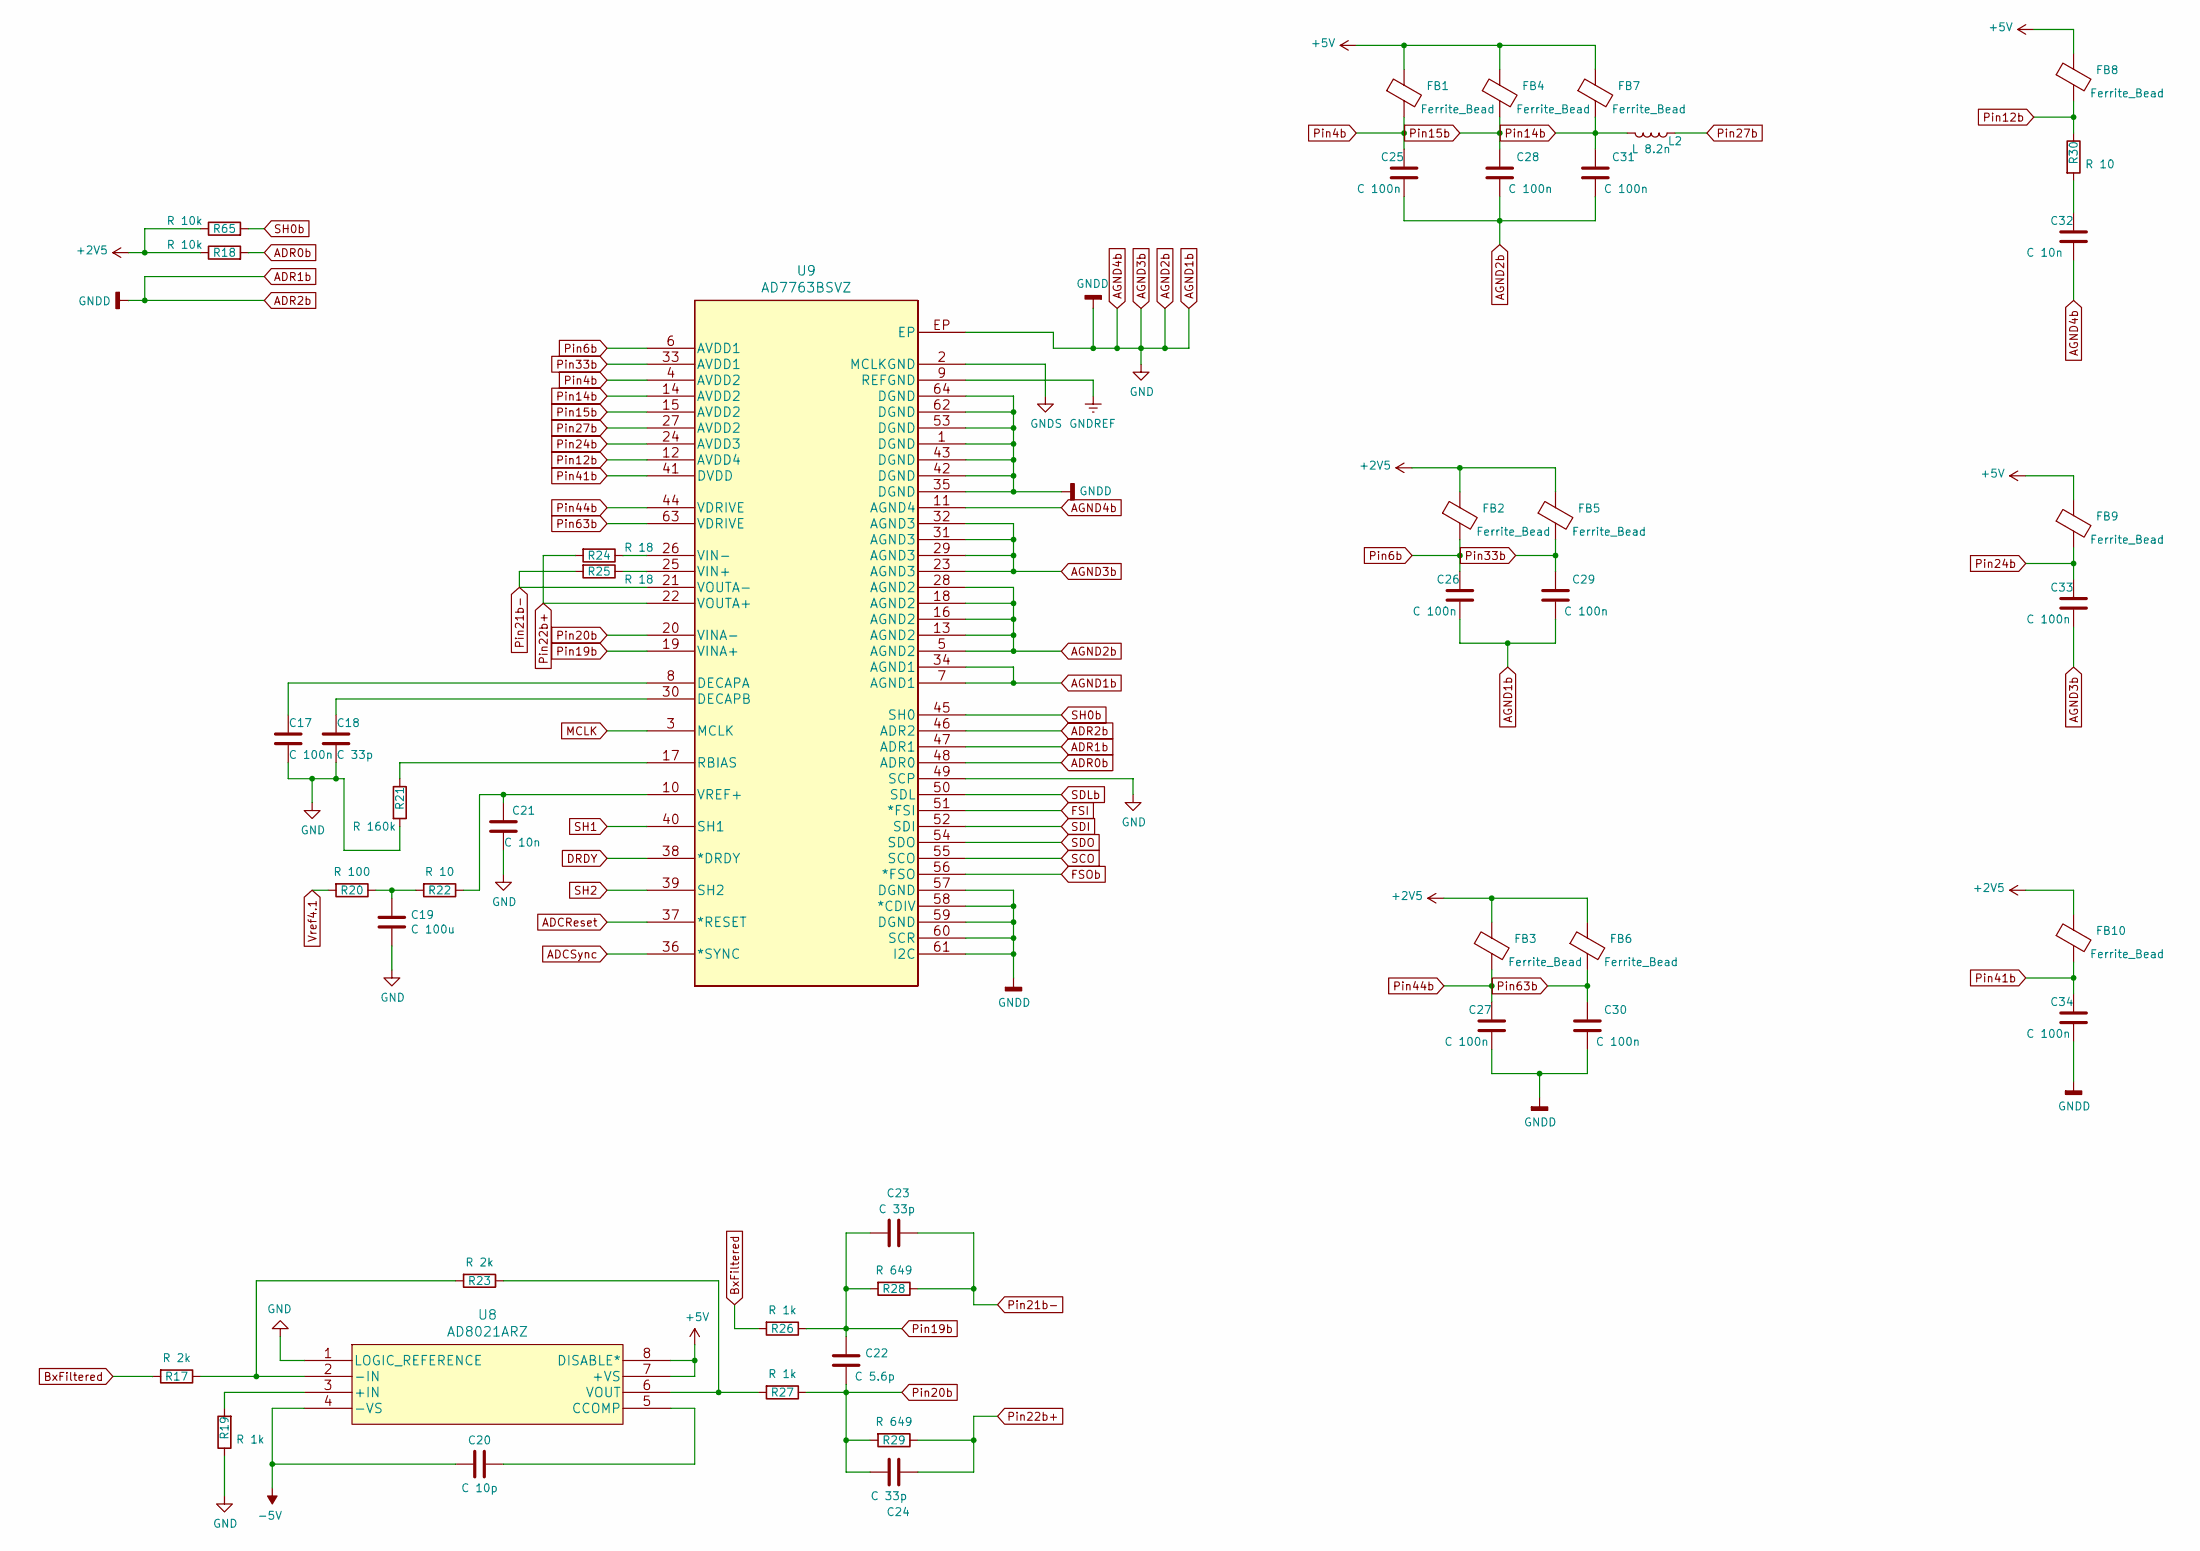
[picture p47: schematic file5D43B07A.sch, Pancreas EMI Conductivity Meter]

Parts:
C17, C25, C26, C27, C28, C29, C30, C31, C33, C34: C 100n; C_0603_1608Metric_Pad1.05x0.95mm_HandSolder
C18, C23, C24: C 33p; C_0402_1005Metric
C19: C 100u; CP_EIA-7343-30_AVX-N_Pad2.25x2.55mm_HandSolder
C20: C 10p; C_0805_2012Metric_Pad1.15x1.40mm_HandSolder
C21, C32: C 10n; C_0805_2012Metric_Pad1.15x1.40mm_HandSolder
C22: C 5.6p; C_0402_1005Metric
FB1, FB2, FB3, FB4, FB5, FB6, FB7, FB8, FB9, FB10: Ferrite_Bead; C_0603_1608Metric_Pad1.05x0.95mm_HandSolder
L2: L 8.2n; L_0603_1608Metric_Pad1.05x0.95mm_HandSolder
R17, R23: R 2k; R_0805_2012Metric_Pad1.15x1.40mm_HandSolder
R18, R65: R 10k; R_1206_3216Metric_Pad1.42x1.75mm_HandSolder
R19, R26, R27: R 1k; R_0805_2012Metric_Pad1.15x1.40mm_HandSolder
R20: R 100; R_1206_3216Metric_Pad1.42x1.75mm_HandSolder
R21: R 160k; R_1206_3216Metric_Pad1.42x1.75mm_HandSolder
R22, R30: R 10; R_1206_3216Metric_Pad1.42x1.75mm_HandSolder
R24, R25: R 18; R_0805_2012Metric_Pad1.15x1.40mm_HandSolder
R28, R29: R 649; R_0805_2012Metric_Pad1.15x1.40mm_HandSolder
U8: AD8021ARZ
U9: AD7763BSVZ

Connections:
+2V5: FB2.1, FB3.1, FB5.1, FB6.1, FB10.1, R18.1, R65.1; also elsewhere on the board
+5V: FB1.1, FB4.1, FB7.1, FB8.1, FB9.1, U8.7 (+VS), U8.8 (DISABLE*); also elsewhere on the board
-5V: C20.2, U8.4 (-VS); also elsewhere on the board
ADCReset: U9.37 (*RESET); also elsewhere on the board
ADCSync: U9.36 (*SYNC); also elsewhere on the board
ADR0b: R18.2, U9.48 (ADR0)
ADR0r: C17.2, C18.2, C19.2, C21.2, C25.2, C26.2, C27.2, C28.2, C29.2, C30.2, C31.2, C32.2, C33.2, C34.2, R19.1, R21.2, U8.1 (LOGIC_REFERENCE), U9.1 (DGND), U9.2 (MCLKGND), U9.5 (AGND2), U9.7 (AGND1), U9.9 (REFGND), U9.11 (AGND4), U9.13 (AGND2), U9.16 (AGND2), U9.18 (AGND2), U9.23 (AGND3), U9.28 (AGND2), U9.29 (AGND3), U9.31 (AGND3), U9.32 (AGND3), U9.34 (AGND1), U9.35 (DGND), U9.39 (SH2), U9.40 (SH1), U9.42 (DGND), U9.43 (DGND), U9.46 (ADR2), U9.47 (ADR1), U9.49 (SCP), U9.53 (DGND), U9.57 (DGND), U9.58 (*CDIV), U9.59 (DGND), U9.60 (SCR), U9.61 (I2C), U9.62 (DGND), U9.64 (DGND), U9.EP; also elsewhere on the board
BxFiltered: R17.2, R26.2; also elsewhere on the board
DRDY: U9.38 (*DRDY); also elsewhere on the board
FSI: U9.51 (*FSI); also elsewhere on the board
FSOb: U9.56 (*FSO); also elsewhere on the board
MCLK: U9.3 (MCLK); also elsewhere on the board
unnamed: C17.1, U9.8 (DECAPA)
unnamed: C18.1, U9.30 (DECAPB)
unnamed: C19.1, R20.1, R22.2
unnamed: C20.1, U8.5 (CCOMP)
unnamed: C21.1, R22.1, U9.10 (VREF+)
unnamed: C32.1, R30.2
unnamed: R17.1, R23.2, U8.2 (-IN)
unnamed: R19.2, U8.3 (+IN)
unnamed: R21.1, U9.17 (RBIAS)
unnamed: R23.1, R27.2, U8.6 (VOUT)
unnamed: R24.1, U9.26 (VIN-)
unnamed: R25.1, U9.25 (VIN+)
Pin4b: C25.1, FB1.2, U9.4 (AVDD2)
Pin6b: C26.1, FB2.2, U9.6 (AVDD1)
Pin12b: FB8.2, R30.1, U9.12 (AVDD4)
Pin14b: C31.1, FB7.2, L2.2, U9.14 (AVDD2)
Pin15b: C28.1, FB4.2, U9.15 (AVDD2)
Pin19b: C22.1, C23.2, R26.1, R28.2, U9.19 (VINA+)
Pin20b: C22.2, C24.2, R27.1, R29.2, U9.20 (VINA-)
Pin21b-: C23.1, R25.2, R28.1, U9.21 (VOUTA-)
Pin22b+: C24.1, R24.2, R29.1, U9.22 (VOUTA+)
Pin24b: C33.1, FB9.2, U9.24 (AVDD3)
Pin27b: L2.1, U9.27 (AVDD2)
Pin33b: C29.1, FB5.2, U9.33 (AVDD1)
Pin41b: C34.1, FB10.2, U9.41 (DVDD)
Pin44b: C27.1, FB3.2, U9.44 (VDRIVE)
Pin63b: C30.1, FB6.2, U9.63 (VDRIVE)
SCO: U9.55 (SCO); also elsewhere on the board
SDI: U9.52 (SDI); also elsewhere on the board
SDLb: U9.50 (SDL); also elsewhere on the board
SDO: U9.54 (SDO); also elsewhere on the board
SH0b: R65.2, U9.45 (SH0)
Vref4.1: R20.2; also elsewhere on the board

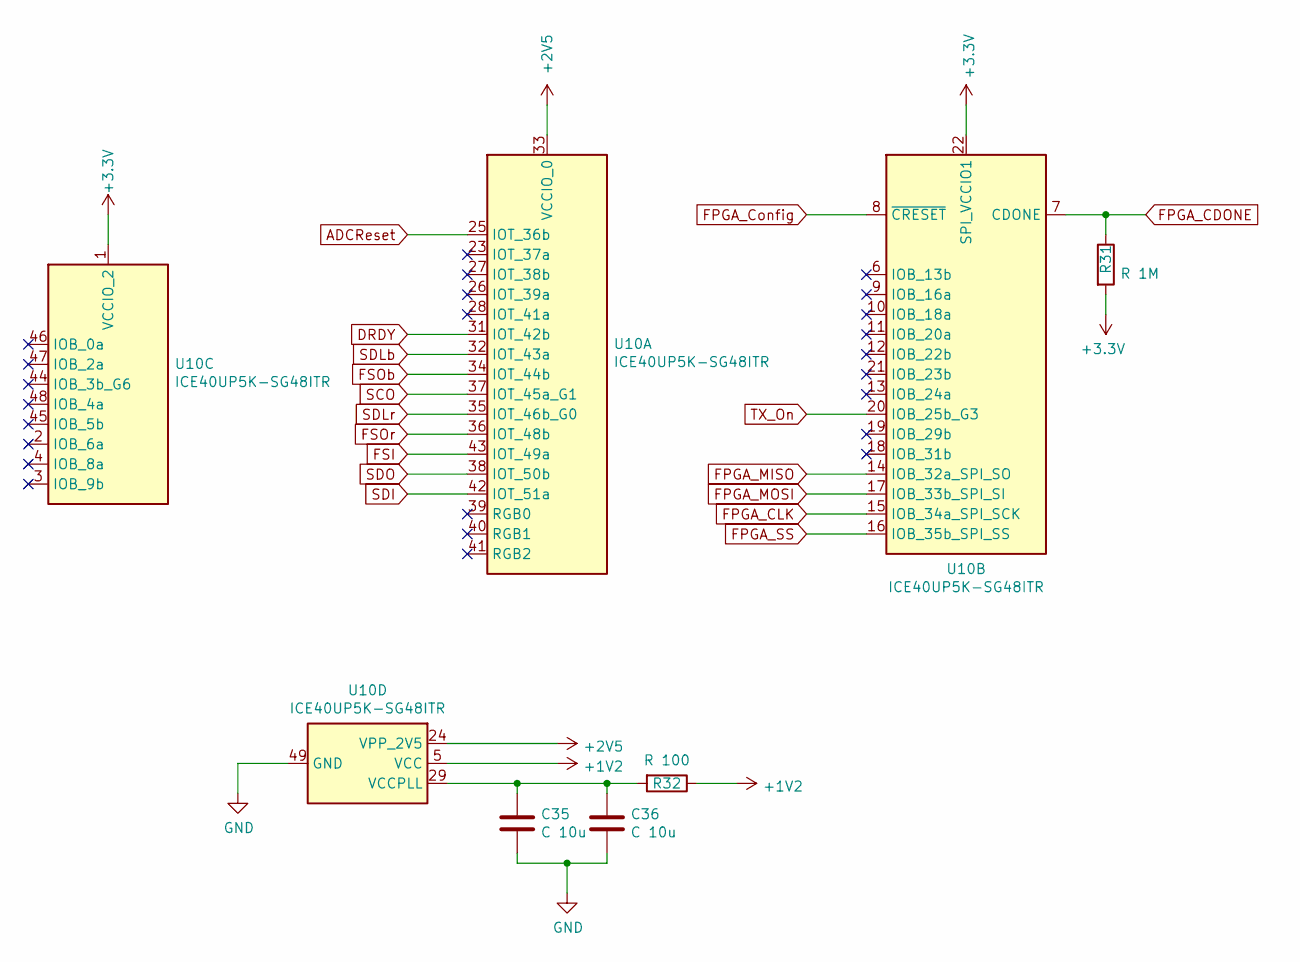
[picture p48: schematic file5D3AC028.sch, Pancreas EMI Conductivity Meter]

Parts:
C35, C36: C 10u; C_1210_3225Metric_Pad1.42x2.65mm_HandSolder
R31: R 1M; R_1206_3216Metric_Pad1.42x1.75mm_HandSolder
R32: R 100; R_1206_3216Metric_Pad1.42x1.75mm_HandSolder
U10: ICE40UP5K-SG48ITR; QFN-48-1EP_7x7mm_P0.5mm_EP5.6x5.6mm

Connections:
+1V2: R32.1, U10.5 (VCC), U10.30 (VCC); also elsewhere on the board
+2V5: U10.24 (VPP_2V5), U10.33 (VCCIO_0); also elsewhere on the board
ADCReset: U10.25 (IOT_36b); also elsewhere on the board
ADR0r: C35.2, C36.2, U10.49 (GND); also elsewhere on the board
DRDY: U10.31 (IOT_42b); also elsewhere on the board
FPGA_CDONE: R31.1, U10.7 (CDONE); also elsewhere on the board
FPGA_CLK: U10.15 (IOB_34a_SPI_SCK); also elsewhere on the board
FPGA_Config: U10.8 (~CRESET); also elsewhere on the board
FPGA_MISO: U10.14 (IOB_32a_SPI_SO); also elsewhere on the board
FPGA_MOSI: U10.17 (IOB_33b_SPI_SI); also elsewhere on the board
FPGA_SS: U10.16 (IOB_35b_SPI_SS); also elsewhere on the board
FSI: U10.43 (IOT_49a); also elsewhere on the board
FSOb: U10.34 (IOT_44b); also elsewhere on the board
FSOr: U10.36 (IOT_48b); also elsewhere on the board
unnamed: C35.1, C36.1, R32.2, U10.29 (VCCPLL)
SCO: U10.37 (IOT_45a_G1); also elsewhere on the board
SDI: U10.42 (IOT_51a); also elsewhere on the board
SDLb: U10.32 (IOT_43a); also elsewhere on the board
SDLr: U10.35 (IOT_46b_G0); also elsewhere on the board
SDO: U10.38 (IOT_50b); also elsewhere on the board
TX_On: U10.20 (IOB_25b_G3); also elsewhere on the board
VDD1: R31.2, U10.1 (VCCIO_2), U10.22 (SPI_VCCIO1); also elsewhere on the board

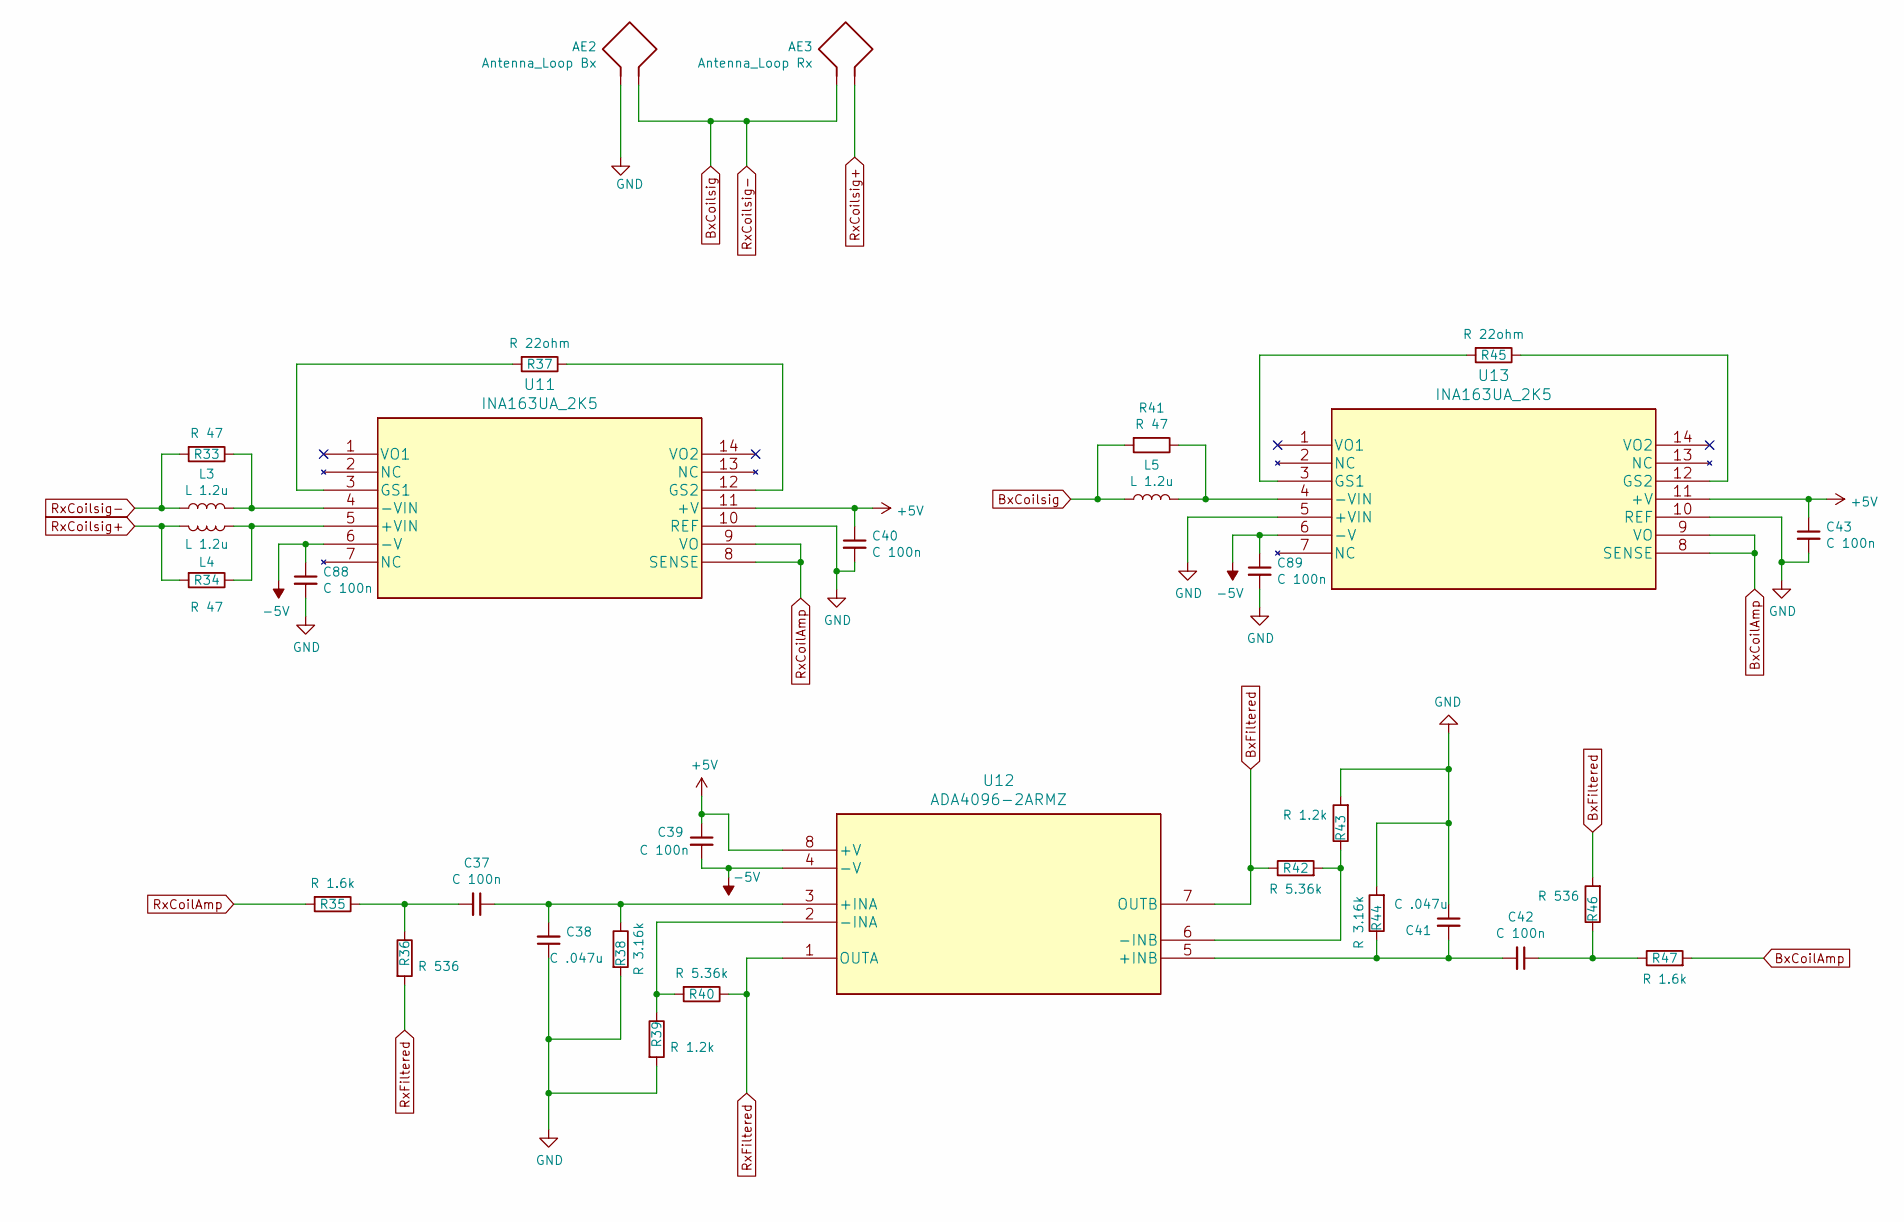
[picture p49: schematic file5DAF1840.sch, Pancreas EMI Conductivity Meter]

Parts:
AE2: Antenna_Loop Bx; SMA_Molex_73251-2200_Horizontal
AE3: Antenna_Loop Rx; SMA_Molex_73251-2200_Horizontal
C37, C42: C 100n; C_1812_4532Metric_Pad1.30x3.40mm_HandSolder
C38, C41: C .047u; C_0805_2012Metric_Pad1.15x1.40mm_HandSolder
C39: C 100n; C_0603_1608Metric_Pad1.05x0.95mm_HandSolder
C40, C43, C88, C89: C 100n; CP_EIA-3216-18_Kemet-A_Pad1.58x1.35mm_HandSolder
L3, L4, L5: L 1.2u; AISC-1008-1R2G-T
R33, R34, R41: R 47; R_1206_3216Metric_Pad1.42x1.75mm_HandSolder
R35, R47: R 1.6k; R_0805_2012Metric_Pad1.15x1.40mm_HandSolder
R36, R46: R 536; R_0805_2012Metric_Pad1.15x1.40mm_HandSolder
R37, R45: R 22ohm; R_0805_2012Metric_Pad1.15x1.40mm_HandSolder
R38, R44: R 3.16k; R_0805_2012Metric_Pad1.15x1.40mm_HandSolder
R39, R43: R 1.2k; R_0805_2012Metric_Pad1.15x1.40mm_HandSolder
R40, R42: R 5.36k; R_0805_2012Metric_Pad1.15x1.40mm_HandSolder
U11, U13: INA163UA_2K5; INA163UA&slash_2K5
U12: ADA4096-2ARMZ

Connections:
+5V: C39.1, C40.1, C43.1, U11.11 (+V), U12.8 (+V), U13.11 (+V); also elsewhere on the board
-5V: C39.2, C88.1, C89.1, U11.6 (-V), U12.4 (-V), U13.6 (-V); also elsewhere on the board
ADR0r: AE2.2, C38.1, C40.2, C41.1, C43.2, C88.2, C89.2, R38.2, R39.2, R43.2, R44.2, U11.10 (REF), U13.5 (+VIN), U13.10 (REF); also elsewhere on the board
BxCoilAmp: R47.2, U13.8 (SENSE), U13.9 (VO)
BxCoilsig: AE2.1, AE3.2, L3.1, L5.1, R33.2, R41.2
BxFiltered: R42.1, R46.2, U12.7 (OUTB); also elsewhere on the board
unnamed: C37.1, C38.2, R38.1, U12.3 (+INA)
unnamed: C37.2, R35.1, R36.1
unnamed: C41.2, C42.2, R44.1, U12.5 (+INB)
unnamed: C42.1, R46.1, R47.1
unnamed: L3.2, R33.1, U11.4 (-VIN)
unnamed: L4.1, R34.1, U11.5 (+VIN)
unnamed: L5.2, R41.1, U13.4 (-VIN)
unnamed: R37.1, U11.12 (GS2)
unnamed: R37.2, U11.3 (GS1)
unnamed: R39.1, R40.2, U12.2 (-INA)
unnamed: R42.2, R43.1, U12.6 (-INB)
unnamed: R45.1, U13.12 (GS2)
unnamed: R45.2, U13.3 (GS1)
RxCoilAmp: R35.2, U11.8 (SENSE), U11.9 (VO)
RxCoilsig+: AE3.1, L4.2, R34.2
RxFiltered: R36.2, R40.1, U12.1 (OUTA); also elsewhere on the board

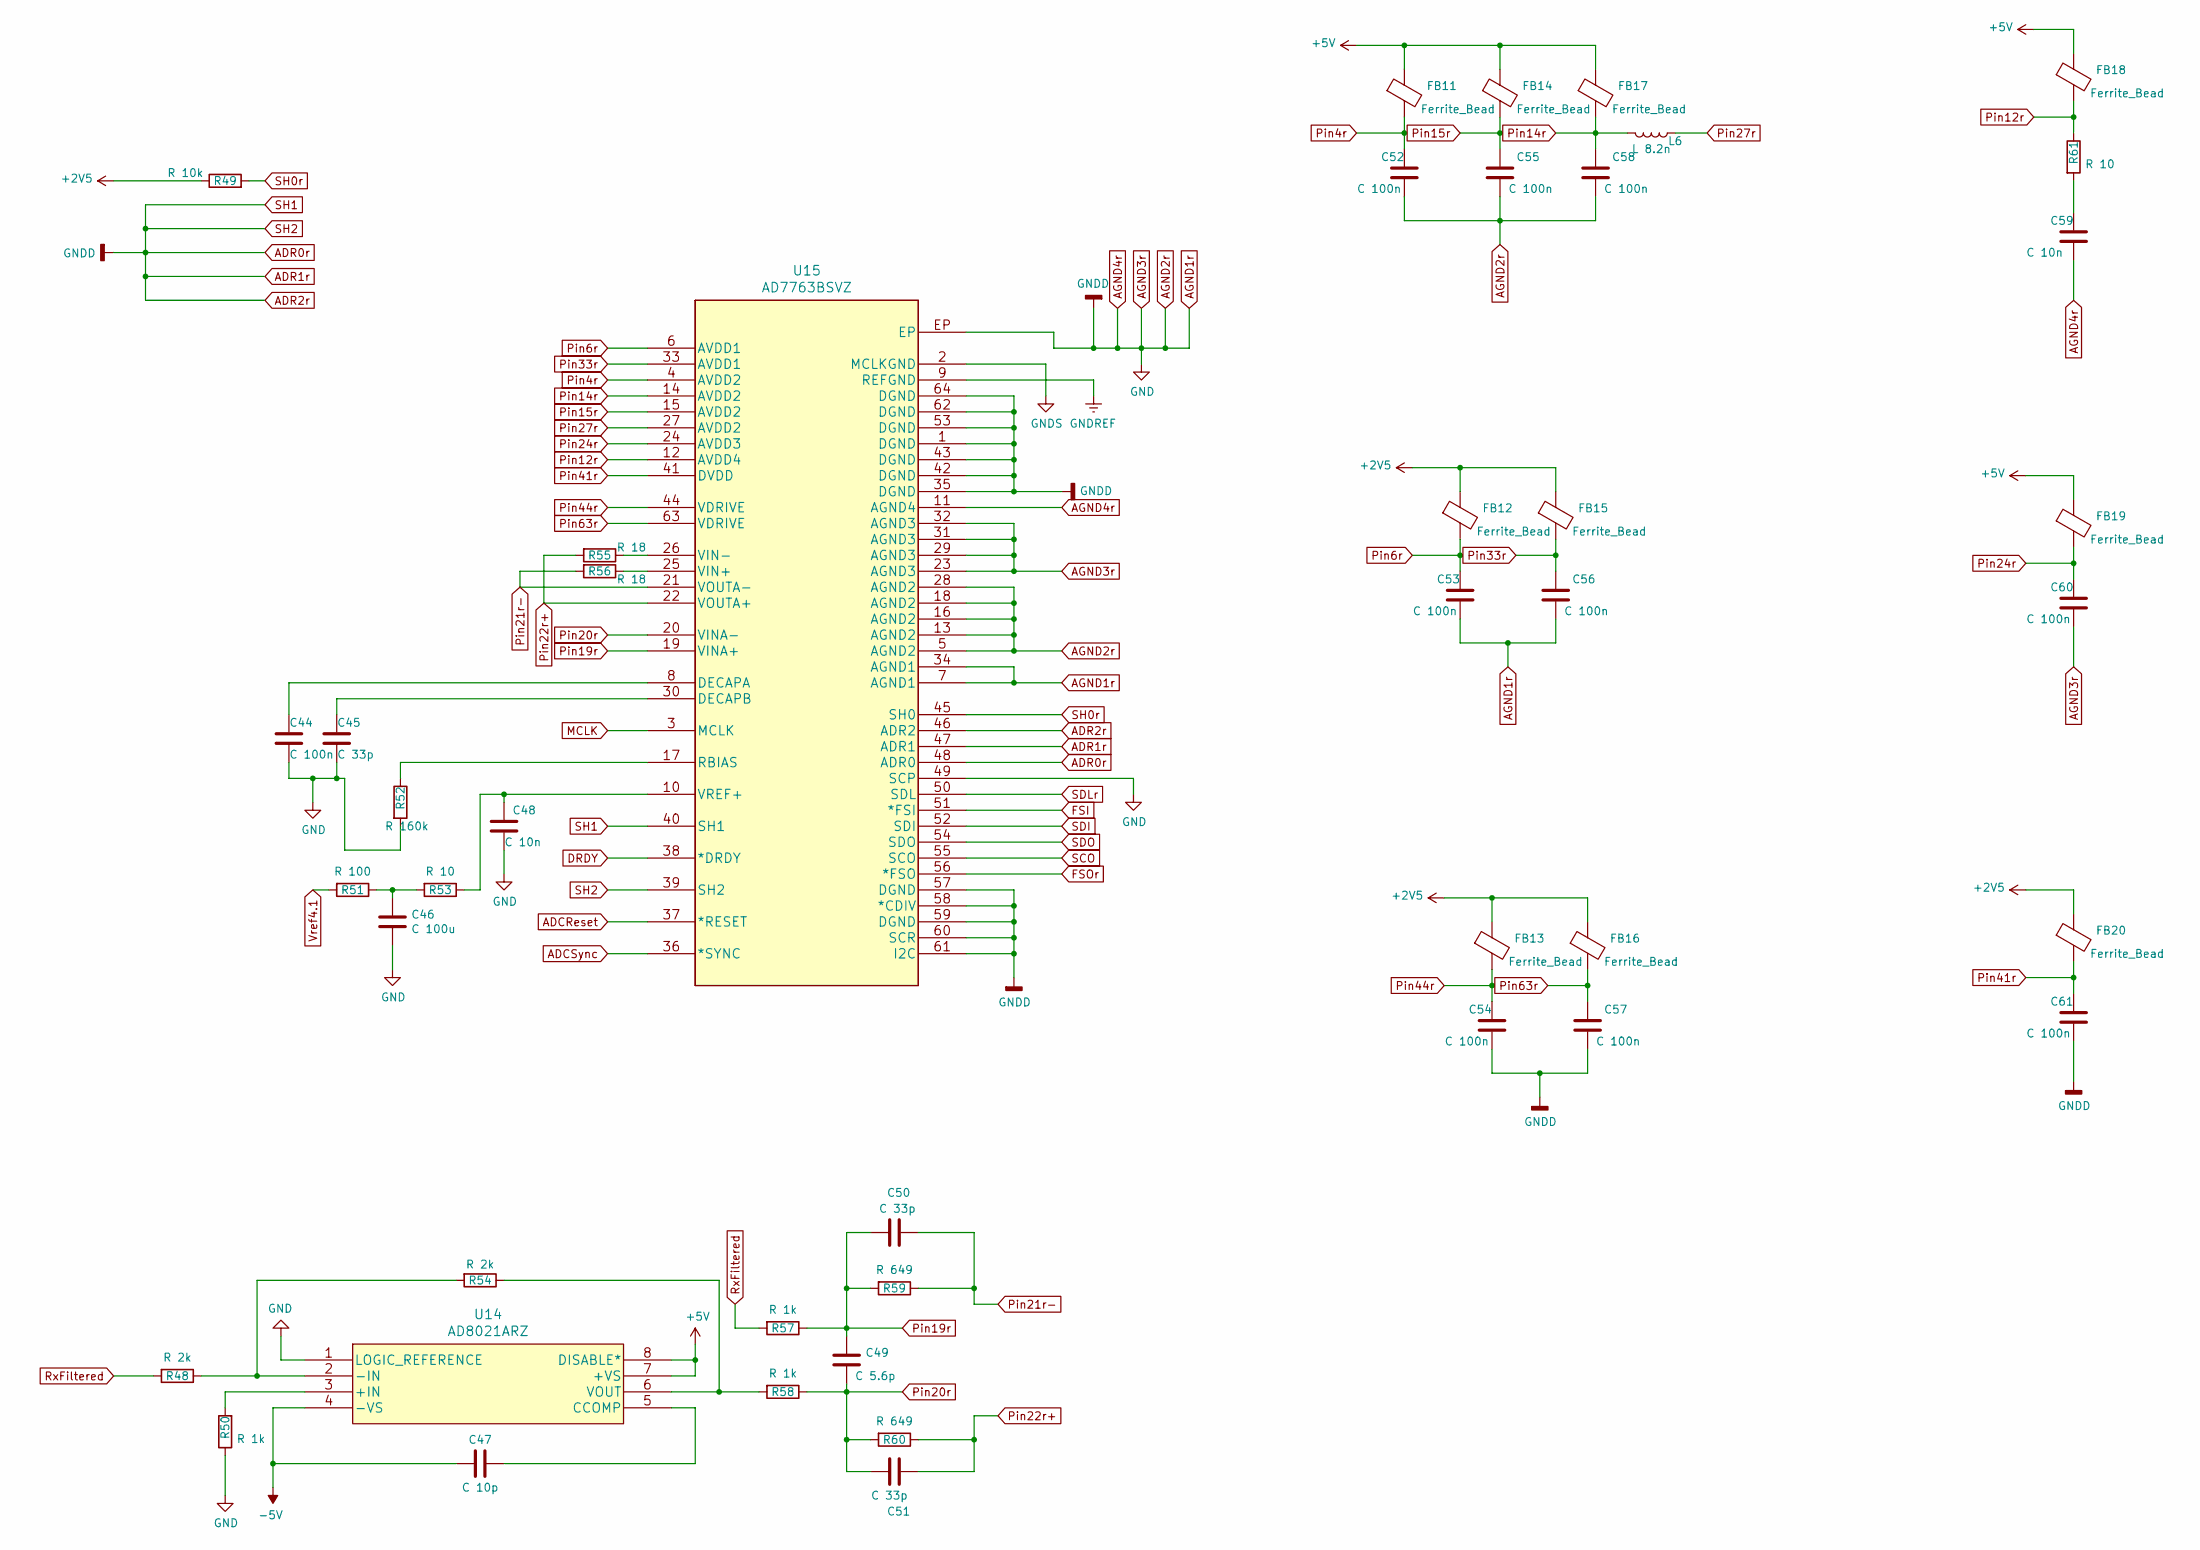
[picture p50: schematic file5D43B00F.sch, Pancreas EMI Conductivity Meter]

Parts:
C44, C52, C53, C54, C55, C56, C57, C58, C60, C61: C 100n; C_0603_1608Metric_Pad1.05x0.95mm_HandSolder
C45, C50, C51: C 33p; C_0402_1005Metric
C46: C 100u; CP_EIA-7343-30_AVX-N_Pad2.25x2.55mm_HandSolder
C47: C 10p; C_0805_2012Metric_Pad1.15x1.40mm_HandSolder
C48, C59: C 10n; C_0805_2012Metric_Pad1.15x1.40mm_HandSolder
C49: C 5.6p; C_0402_1005Metric
FB11, FB12, FB13, FB14, FB15, FB16, FB17, FB18, FB19, FB20: Ferrite_Bead; C_0603_1608Metric_Pad1.05x0.95mm_HandSolder
L6: L 8.2n; L_0603_1608Metric_Pad1.05x0.95mm_HandSolder
R48, R54: R 2k; R_0805_2012Metric_Pad1.15x1.40mm_HandSolder
R49: R 10k; R_1206_3216Metric_Pad1.42x1.75mm_HandSolder
R50, R57, R58: R 1k; R_0805_2012Metric_Pad1.15x1.40mm_HandSolder
R51: R 100; R_1206_3216Metric_Pad1.42x1.75mm_HandSolder
R52: R 160k; R_1206_3216Metric_Pad1.42x1.75mm_HandSolder
R53, R61: R 10; R_1206_3216Metric_Pad1.42x1.75mm_HandSolder
R55, R56: R 18; R_0805_2012Metric_Pad1.15x1.40mm_HandSolder
R59, R60: R 649; R_0805_2012Metric_Pad1.15x1.40mm_HandSolder
U14: AD8021ARZ
U15: AD7763BSVZ

Connections:
+2V5: FB12.1, FB13.1, FB15.1, FB16.1, FB20.1, R49.1; also elsewhere on the board
+5V: FB11.1, FB14.1, FB17.1, FB18.1, FB19.1, U14.7 (+VS), U14.8 (DISABLE*); also elsewhere on the board
-5V: C47.2, U14.4 (-VS); also elsewhere on the board
ADCReset: U15.37 (*RESET); also elsewhere on the board
ADCSync: U15.36 (*SYNC); also elsewhere on the board
ADR0r: C44.2, C45.2, C46.2, C48.2, C52.2, C53.2, C54.2, C55.2, C56.2, C57.2, C58.2, C59.2, C60.2, C61.2, R50.1, R52.2, U14.1 (LOGIC_REFERENCE), U15.1 (DGND), U15.2 (MCLKGND), U15.5 (AGND2), U15.7 (AGND1), U15.9 (REFGND), U15.11 (AGND4), U15.13 (AGND2), U15.16 (AGND2), U15.18 (AGND2), U15.23 (AGND3), U15.28 (AGND2), U15.29 (AGND3), U15.31 (AGND3), U15.32 (AGND3), U15.34 (AGND1), U15.35 (DGND), U15.39 (SH2), U15.40 (SH1), U15.42 (DGND), U15.43 (DGND), U15.46 (ADR2), U15.47 (ADR1), U15.48 (ADR0), U15.49 (SCP), U15.53 (DGND), U15.57 (DGND), U15.58 (*CDIV), U15.59 (DGND), U15.60 (SCR), U15.61 (I2C), U15.62 (DGND), U15.64 (DGND), U15.EP; also elsewhere on the board
DRDY: U15.38 (*DRDY); also elsewhere on the board
FSI: U15.51 (*FSI); also elsewhere on the board
FSOr: U15.56 (*FSO); also elsewhere on the board
MCLK: U15.3 (MCLK); also elsewhere on the board
unnamed: C44.1, U15.8 (DECAPA)
unnamed: C45.1, U15.30 (DECAPB)
unnamed: C46.1, R51.1, R53.2
unnamed: C47.1, U14.5 (CCOMP)
unnamed: C48.1, R53.1, U15.10 (VREF+)
unnamed: C59.1, R61.2
unnamed: R48.1, R54.2, U14.2 (-IN)
unnamed: R50.2, U14.3 (+IN)
unnamed: R52.1, U15.17 (RBIAS)
unnamed: R54.1, R58.2, U14.6 (VOUT)
unnamed: R55.1, U15.26 (VIN-)
unnamed: R56.1, U15.25 (VIN+)
Pin4r: C52.1, FB11.2, U15.4 (AVDD2)
Pin6r: C53.1, FB12.2, U15.6 (AVDD1)
Pin12r: FB18.2, R61.1, U15.12 (AVDD4)
Pin14r: C58.1, FB17.2, L6.2, U15.14 (AVDD2)
Pin15r: C55.1, FB14.2, U15.15 (AVDD2)
Pin19r: C49.1, C50.2, R57.1, R59.2, U15.19 (VINA+)
Pin20r: C49.2, C51.2, R58.1, R60.2, U15.20 (VINA-)
Pin21r-: C50.1, R56.2, R59.1, U15.21 (VOUTA-)
Pin22r+: C51.1, R55.2, R60.1, U15.22 (VOUTA+)
Pin24r: C60.1, FB19.2, U15.24 (AVDD3)
Pin27r: L6.1, U15.27 (AVDD2)
Pin33r: C56.1, FB15.2, U15.33 (AVDD1)
Pin41r: C61.1, FB20.2, U15.41 (DVDD)
Pin44r: C54.1, FB13.2, U15.44 (VDRIVE)
Pin63r: C57.1, FB16.2, U15.63 (VDRIVE)
RxFiltered: R48.2, R57.2; also elsewhere on the board
SCO: U15.55 (SCO); also elsewhere on the board
SDI: U15.52 (SDI); also elsewhere on the board
SDLr: U15.50 (SDL); also elsewhere on the board
SDO: U15.54 (SDO); also elsewhere on the board
SH0r: R49.2, U15.45 (SH0)
Vref4.1: R51.2; also elsewhere on the board

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
