95jasmith/EMI-sensor/Building sensor/Designs/EMI_sensor_control_Rev1.0/EMI_sensor_control_Rev1.0.kicad_pcb

## KiCad design Building sensor/Designs/EMI_sensor_control_Rev1.0/EMI_sensor_control_Rev1.0.kicad_pcb (continued)

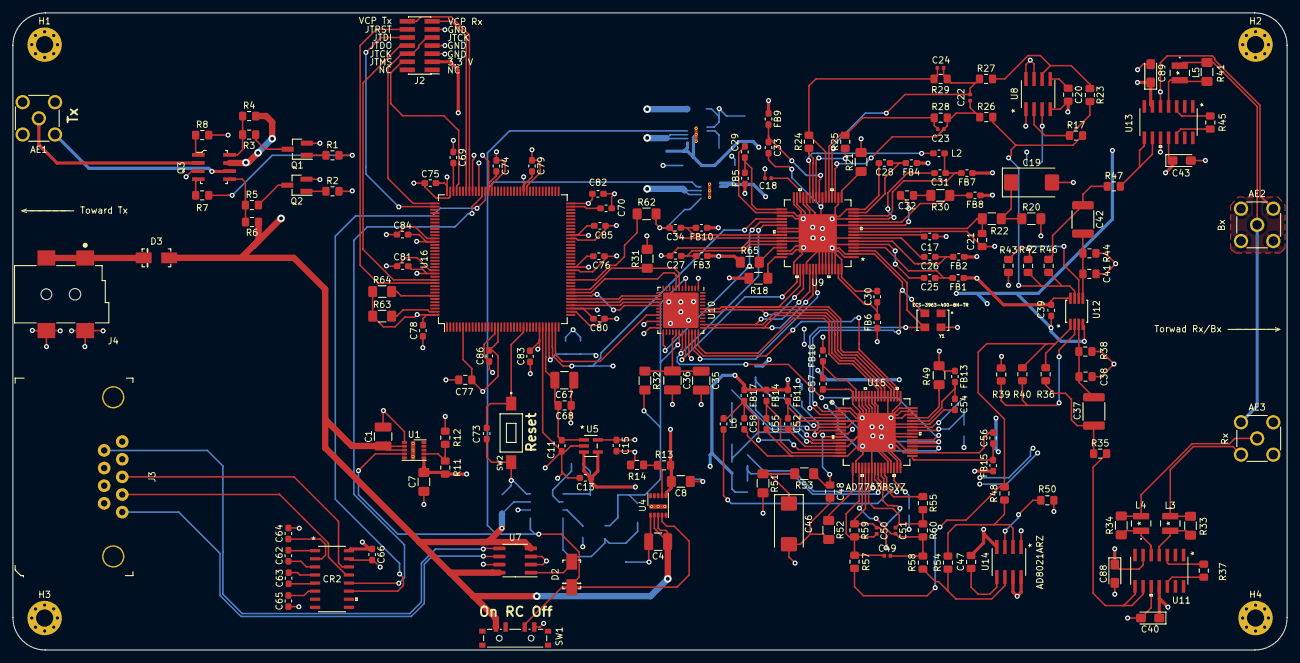
[picture p51: board EMI_sensor_control_Rev1.0.kicad_pcb from above]

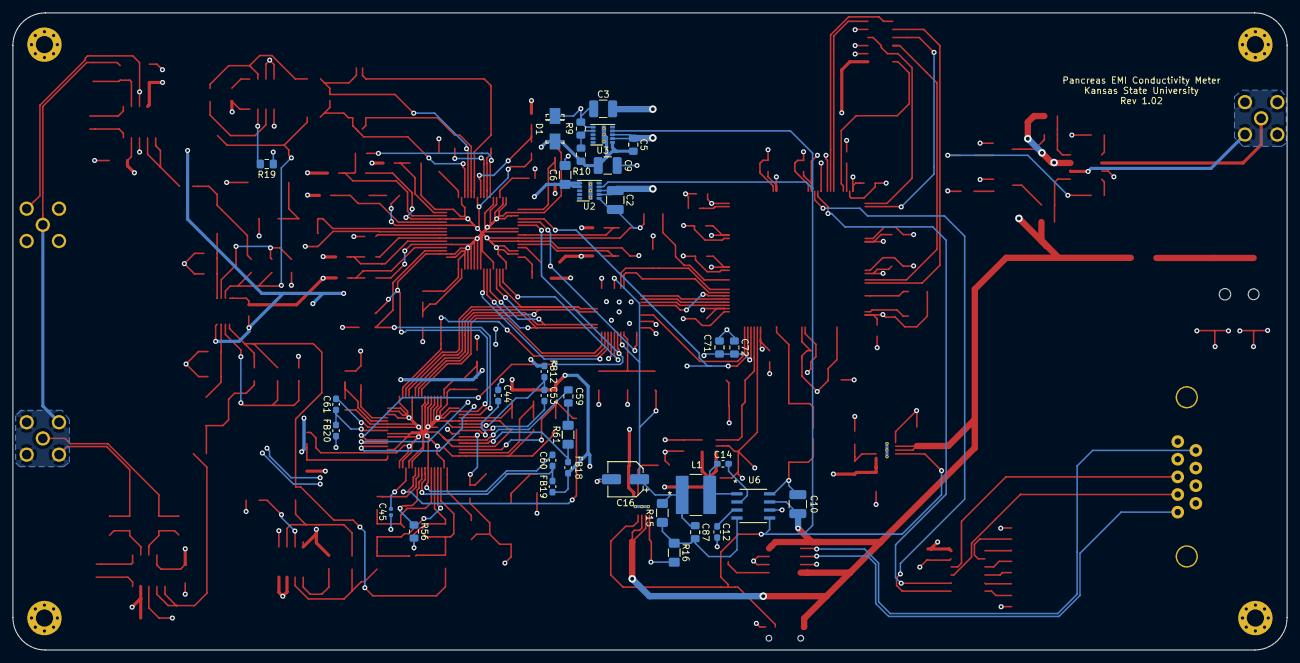
[picture p52: board EMI_sensor_control_Rev1.0.kicad_pcb from below]

Board: 4 copper layers, 200.0 x 100.0 mm, 216 parts (34 on the bottom side), 152 nets.
