95jasmith/EMI-sensor/Building sensor/Code/STM32/EMI_Sensor_rev_2/EMI_Sensor_rev_2.ioc

Mcu.UserName=STM32F746VGTx
PA0/WKUP.GPIO_Label=STAT_LED_0
PA0/WKUP.Signal=GPIO_Output
PA1.GPIO_Label=STAT_LED_1
PA1.Signal=GPIO_Output
PA10.GPIO_Label=VCP_Rx
PA10.Signal=USART1_RX
PA13.Signal=SYS_JTMS-SWDIO
PA14.Signal=SYS_JTCK-SWCLK
PA15.Signal=SYS_JTDI
PA2.GPIO_Label=USART_DO_Tx
PA2.Signal=USART2_TX
PA3.GPIO_Label=USART_DO_Rx
PA3.Signal=USART2_RX
PA4.Signal=SPI1_NSS
PA5.Signal=SPI1_SCK
PA6.Signal=SPI1_MISO
PA7.Signal=SPI1_MOSI
PA9.GPIO_Label=VCP_Tx
PA9.Signal=USART1_TX
PB0.GPIO_Label=I_Mon
PB0.Signal=ADCx_IN8
PB10.GPIO_Label=Bx_CLK
PB10.Signal=SPI2_SCK
PB11.GPIO_Label=ADC_Sync
PB11.Signal=GPIO_Output
PB12.GPIO_Label=Bx_CS
PB12.Signal=SPI2_NSS
PB13.GPIO_Label=Bx_DRDY
PB13.Signal=GPIO_Input
PB14.GPIO_Label=Bx_MISO
PB14.Signal=SPI2_MISO
PB15.GPIO_Label=Bx_MOSI
PB15.Signal=SPI2_MOSI
PB3.Signal=SYS_JTDO-SWO
PB4.Signal=SYS_JTRST
PC10.Signal=SDMMC1_D2
PC11.Signal=SDMMC1_D3
PC12.Signal=SDMMC1_CK
PC14/OSC32_IN.GPIO_Label=Tx_OTW
PC14/OSC32_IN.Signal=GPXTI14
PC15/OSC32_OUT.GPIO_Label=Tx_Fault
PC15/OSC32_OUT.Signal=GPXTI15
PC4.GPIO_Label=Rx_DRDY
PC4.Signal=GPIO_Input
PC8.Signal=SDMMC1_D0
PC9.Signal=SDMMC1_D1
PD10.GPIO_Label=Rx_FIL0
PD10.Signal=GPIO_Output
PD11.GPIO_Label=Rx_FIL1
PD11.Signal=GPIO_Output
PD12.GPIO_Label=Bx_OSR0
PD12.Signal=GPIO_Output
PD13.GPIO_Label=Bx_OSR1
PD13.Signal=GPIO_Output
PD14.GPIO_Label=Rx_OSR0
PD14.Signal=GPIO_Output
PD15.GPIO_Label=Rx_OSR1
PD15.Signal=GPIO_Output
PD2.Signal=SDMMC1_CMD
PD4.GPIO_Label=Bx_START
PD4.Signal=GPIO_Output
PD5.GPIO_Label=Rx_START
PD5.Signal=GPIO_Output
PD6.GPIO_Label=RSET_AD
PD6.Signal=GPIO_Output
PD7.GPIO_Label=RSET_CD
PD7.Signal=GPIO_Output
PD8.GPIO_Label=Bx_FIL0
PD8.Signal=GPIO_Output
PD9.GPIO_Label=Bx_FIL1
PD9.Signal=GPIO_Output
PE11.GPIO_Label=Tx_C2
PE11.Signal=S_TIM1_CH2
PE2.GPIO_Label=Tx_CLK
PE2.Signal=SPI4_SCK
PE4.GPIO_Label=Tx_CS
PE4.Signal=SPI4_NSS
PE5.GPIO_Label=Tx_MISO
PE5.Signal=SPI4_MISO
PE6.GPIO_Label=Tx_MOSI
PE6.Signal=SPI4_MOSI
PE9.GPIO_Label=Tx_C1
PE9.Signal=S_TIM1_CH1
PH0/OSC_IN.Signal=RCC_OSC_IN
PH1/OSC_OUT.Signal=RCC_OSC_OUT
