95jasmith/EMI-sensor/(commit log)

2019-07-16 Starting commit
    Uploading file from were I am up to this point
    [BANDPASS_DESIGN.DSN, Bandpass_design.opj, EMI_sensor_control_Rev1.0.kicad_pcb, EMI_sensor_control_Rev1.0.sch, familylist_refdes.csv, file5D278C8E.sch, file5D2792E2.sch, file5D27CADE.sch]
2019-07-20 Weekly commit 7/20/2019
    Weekly commit 7/20/2019
    [01-xr-07jy-1ee_gem.EC.csv, 01-xr-07jy-1ee_gem.csv, 06-xr-18jy-118_gem.EC.csv, 06-xr-18jy-118_gem.csv, 07-xr-18jy-0f7_gem.EC.csv, 07-xr-18jy-0f7_gem.csv, 08-xr-18jy-1c7_gem.EC.csv, 08-xr-18jy-1c7_gem.csv]
2019-07-25 Weekly commit 7/25/19
    Weekly commit 7/25/19
    [EMI_sensor_control_Rev1.0.sch, file5D278C8E.sch, file5D2792E2.sch, file5D27CADE.sch, file5D3AC028.sch, file5D3E2E6E.sch, file5D43B00F.sch, file5D43B07A.sch]
2019-08-02 Weekly Push
    Weekly Push
    [01-xr-07jy-1ee_gem.EC.csv, 01-xr-07jy-1ee_gem.inv.csv, 07-xr-18jy-0f7_gem.inv.csv, 08-xr-18jy-1c7_gem.inv.csv, 09-xr-18jy-208_gem.inv.csv, Bandpass_design.opj, EMI_sensor_control_Rev1.0.sch, file5D278C8E.sch]
2019-08-09 Weekly Commit
    Weekly Commit 08/09/2019
    [07-xr-18jy-0f7_gem.inv.csv, 09-xr-18jy-208_gem.EC.csv, 09-xr-18jy-208_gem.inv.csv, BANDPASS_DESIGN.DSN, Bandpass_design.opj, EMI_sensor_control_Rev1.0.csv, file5D278C8E.sch, file5D2792E2.sch]
2019-08-13 End of Rev 1.01
    End of Rev 1.01 change will be made to Rx and Bx connection in 1.02
    [EMI_sensor_control_Rev1.0.kicad_pcb, file5D278C8E.sch, file5D2792E2.sch, file5D43B00F.sch, file5D43B07A.sch, file5DAF1840.sch]
2019-08-19 weekly commit
    weekly commit, First of Rev 1.02
    [EMI_sensor_control_Rev1.0-B_Cu.gbr, EMI_sensor_control_Rev1.0-B_Mask.gbr, EMI_sensor_control_Rev1.0-B_Paste.gbr, EMI_sensor_control_Rev1.0-B_SilkS.gbr, EMI_sensor_control_Rev1.0-Edge_Cuts.gbr, EMI_sensor_control_Rev1.0-F_Cu.gbr, EMI_sensor_control_Rev1.0-F_Mask.gbr, EMI_sensor_control_Rev1.0-F_Paste.gbr]
2019-08-27 Weekly Commit
    Weekly Commit 8/26/2019
    [11-xr-19au-21c_gem.EC.csv, 11-xr-19au-21c_gem.csv, 12-xr-19au-08f_gem.EC.csv, 12-xr-19au-08f_gem.csv, 13-xr-19au-0a9_gem.EC.csv, 13-xr-19au-0a9_gem.csv, 14-xr-19au-0dd_gem.EC.csv, 14-xr-19au-0dd_gem.csv]
2019-09-19 Commit 9/19/2019
    [01-xr-07jy-1ee_gem.EC.csv, 01-xr-07jy-1ee_gem.csv, 06-xr-18jy-118_gem.EC.csv, 06-xr-18jy-118_gem.csv, 07-xr-18jy-0f7_gem.EC.csv, 07-xr-18jy-0f7_gem.csv, 08-xr-18jy-1c7_gem.EC.csv, 08-xr-18jy-1c7_gem.csv]
2019-10-09 backup and V2 of board
    backup and version 2 of the PCB added
    [EMI_sensor_control_Rev2.0.kicad_pcb, EMI_sensor_control_Rev2.0.sch, file5D278C8E.sch, file5D2792E2.sch, file5D27CADE.sch, file5D3AC028.sch, file5D3E2E6E.sch, file5D43B00F.sch]
2019-10-24 Add Depth Estimate to Matlab
    Add Depth Estimate to Matlab plot functions for gem data
    [20-xr-19oc-152_gem.EC.csv, 20-xr-19oc-152_gem.csv, 21-xr-19oc-1ad_gem.EC.csv, 21-xr-19oc-1ad_gem.csv, 22-xr-19oc-215_gem.EC.csv, 22-xr-19oc-215_gem.csv, GEM-2 uniform half-space response and skin depth (2).xls, Toggle_Pin_Test_pin_table.CSV]
2019-12-03 overdue backup
    [23-xr-29oc-104_gem.EC.csv, 23-xr-29oc-104_gem.csv, 24-xr-29oc-122_gem.EC.csv, 24-xr-29oc-122_gem.csv, 25-xr-29oc-140_gem.EC.csv, 25-xr-29oc-140_gem.csv, EMI_sensor_control_Rev2.0.kicad_pcb, EMI_sensor_control_Rev2.0.sch]
2020-02-04 backup
    2/04/2020
    [file5D278C8E.sch, file5D2792E2.sch, file5D43B00F.sch, file5D43B07A.sch]
2020-02-27 Back up
    Backup of rev 2.0 for board
    [DDW44_8P26X4P31-L.step, DDW44_8P26X4P31-L.stl, DDW44_8P26X4P31-L.stp, DDW44_8P26X4P31-M.step, DDW44_8P26X4P31-M.stl, DDW44_8P26X4P31-M.stp, DDW44_8P26X4P31.step, DDW44_8P26X4P31.stl]
2020-05-07 Rev 2.0 Complete
    Rev 2.0 of PCB Completed
    SCHM, PCB layout, and gerber files generated
    [EMI_sensor_control_Rev2.0-B_Cu.gbr, EMI_sensor_control_Rev2.0-B_Mask.gbr, EMI_sensor_control_Rev2.0-B_Paste.gbr, EMI_sensor_control_Rev2.0-B_SilkS.gbr, EMI_sensor_control_Rev2.0-Edge_Cuts.gbr, EMI_sensor_control_Rev2.0-F_Cu.gbr, EMI_sensor_control_Rev2.0-F_Mask.gbr, EMI_sensor_control_Rev2.0-F_Paste.gbr]
2021-01-11 Final Push
    [gemdata.survey.GEM.csv, gemdata.survey.GPS.csv, gemdata2.survey.GEM.csv, gemdata2.survey.GPS.csv]
